fulivi/nanoprocessor_re/nanoprocessor.pdf

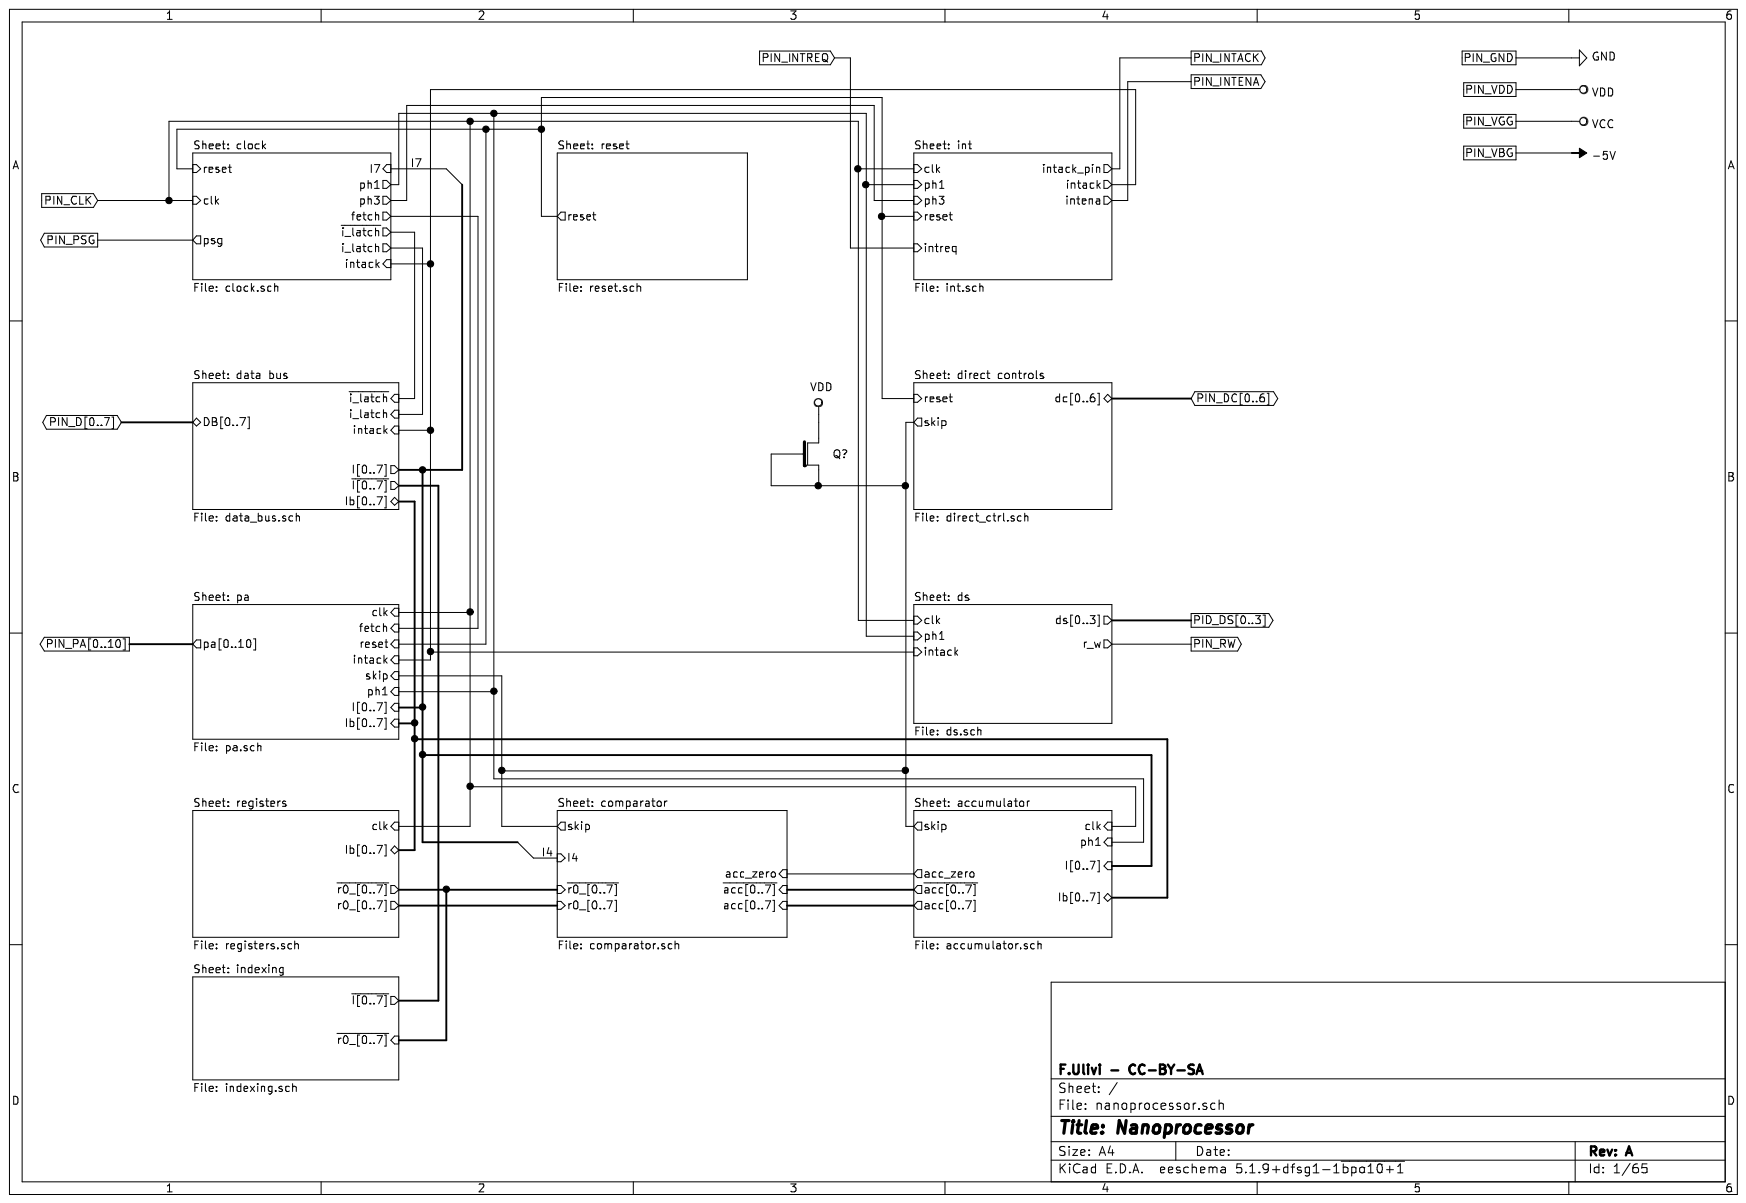
[picture p1: page 1]

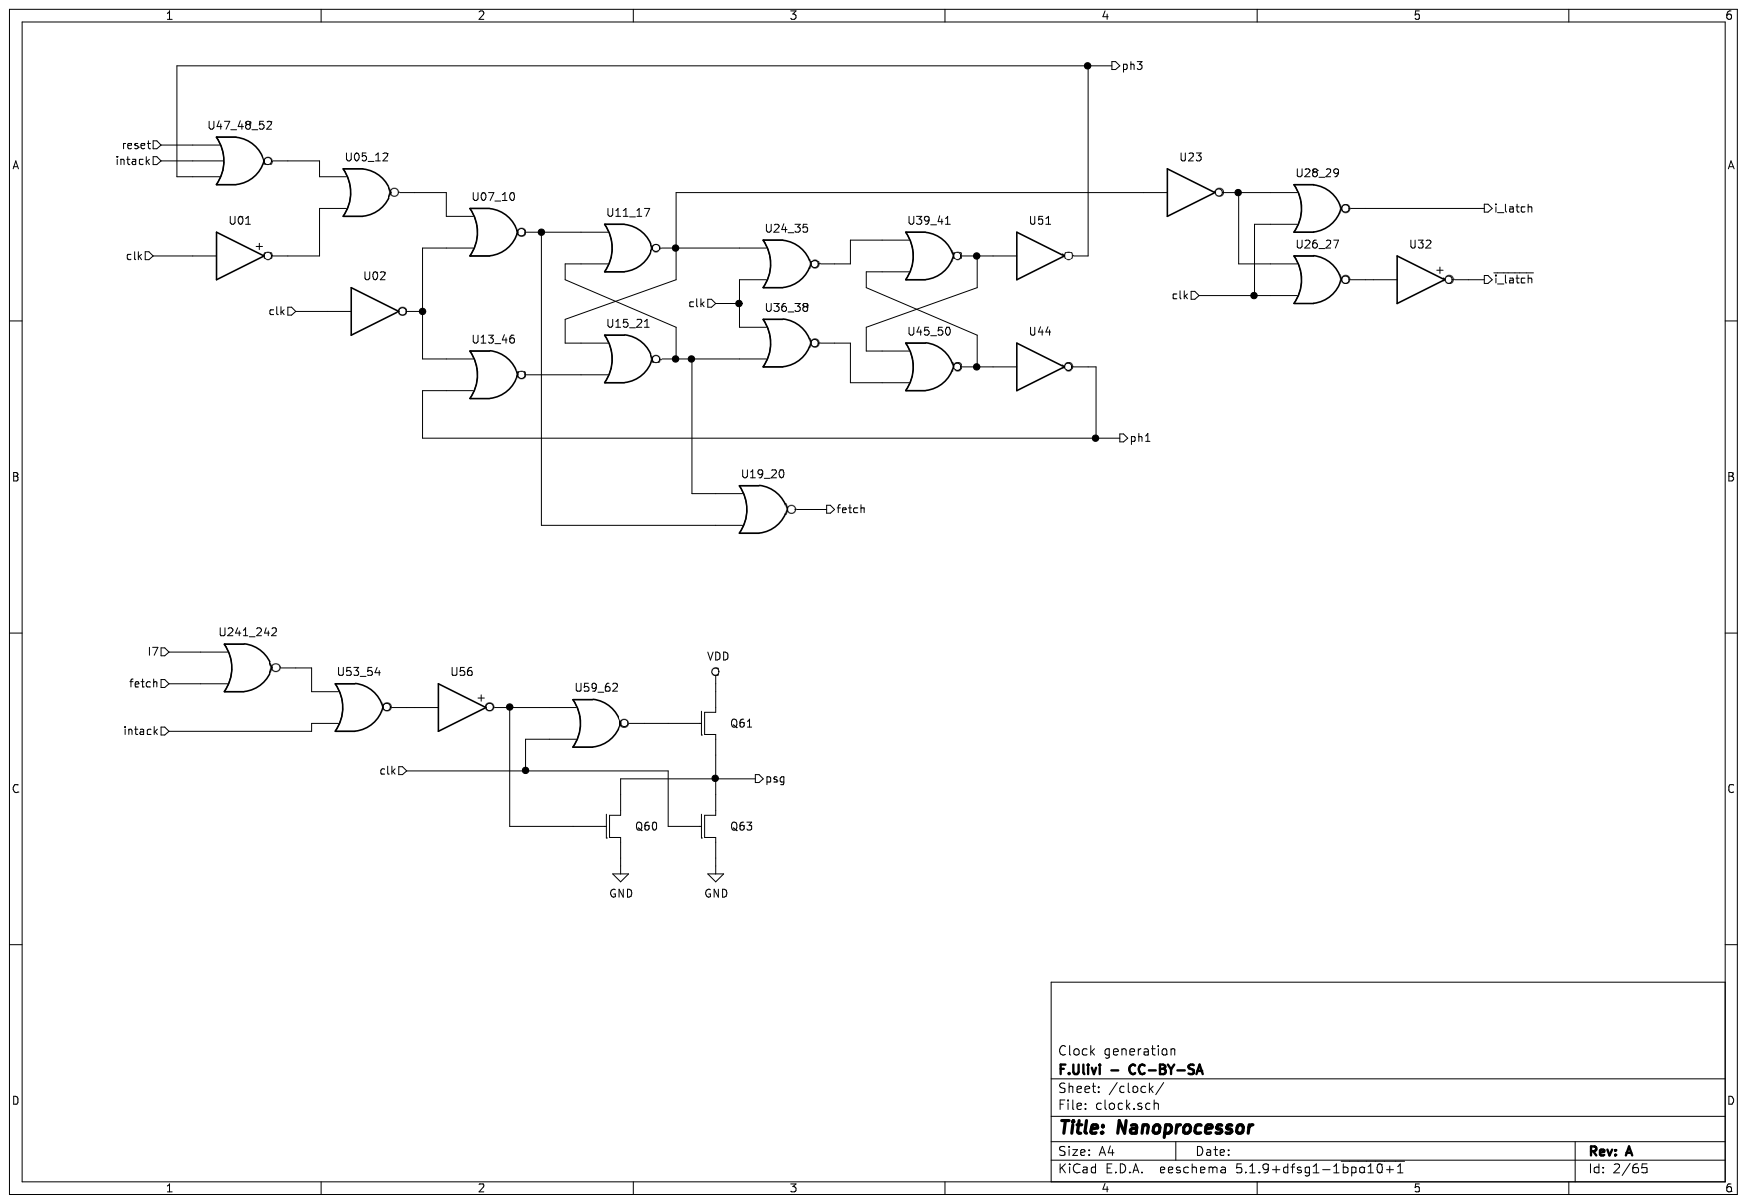
[picture p2: page 2]

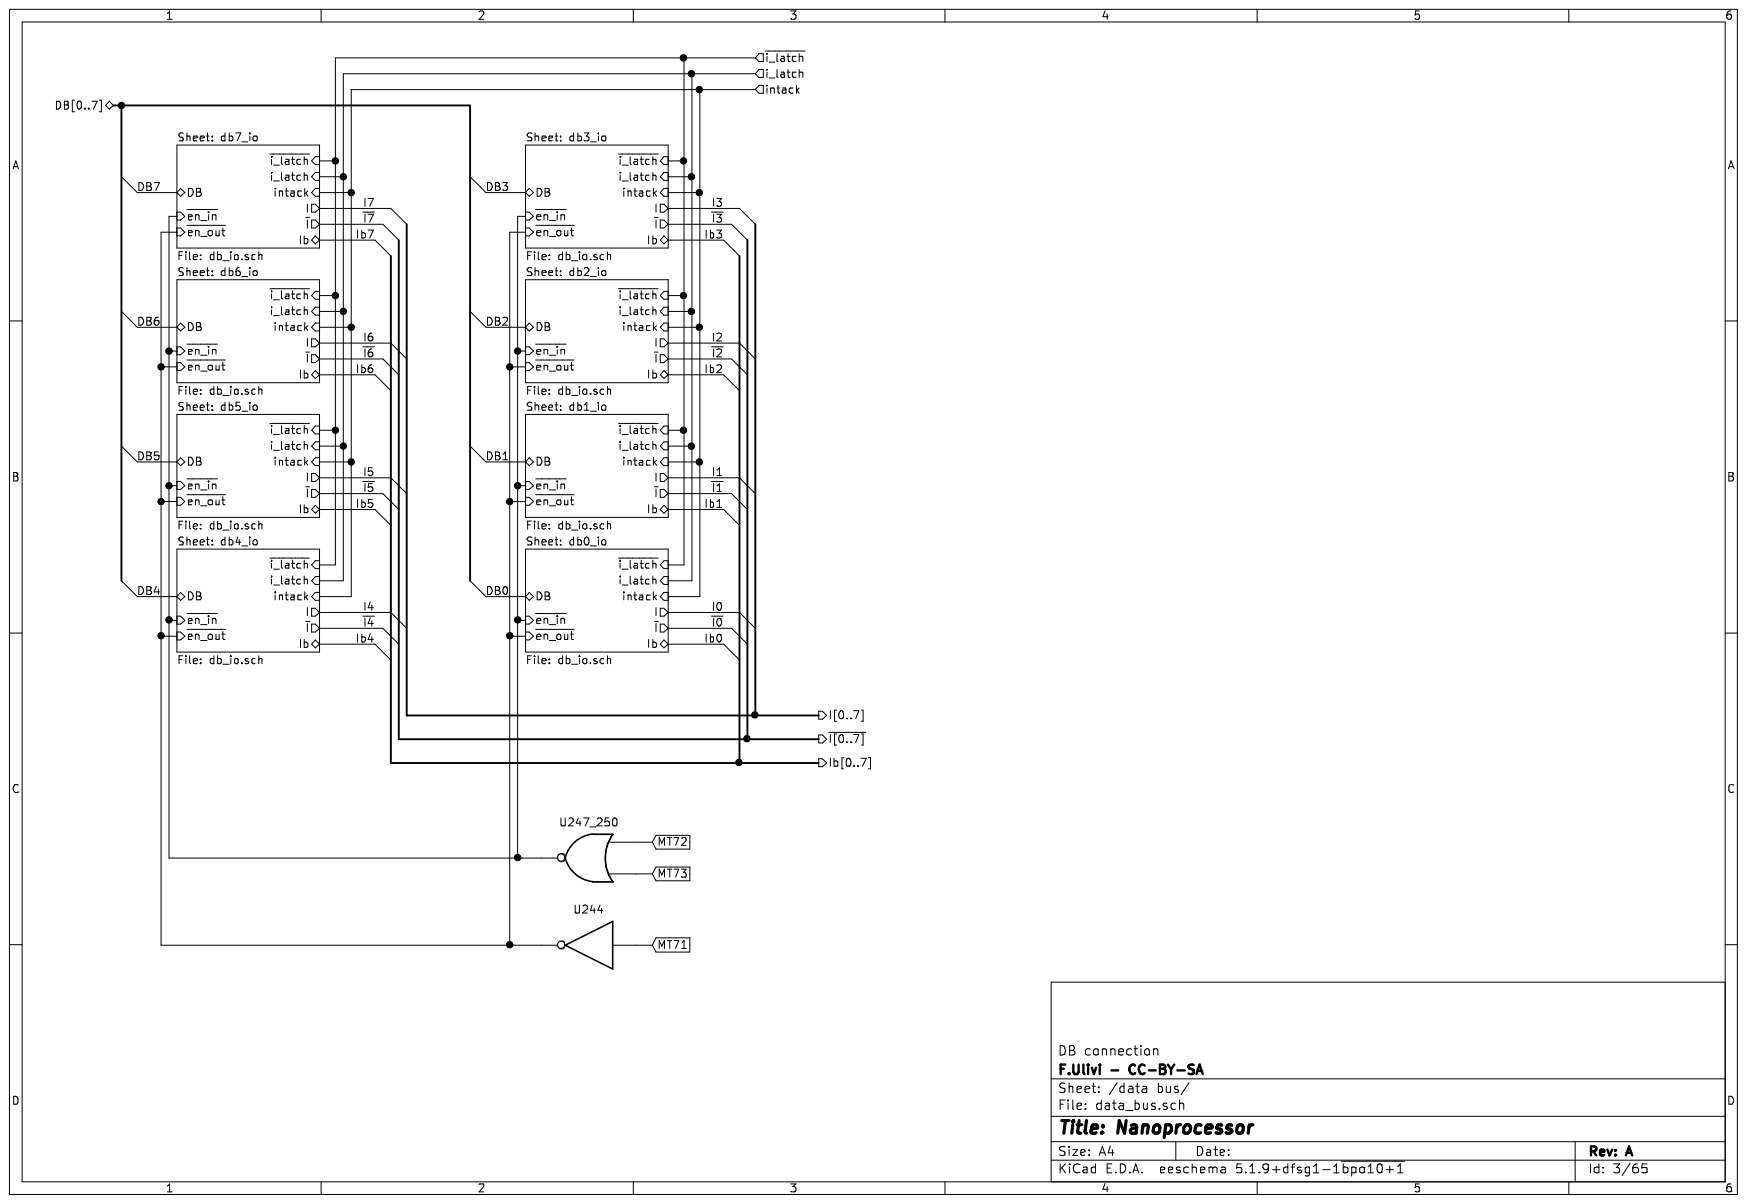
[picture p3: page 3]

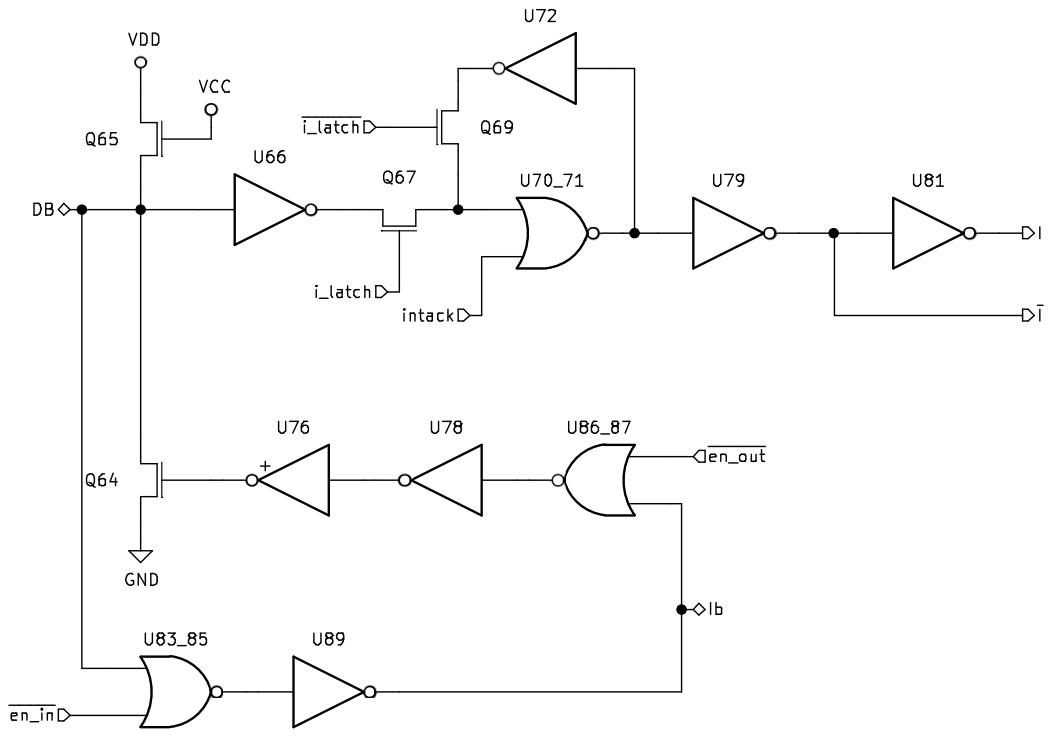
[picture p4: page 4]

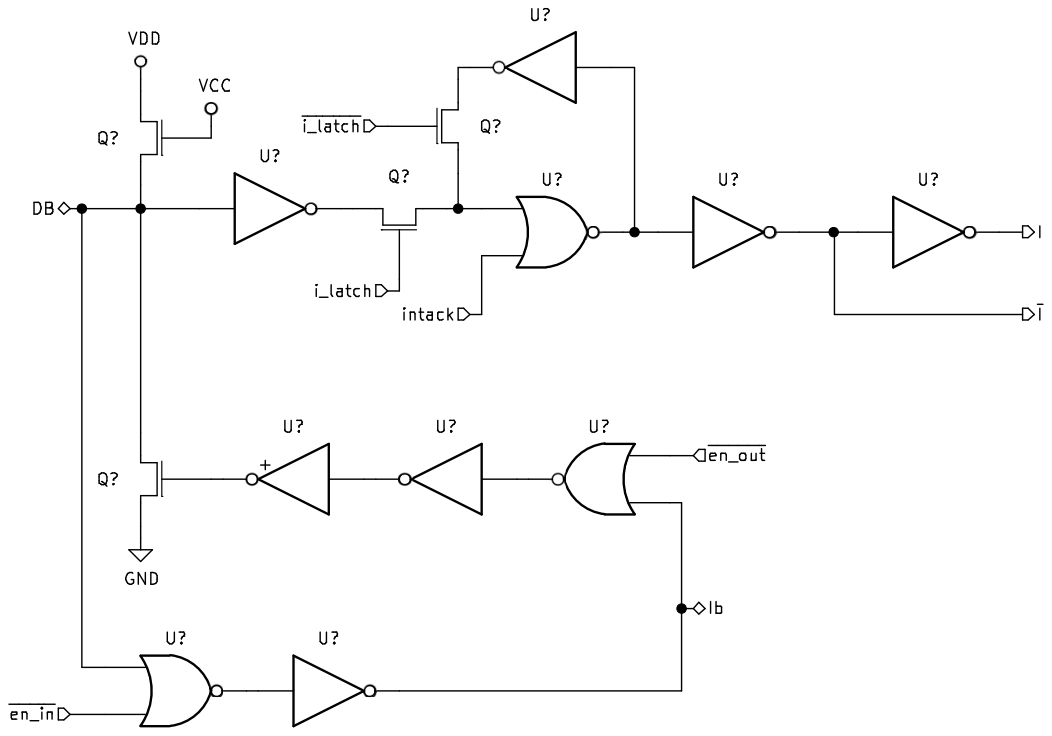
[picture p5: page 5]

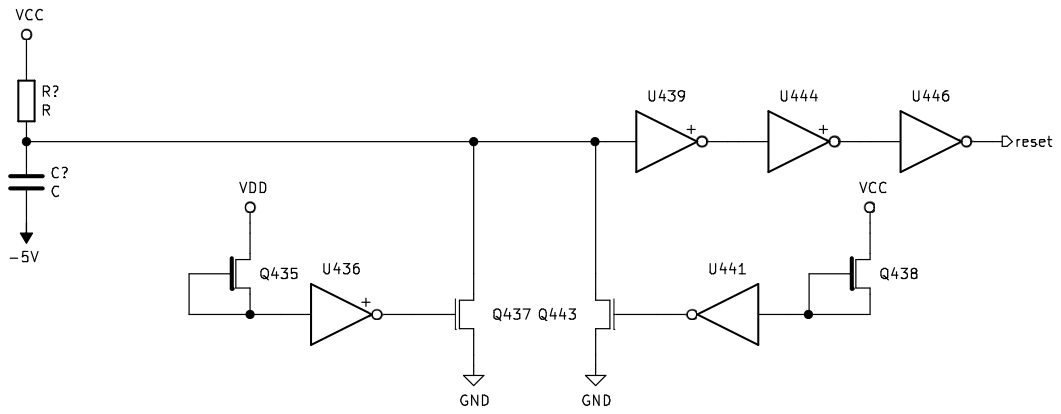
[picture p6: page 12]

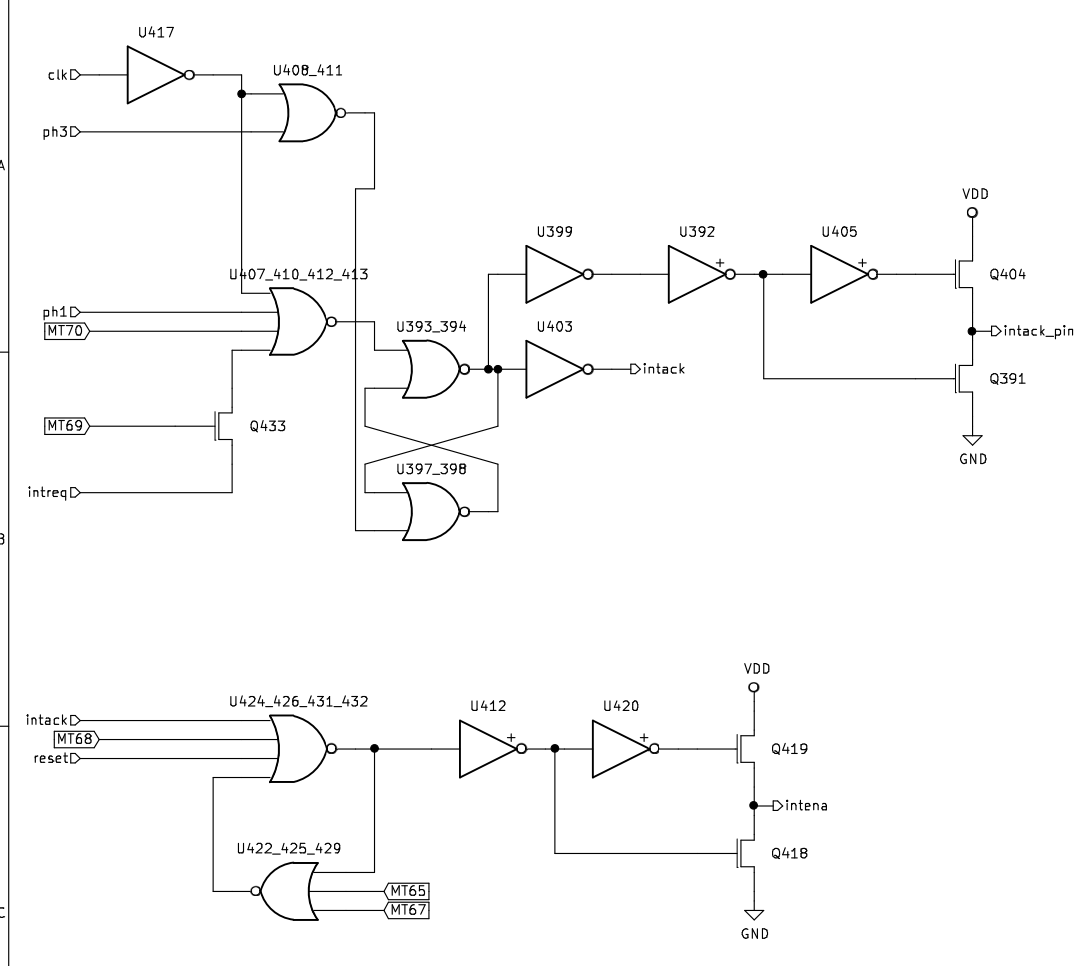
[picture p7: page 13]

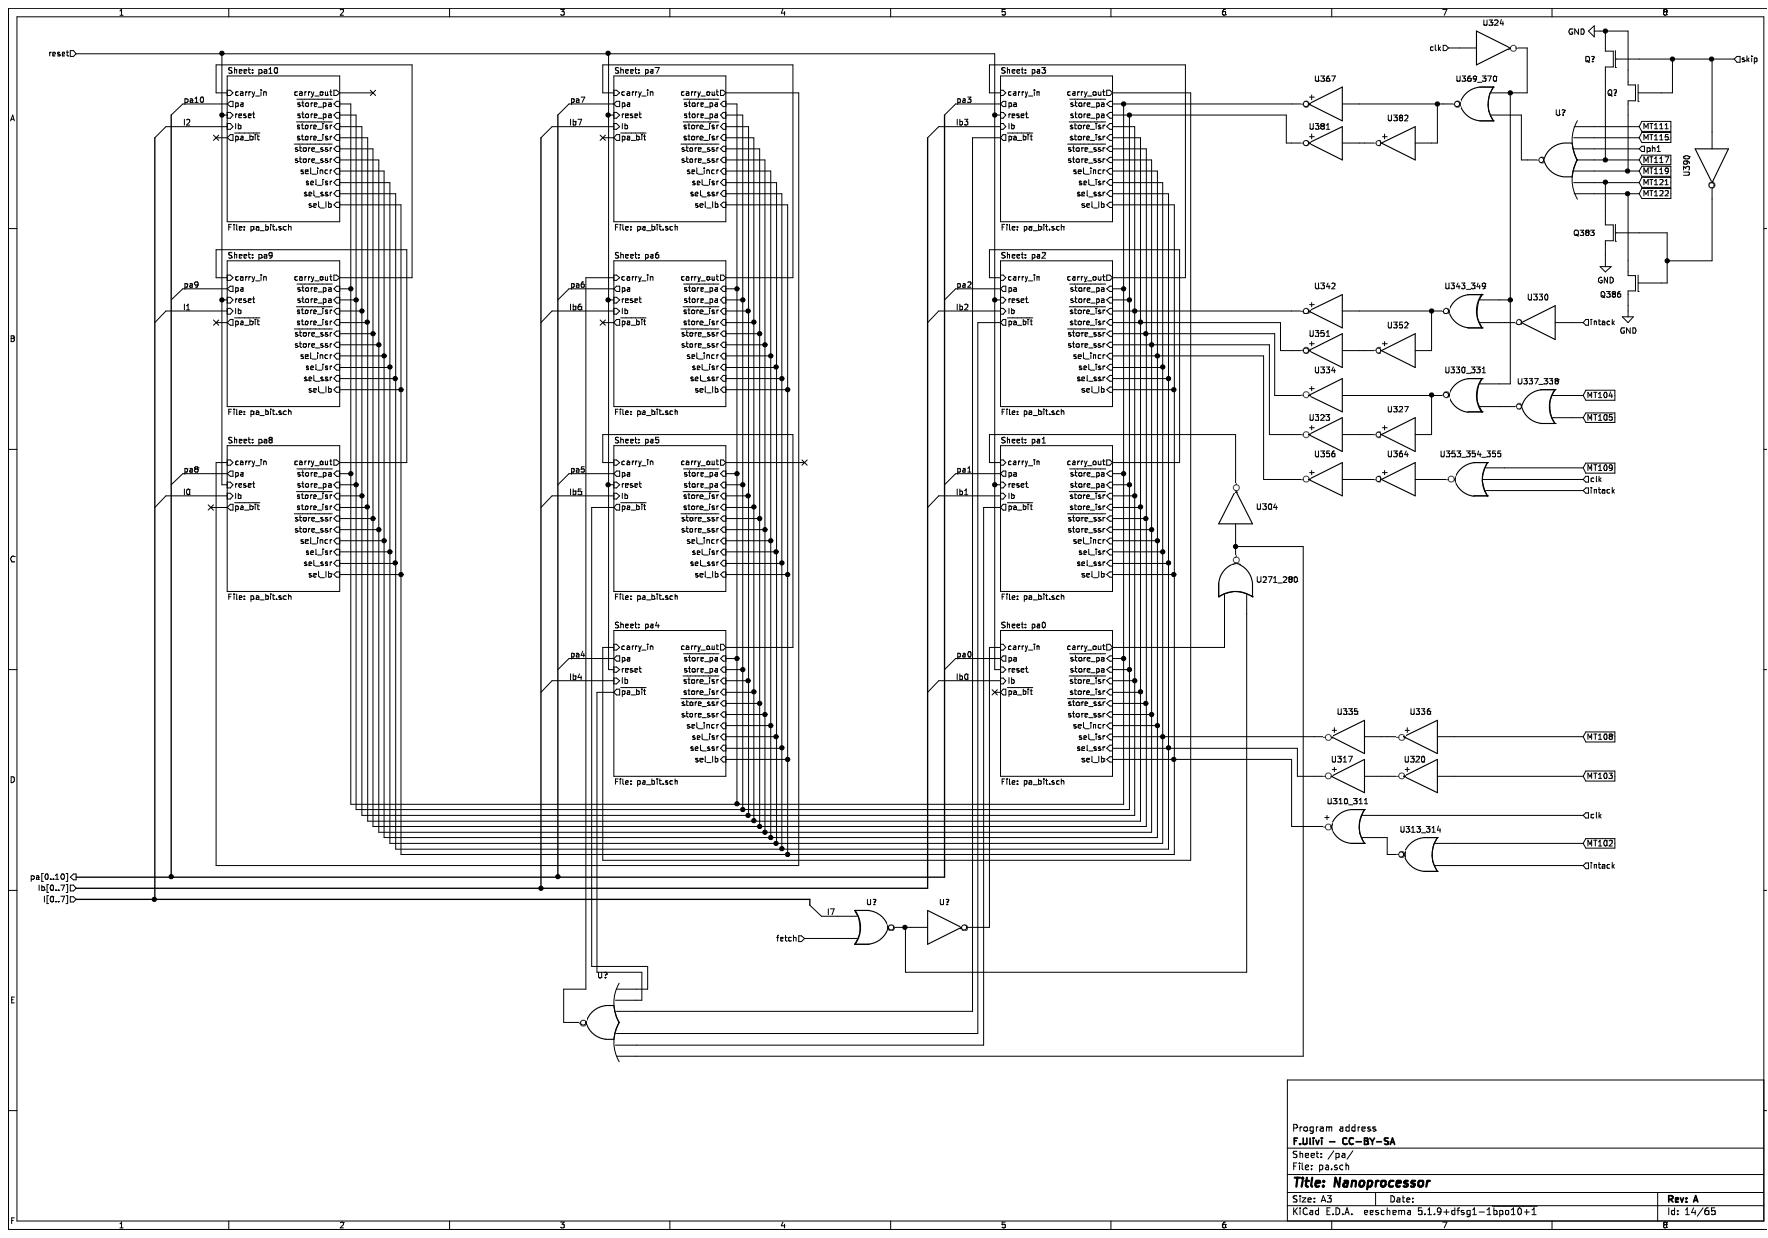
[picture p8: page 14]

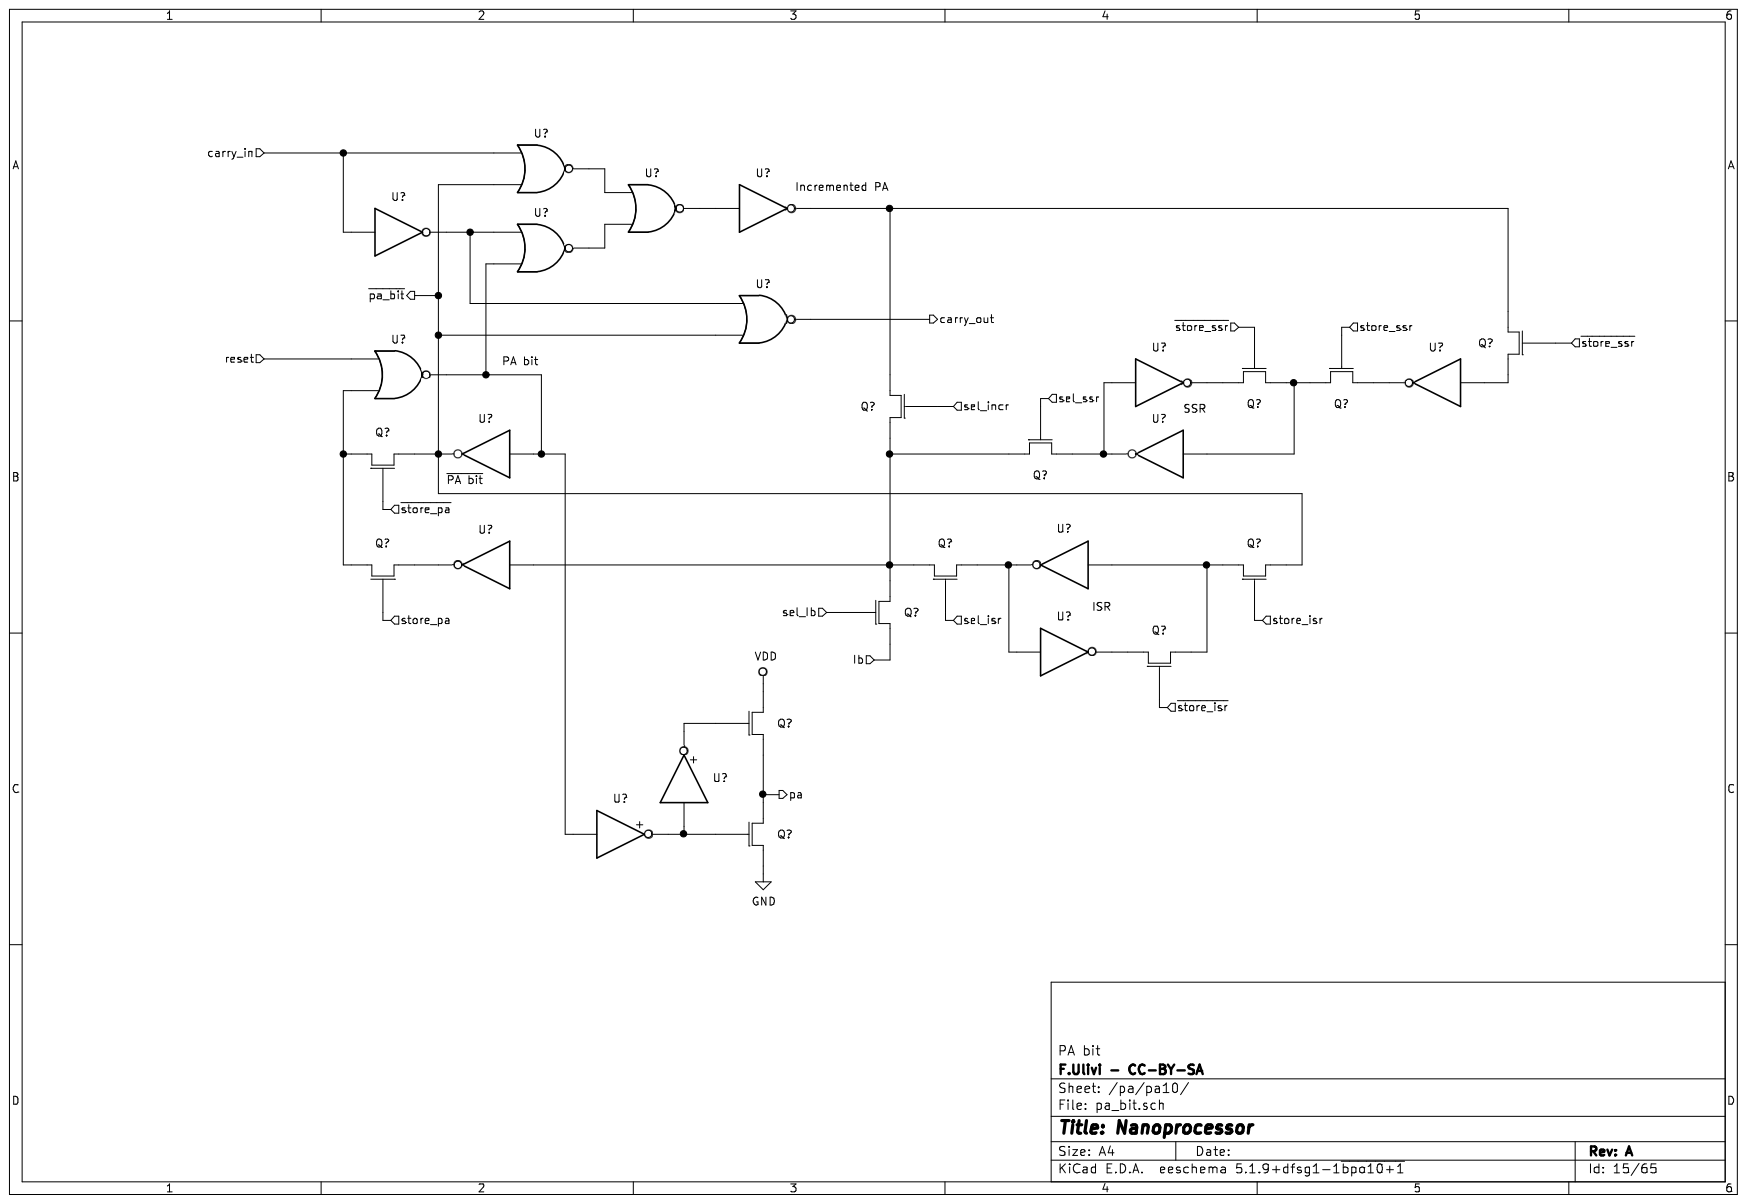
[picture p9: page 15]

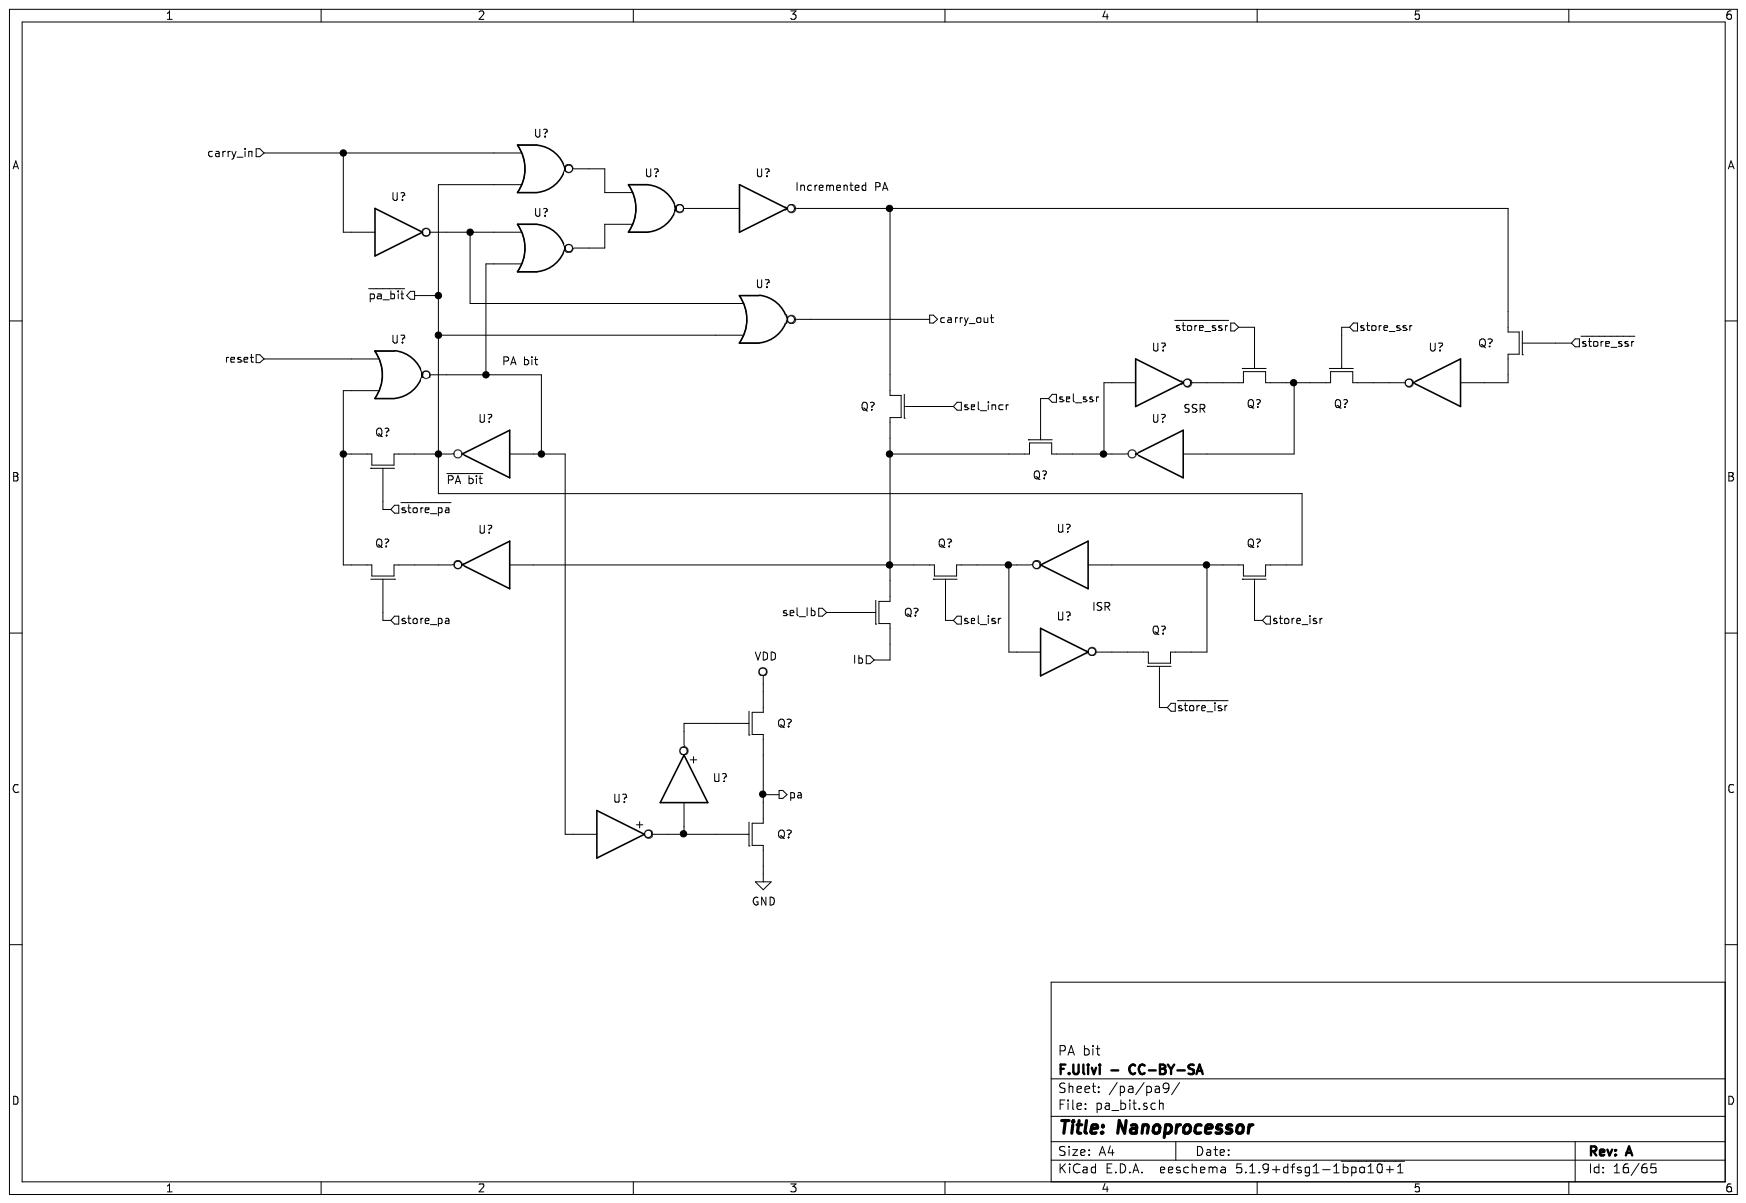
[picture p10: page 16]

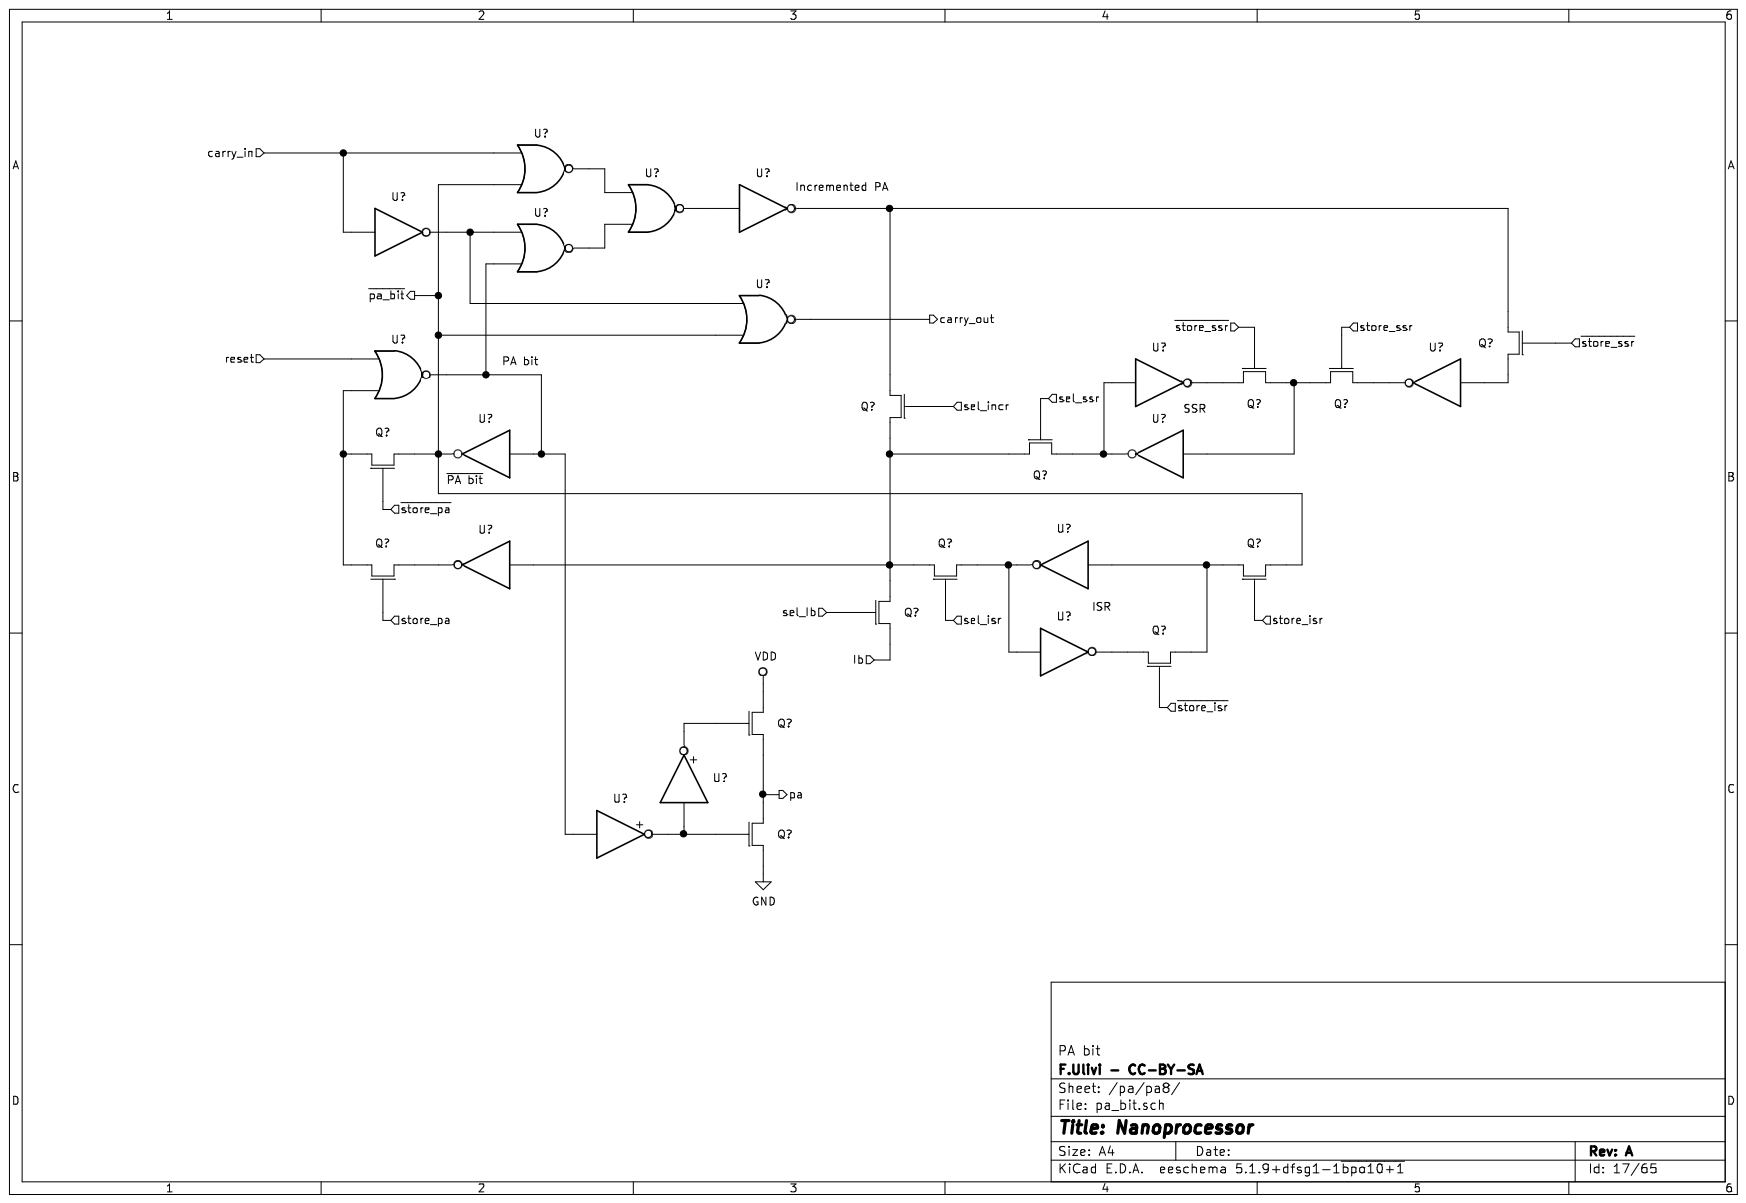
[picture p11: page 17]

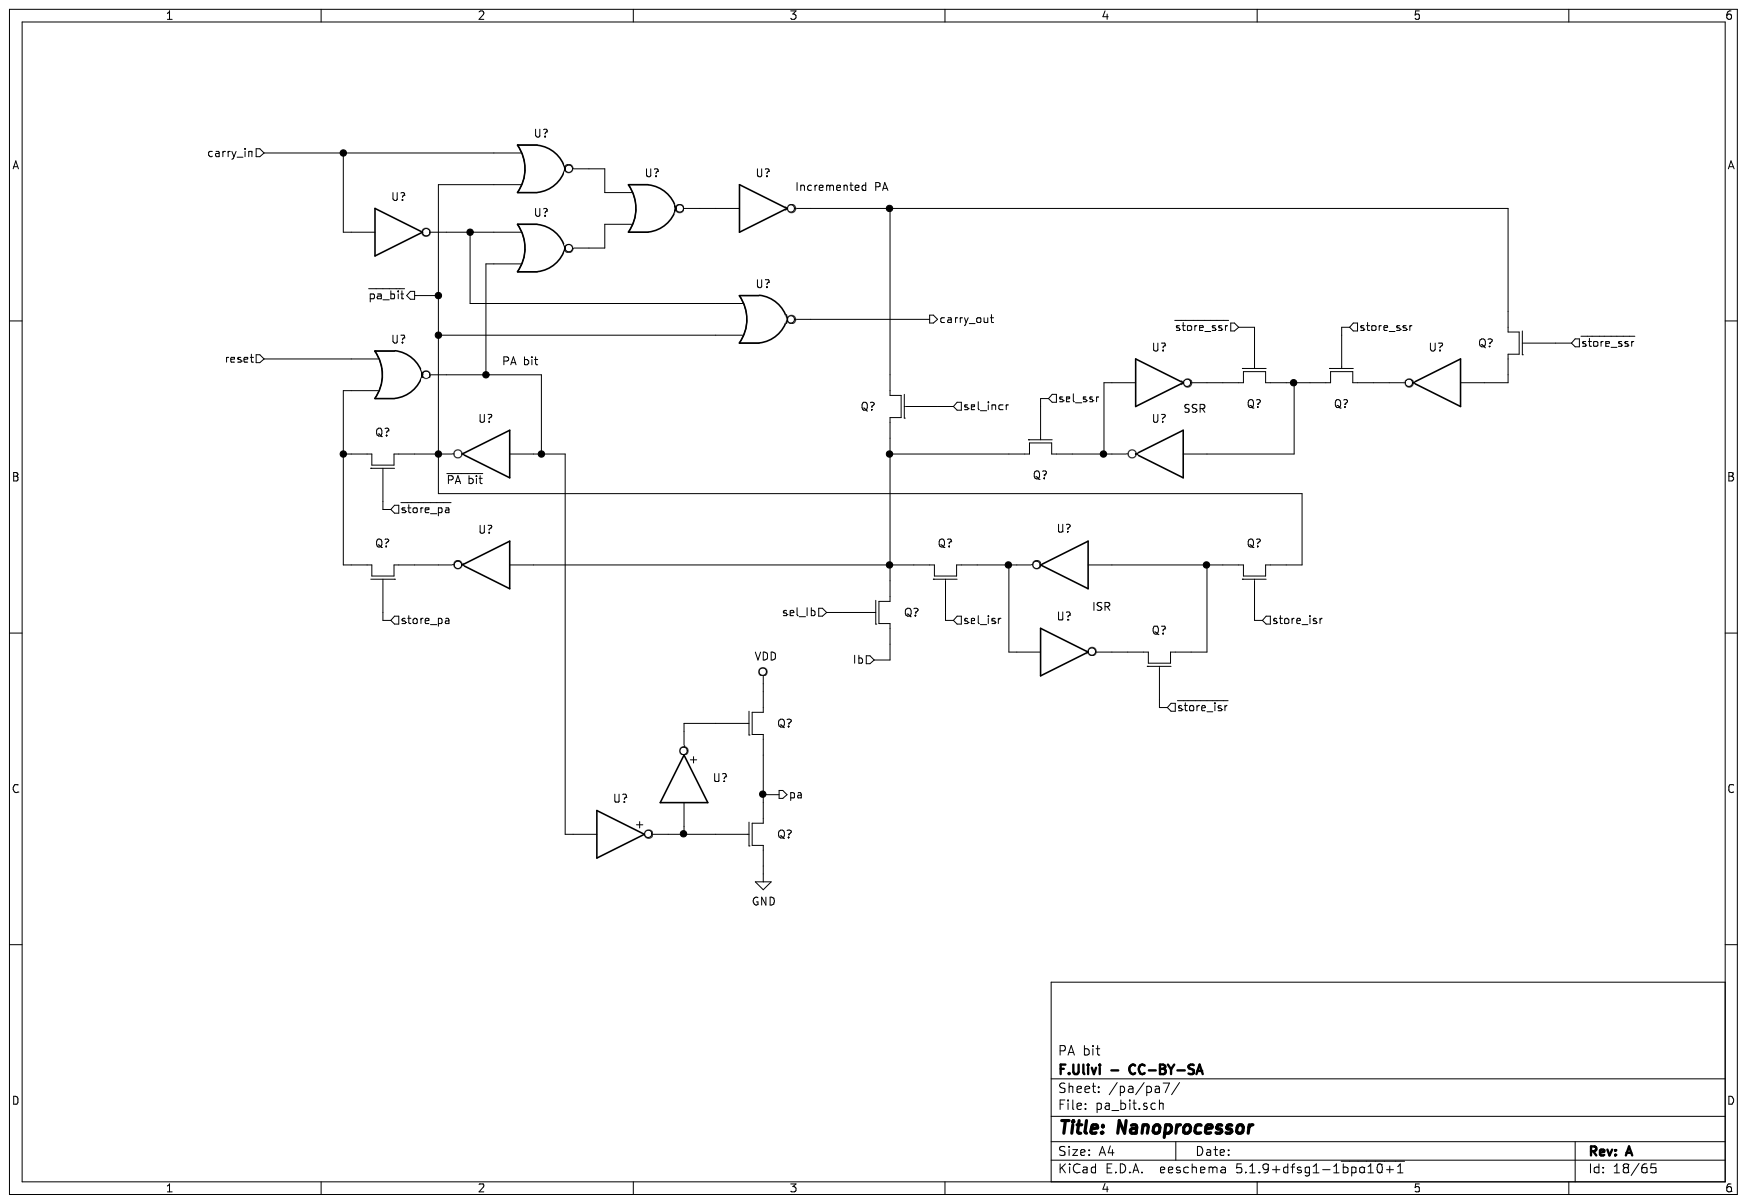
[picture p12: page 18]

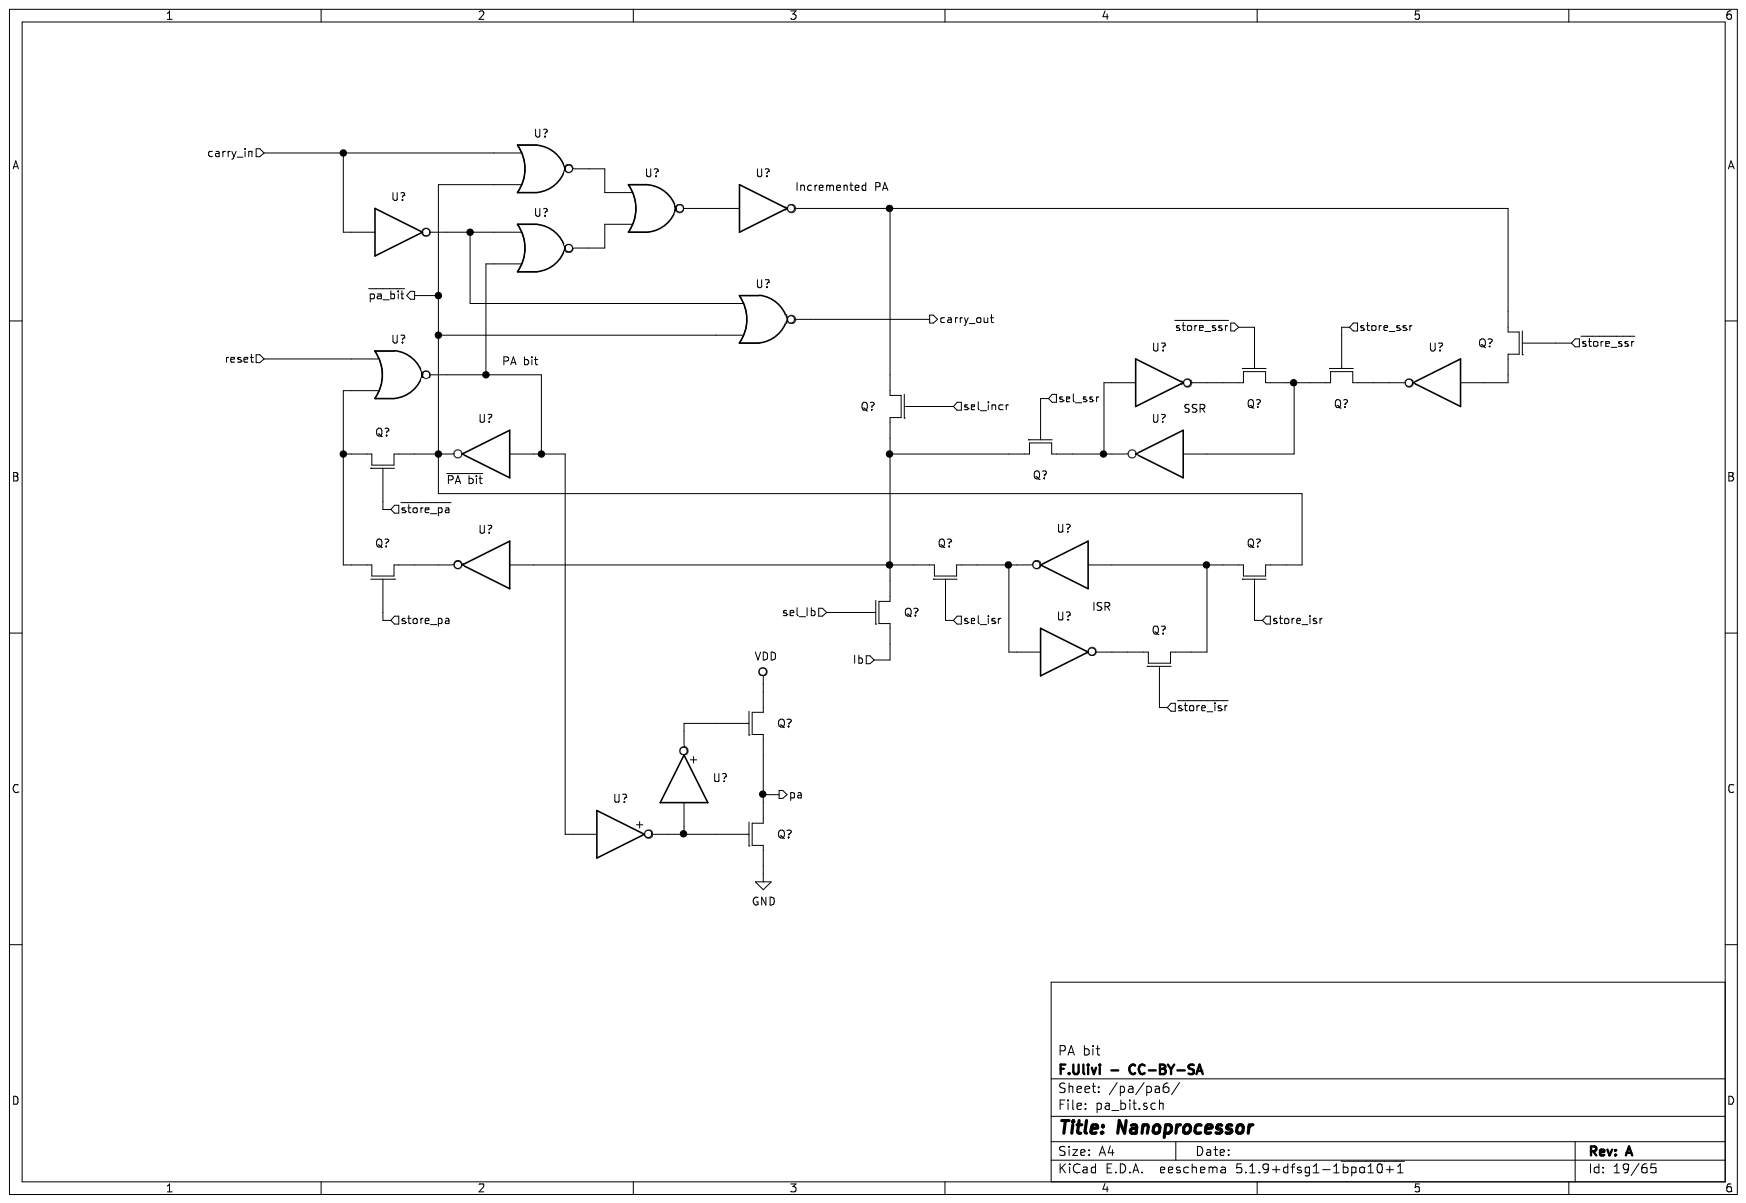
[picture p13: page 19]

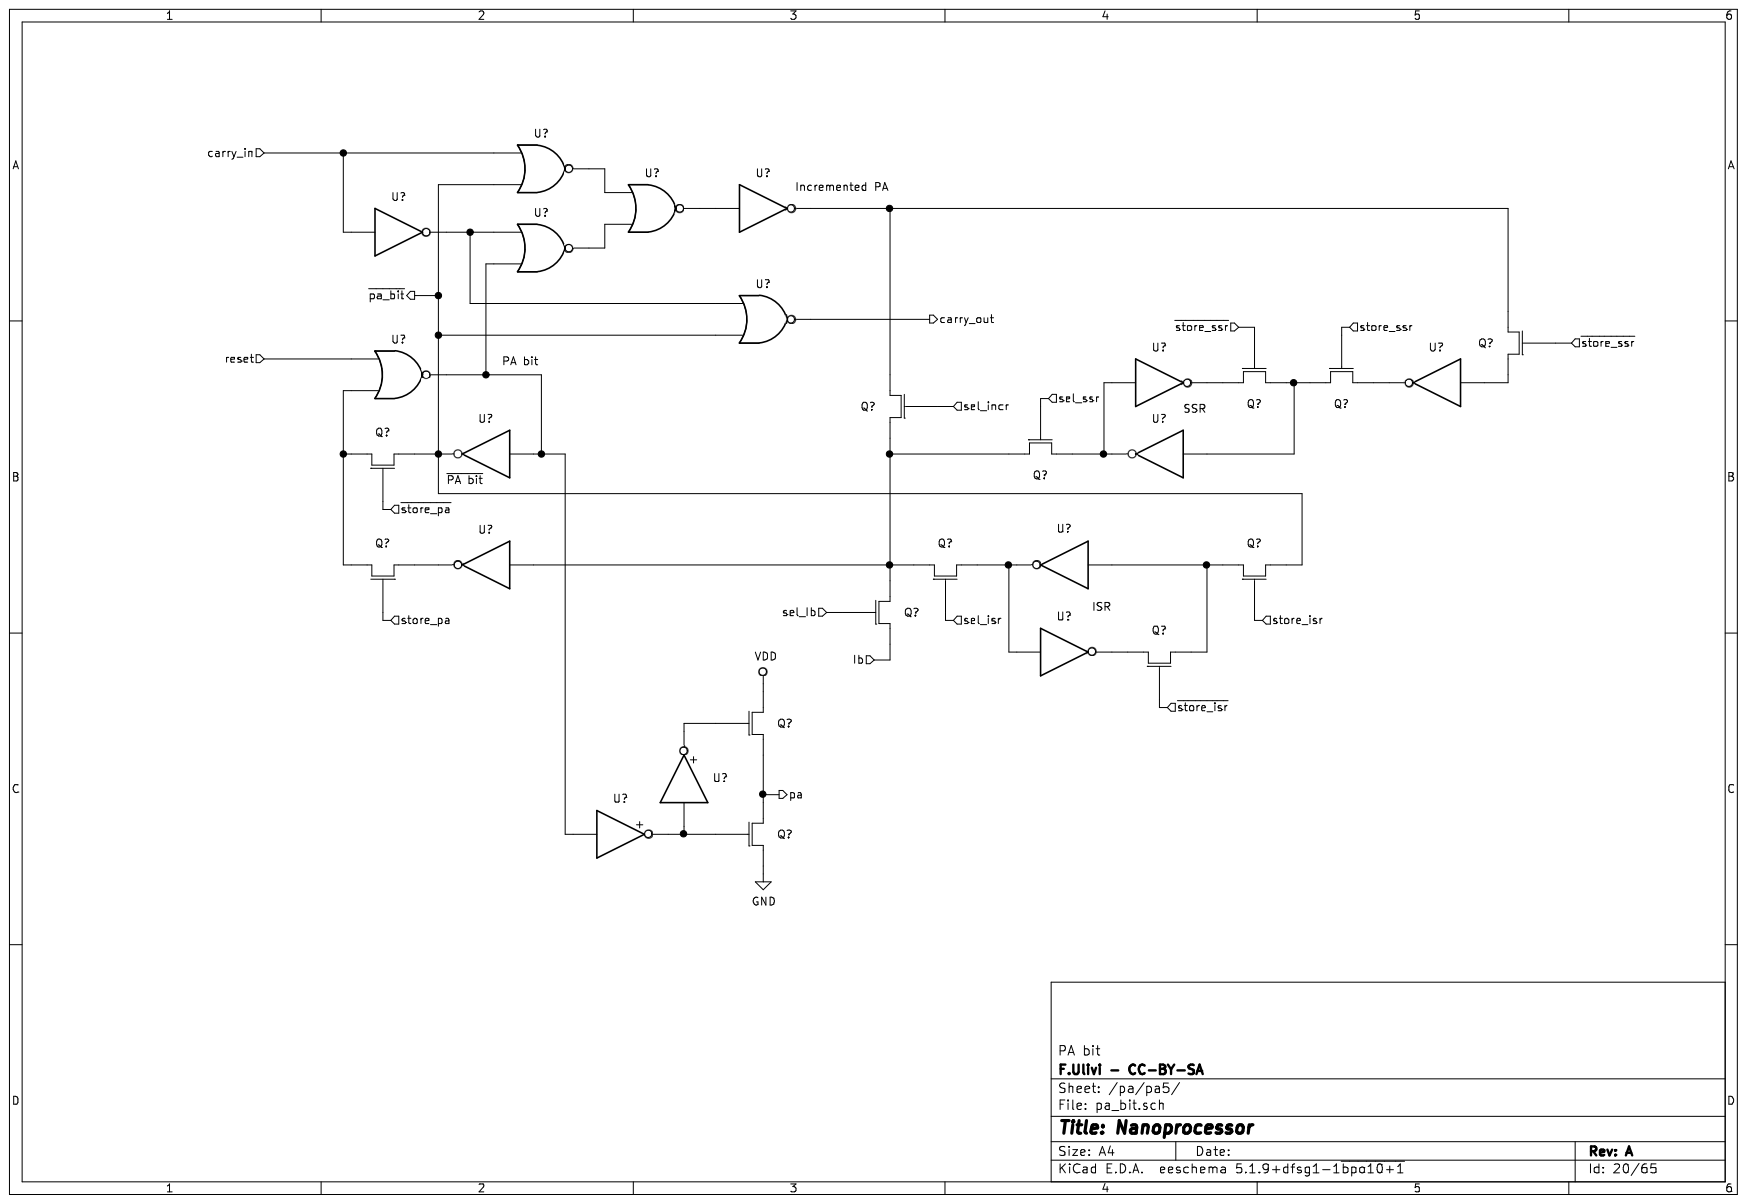
[picture p14: page 20]

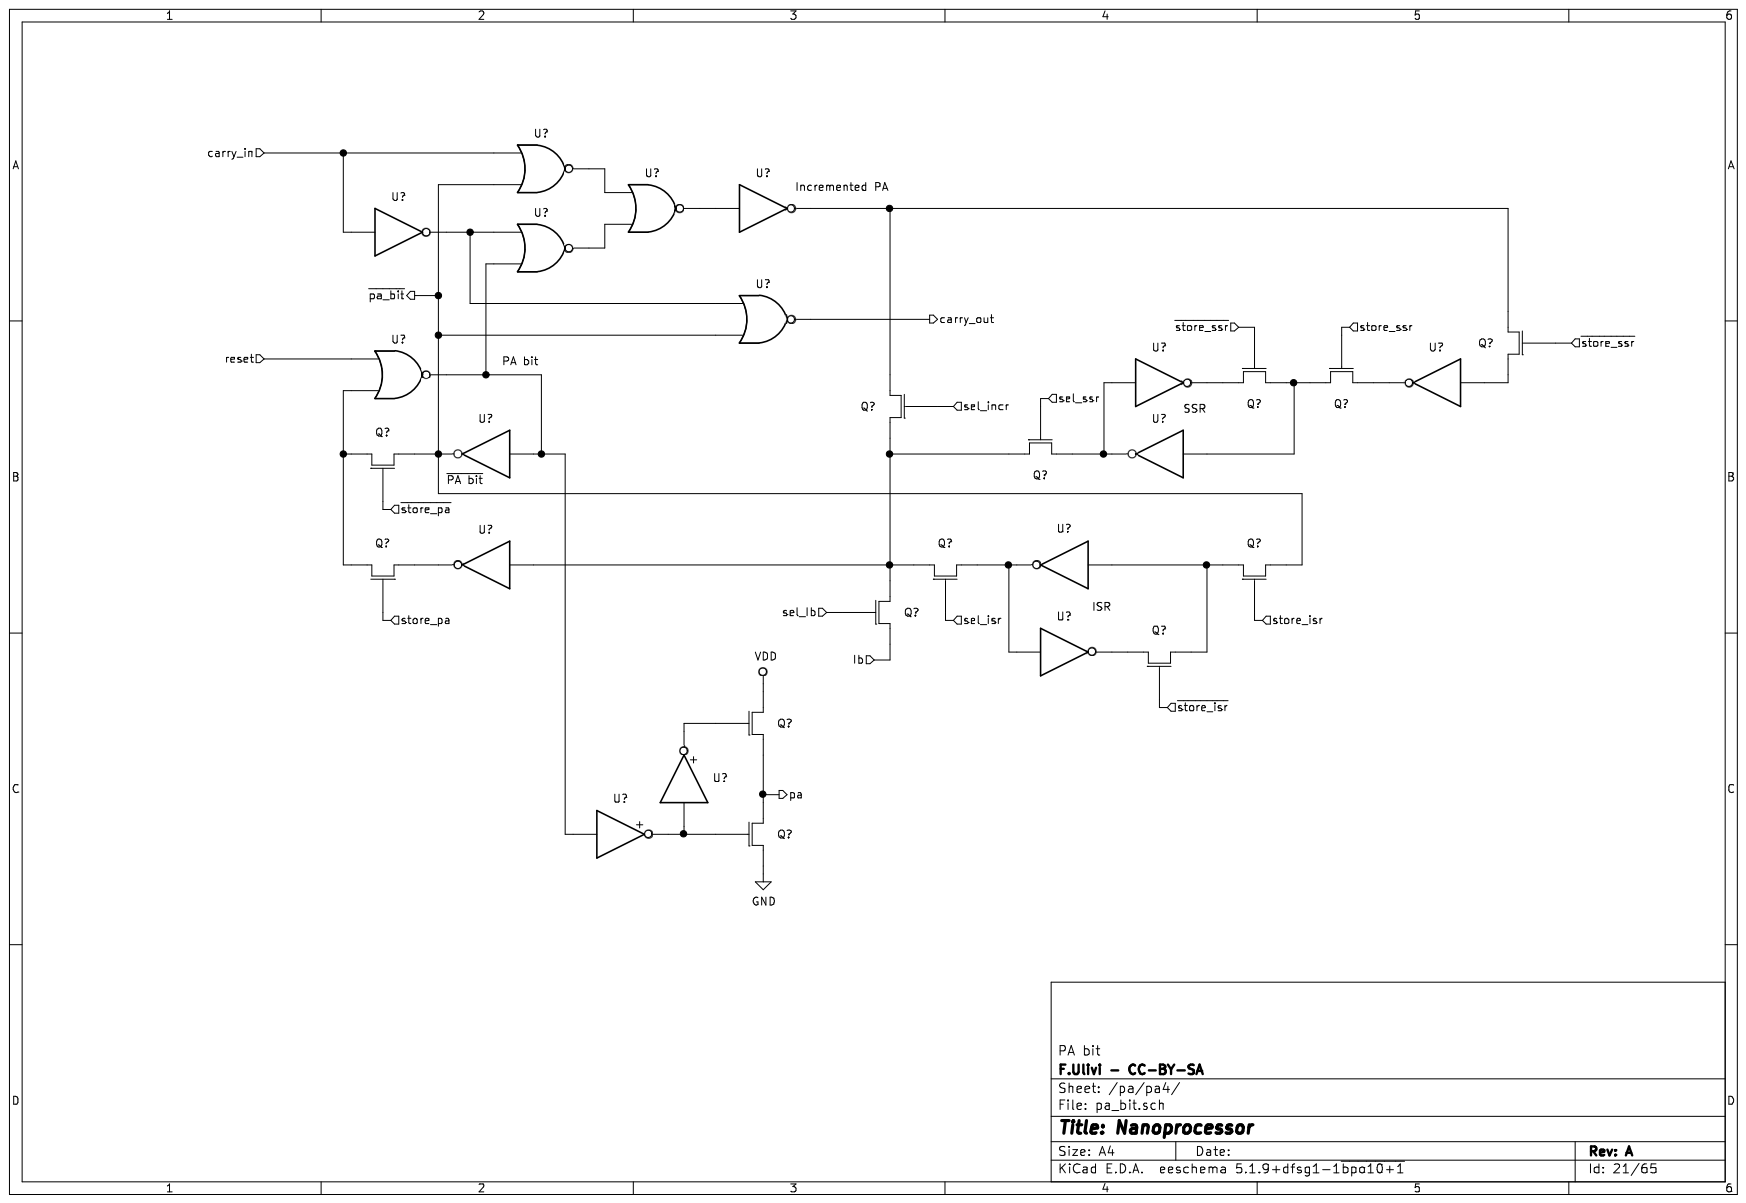
[picture p15: page 21]

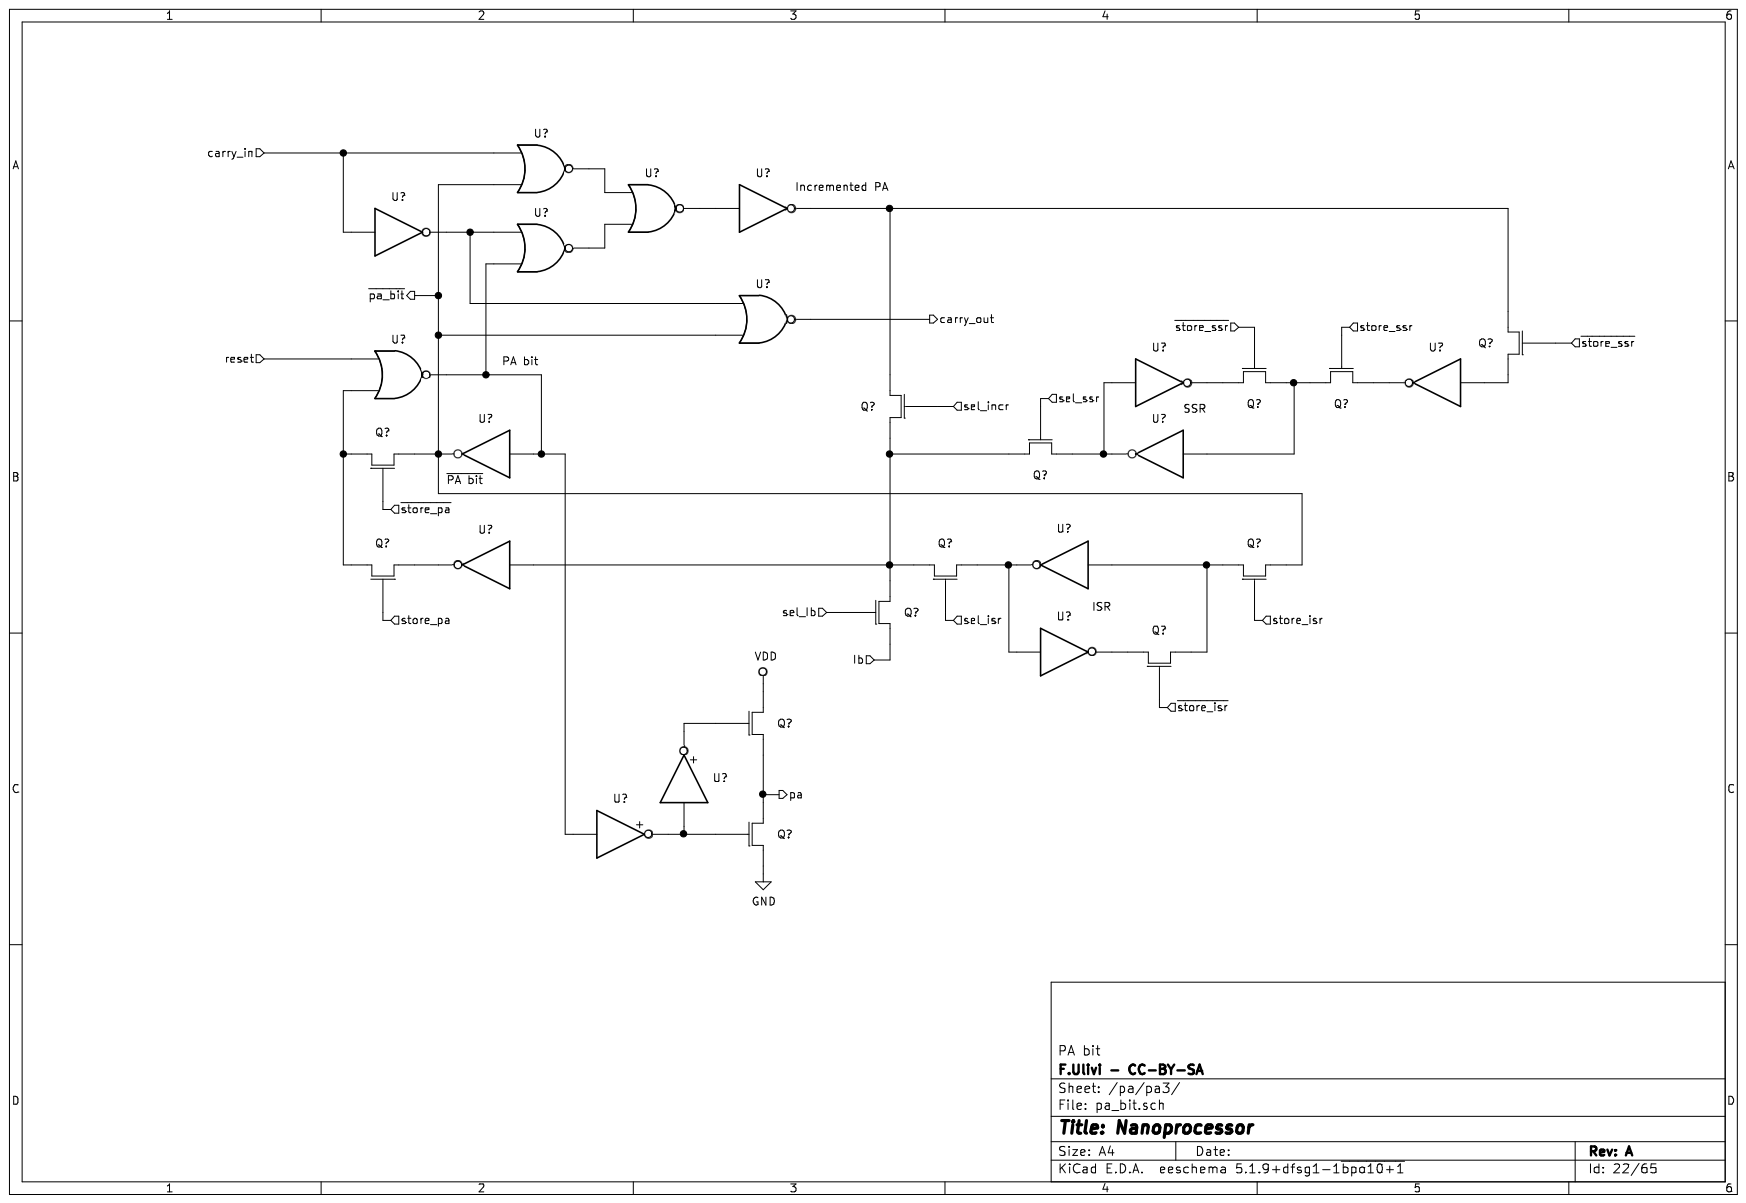
[picture p16: page 22]

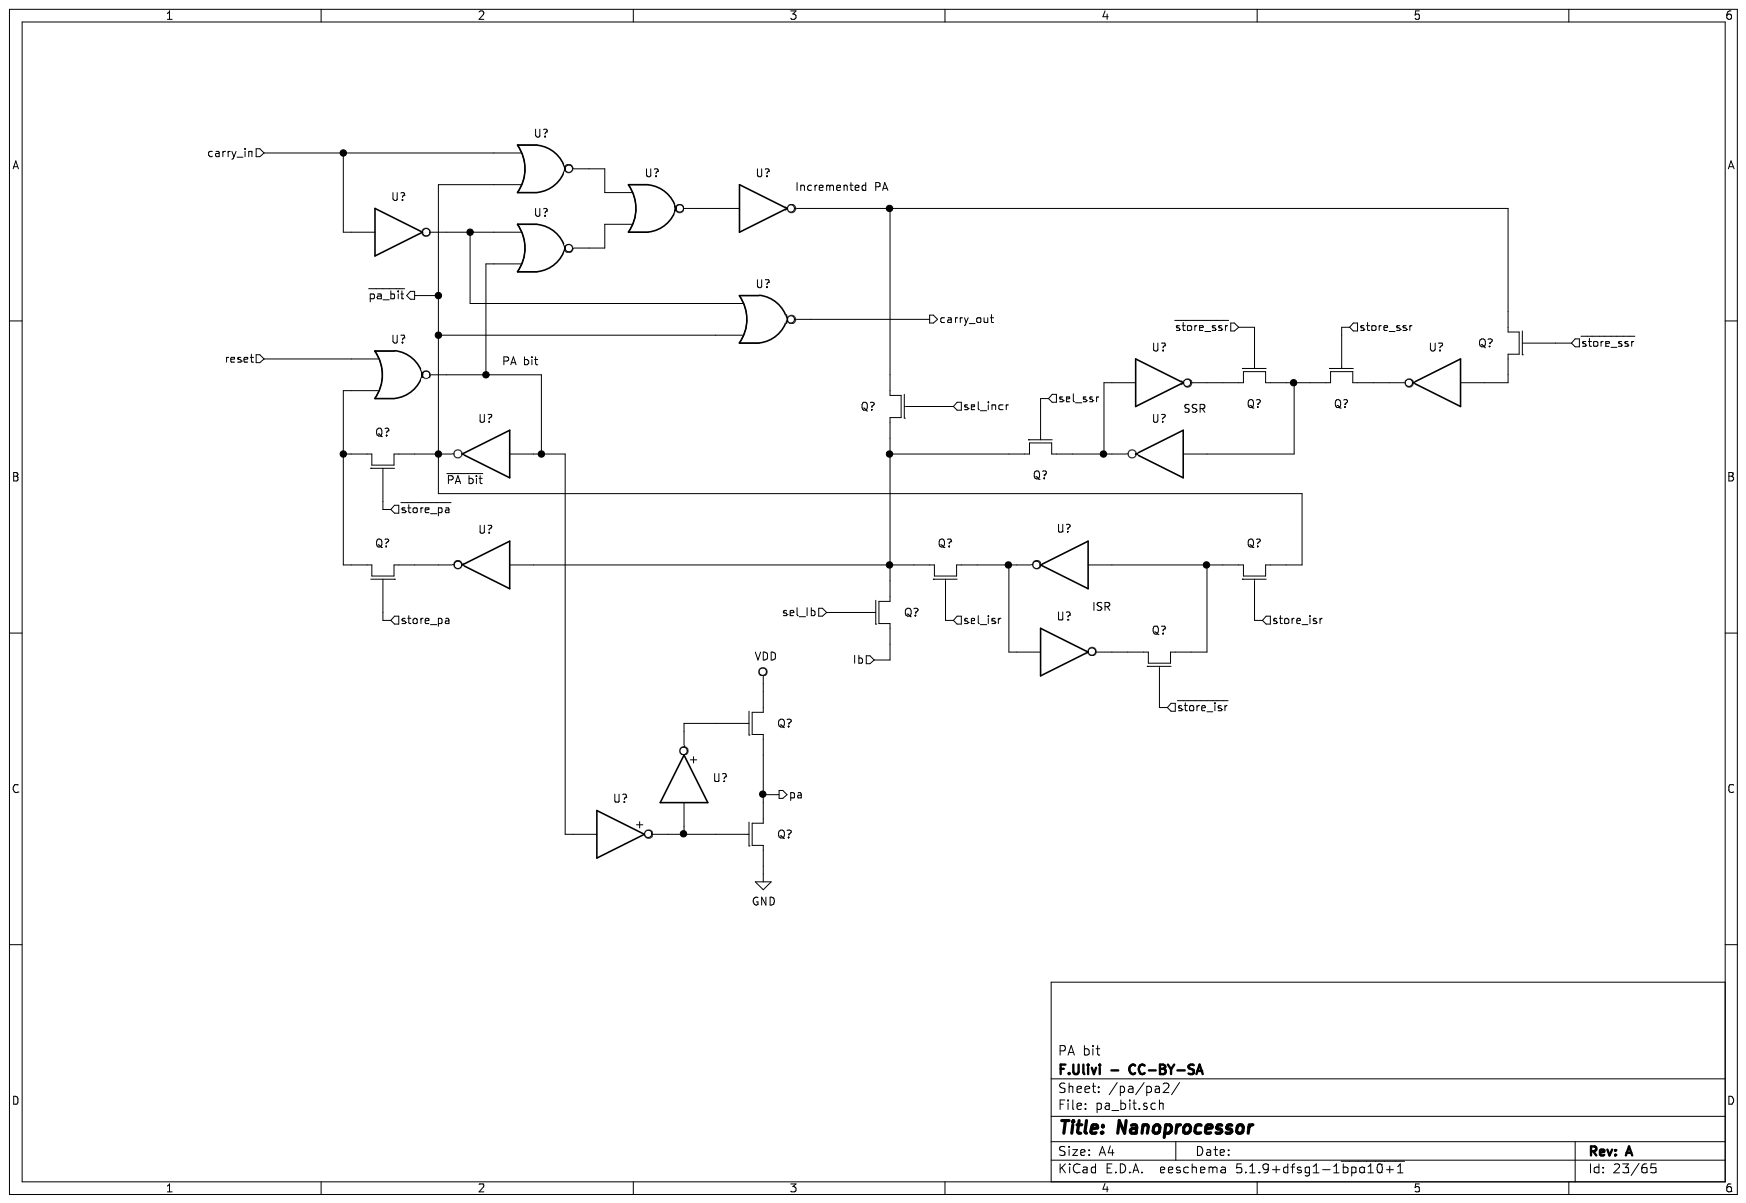
[picture p17: page 23]

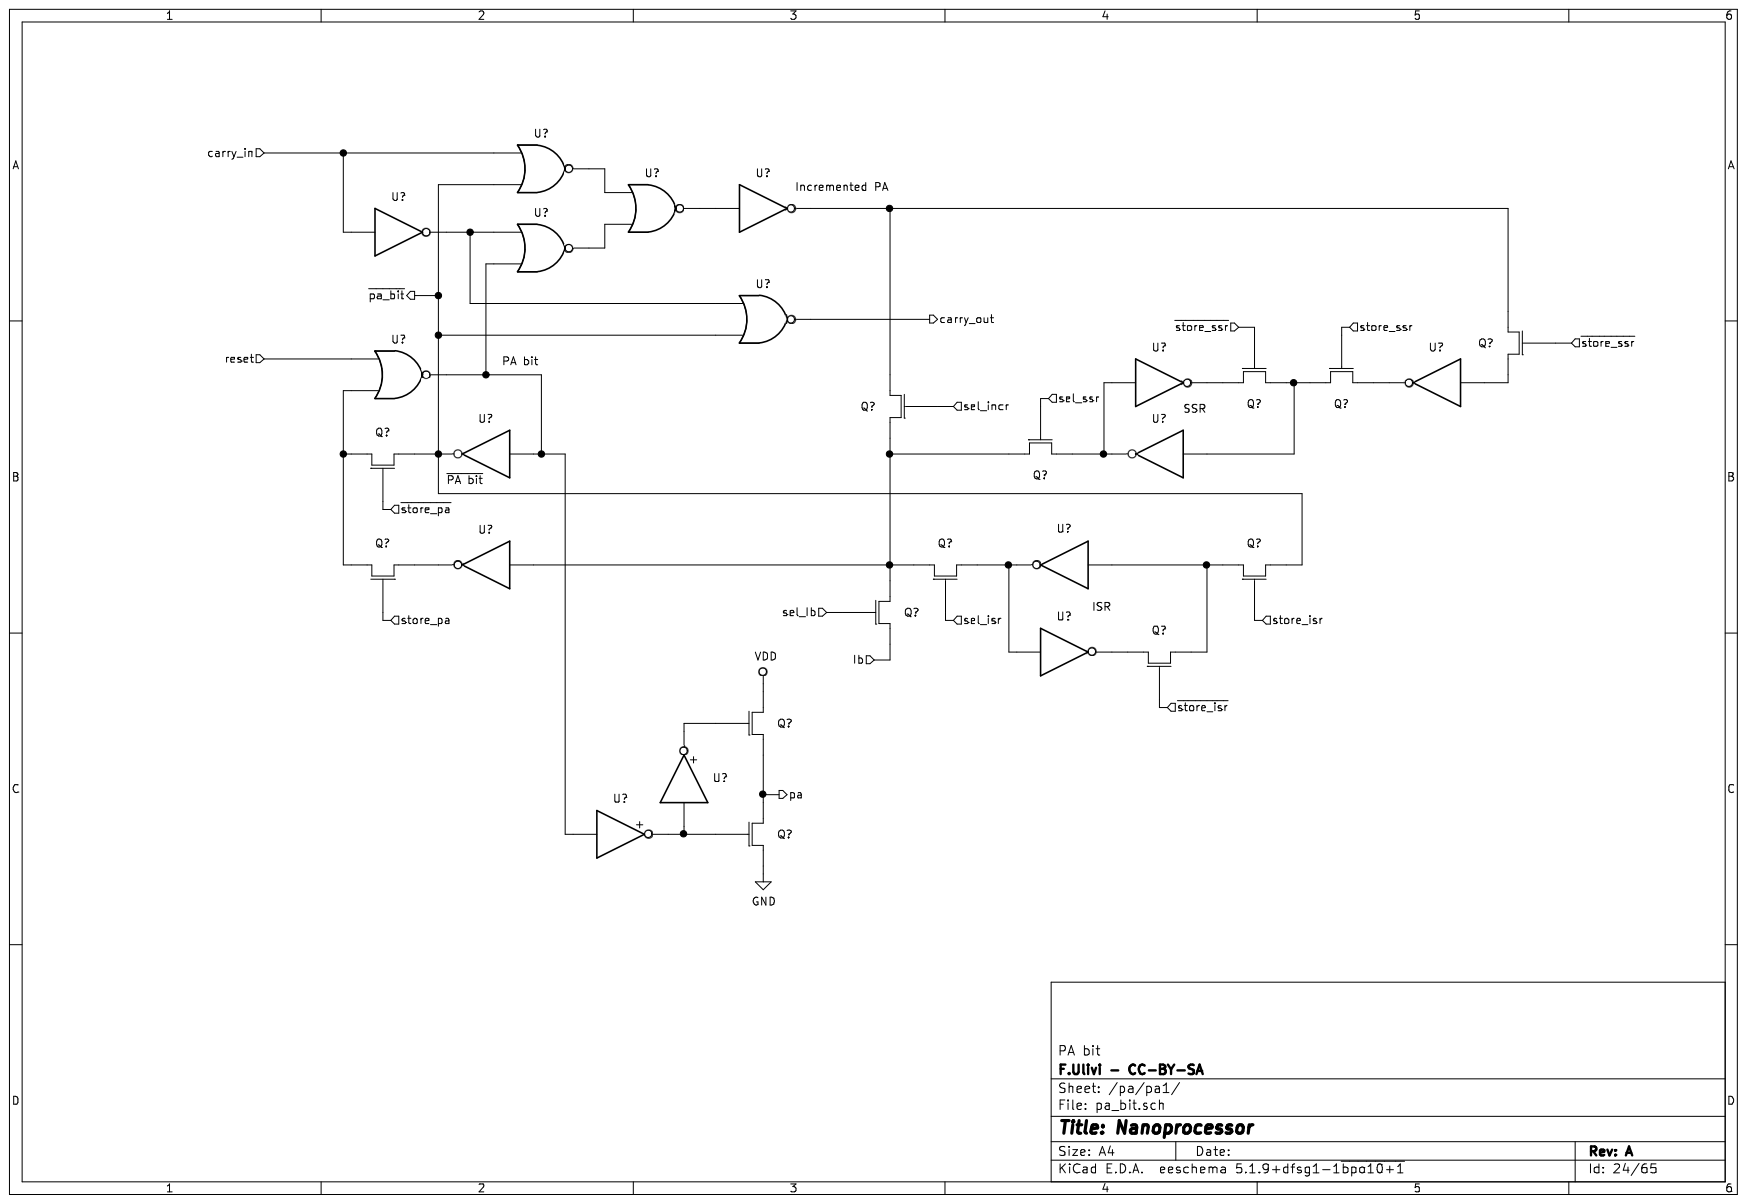
[picture p18: page 24]

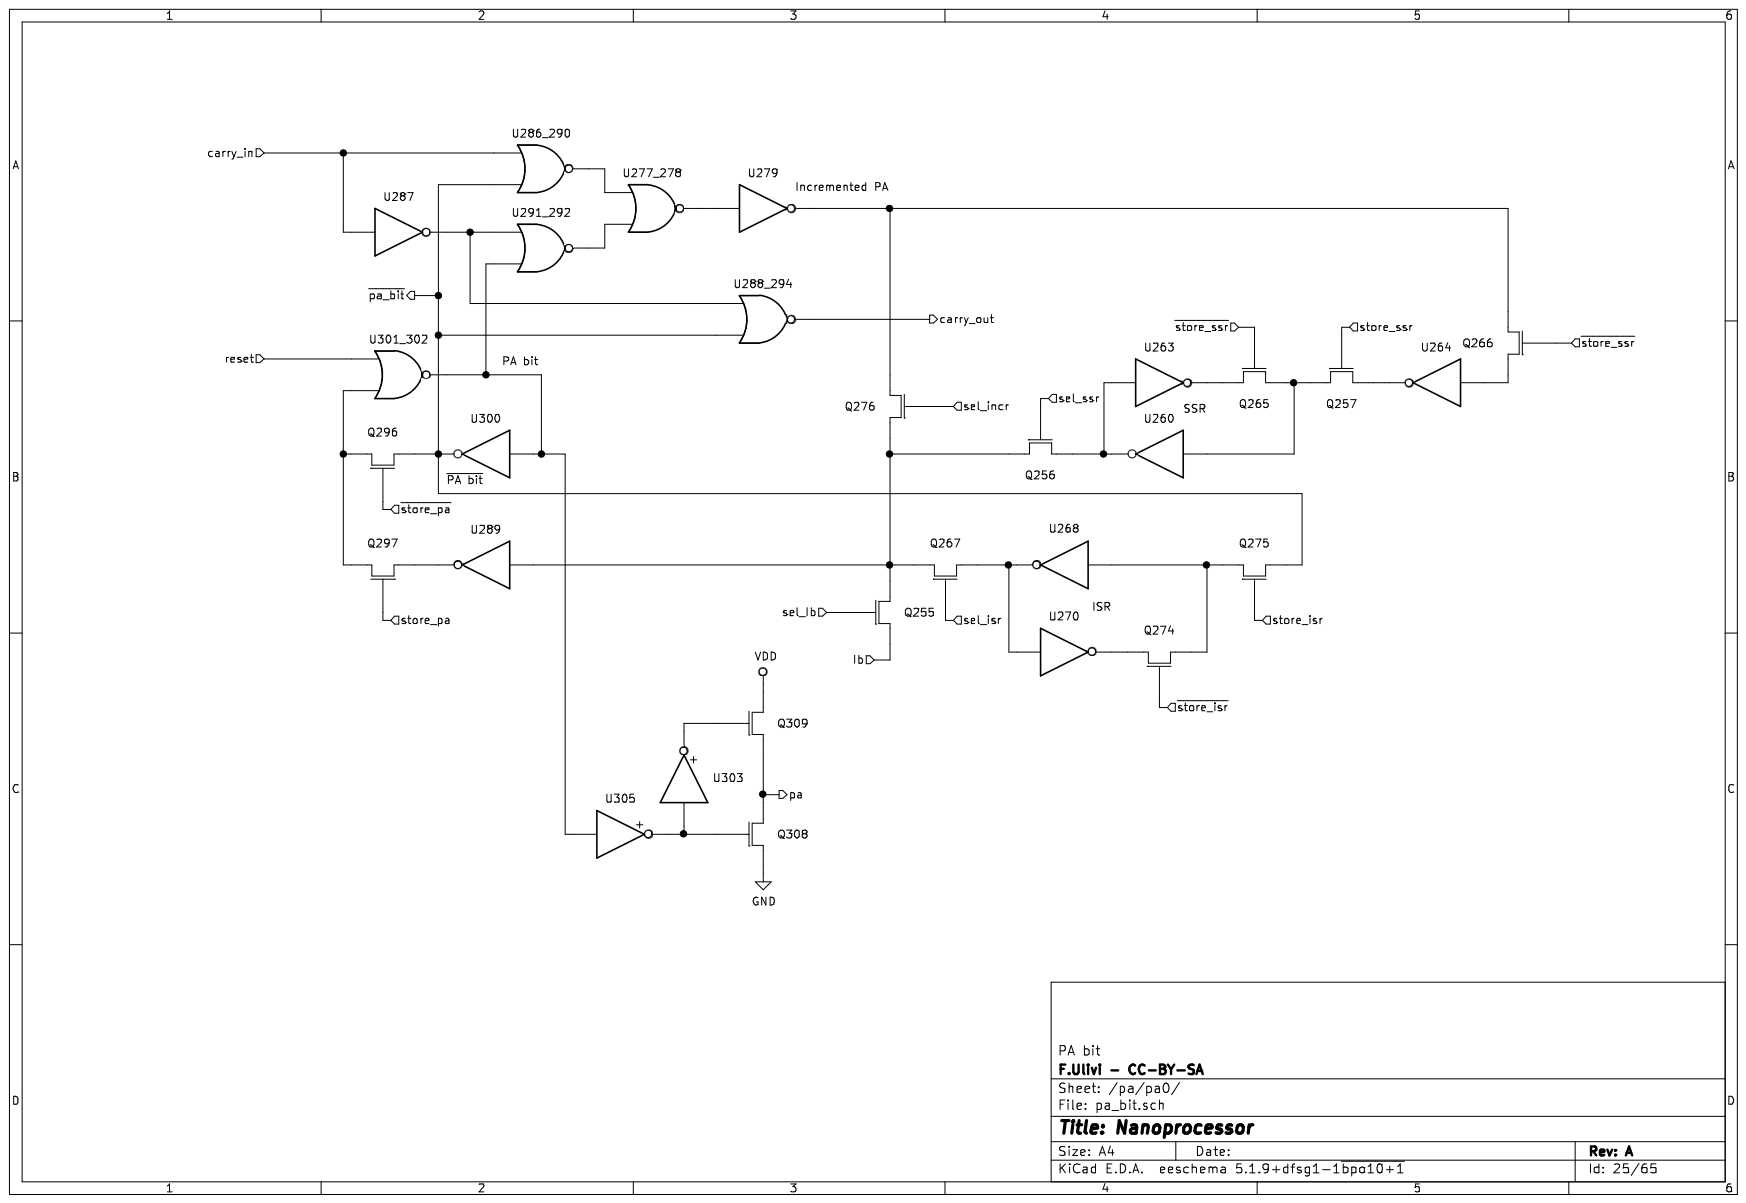
[picture p19: page 25]

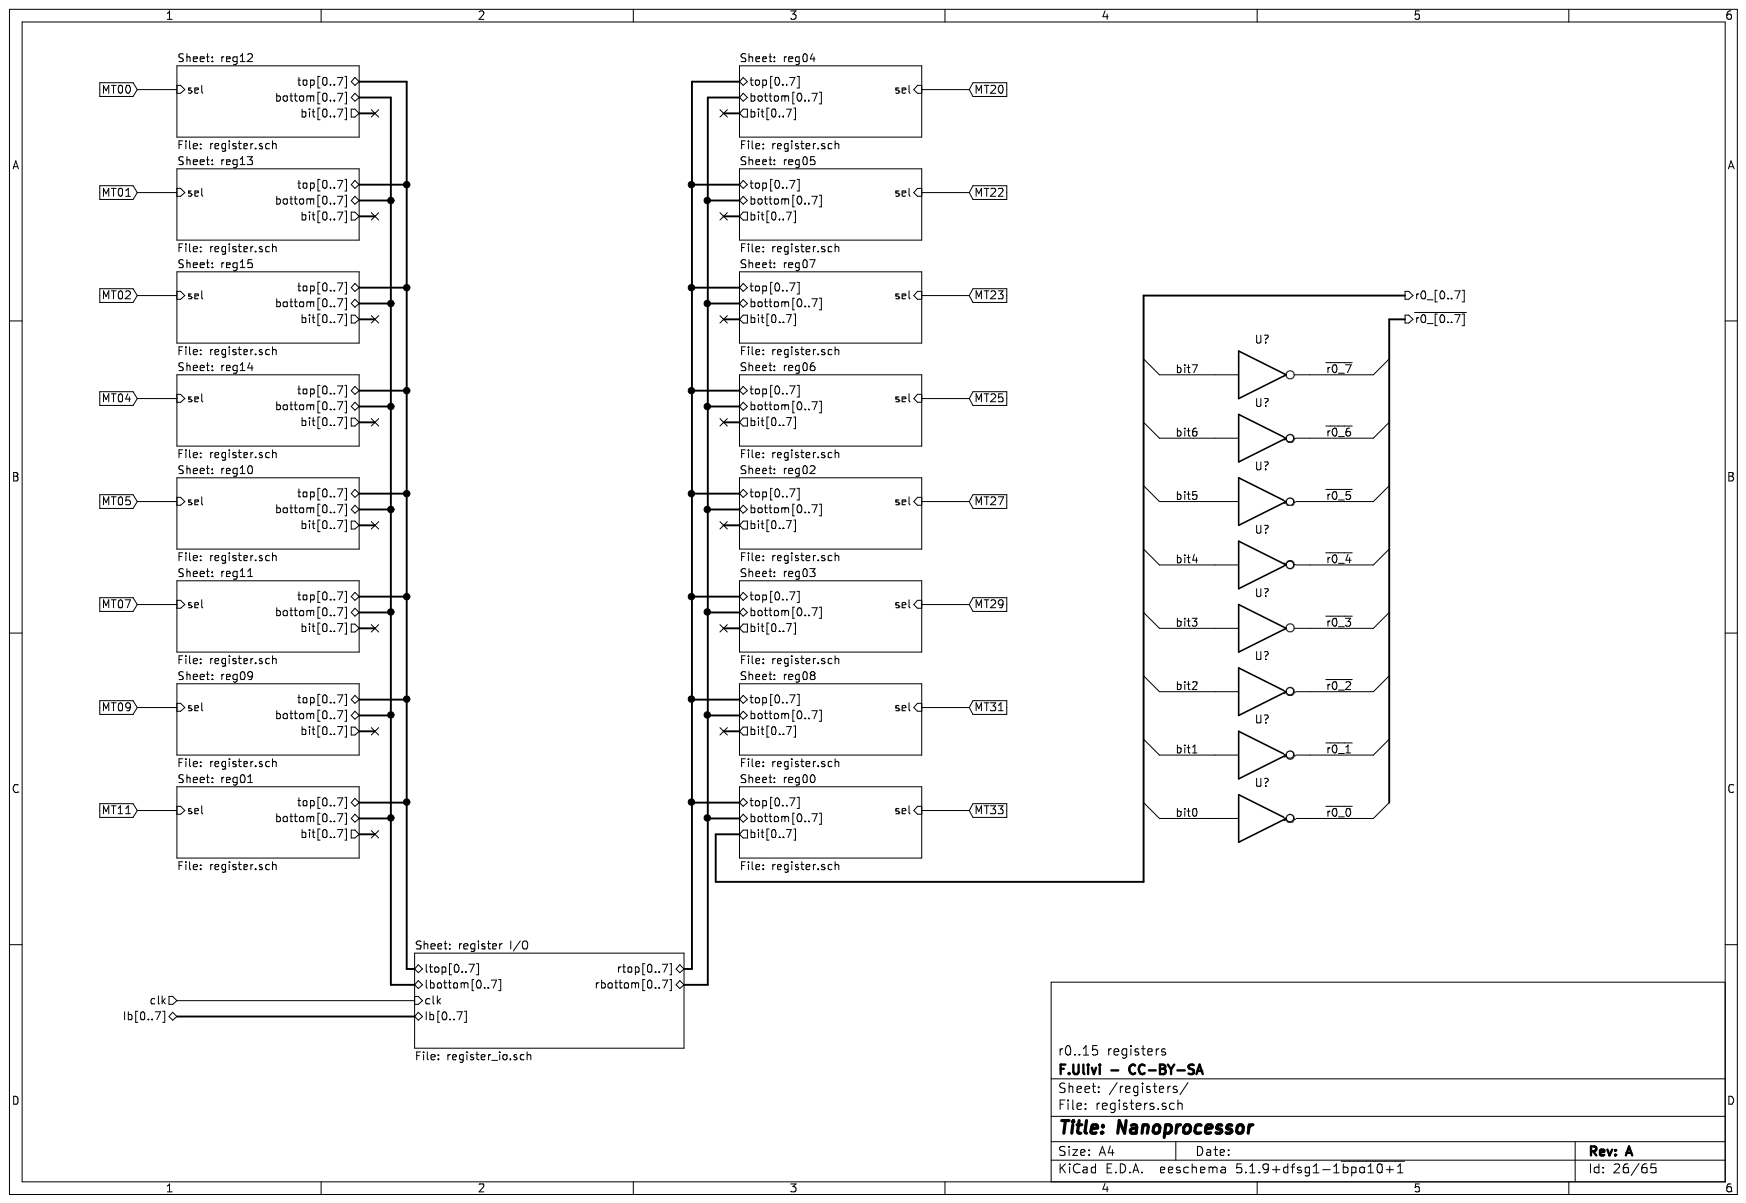
[picture p20: page 26]

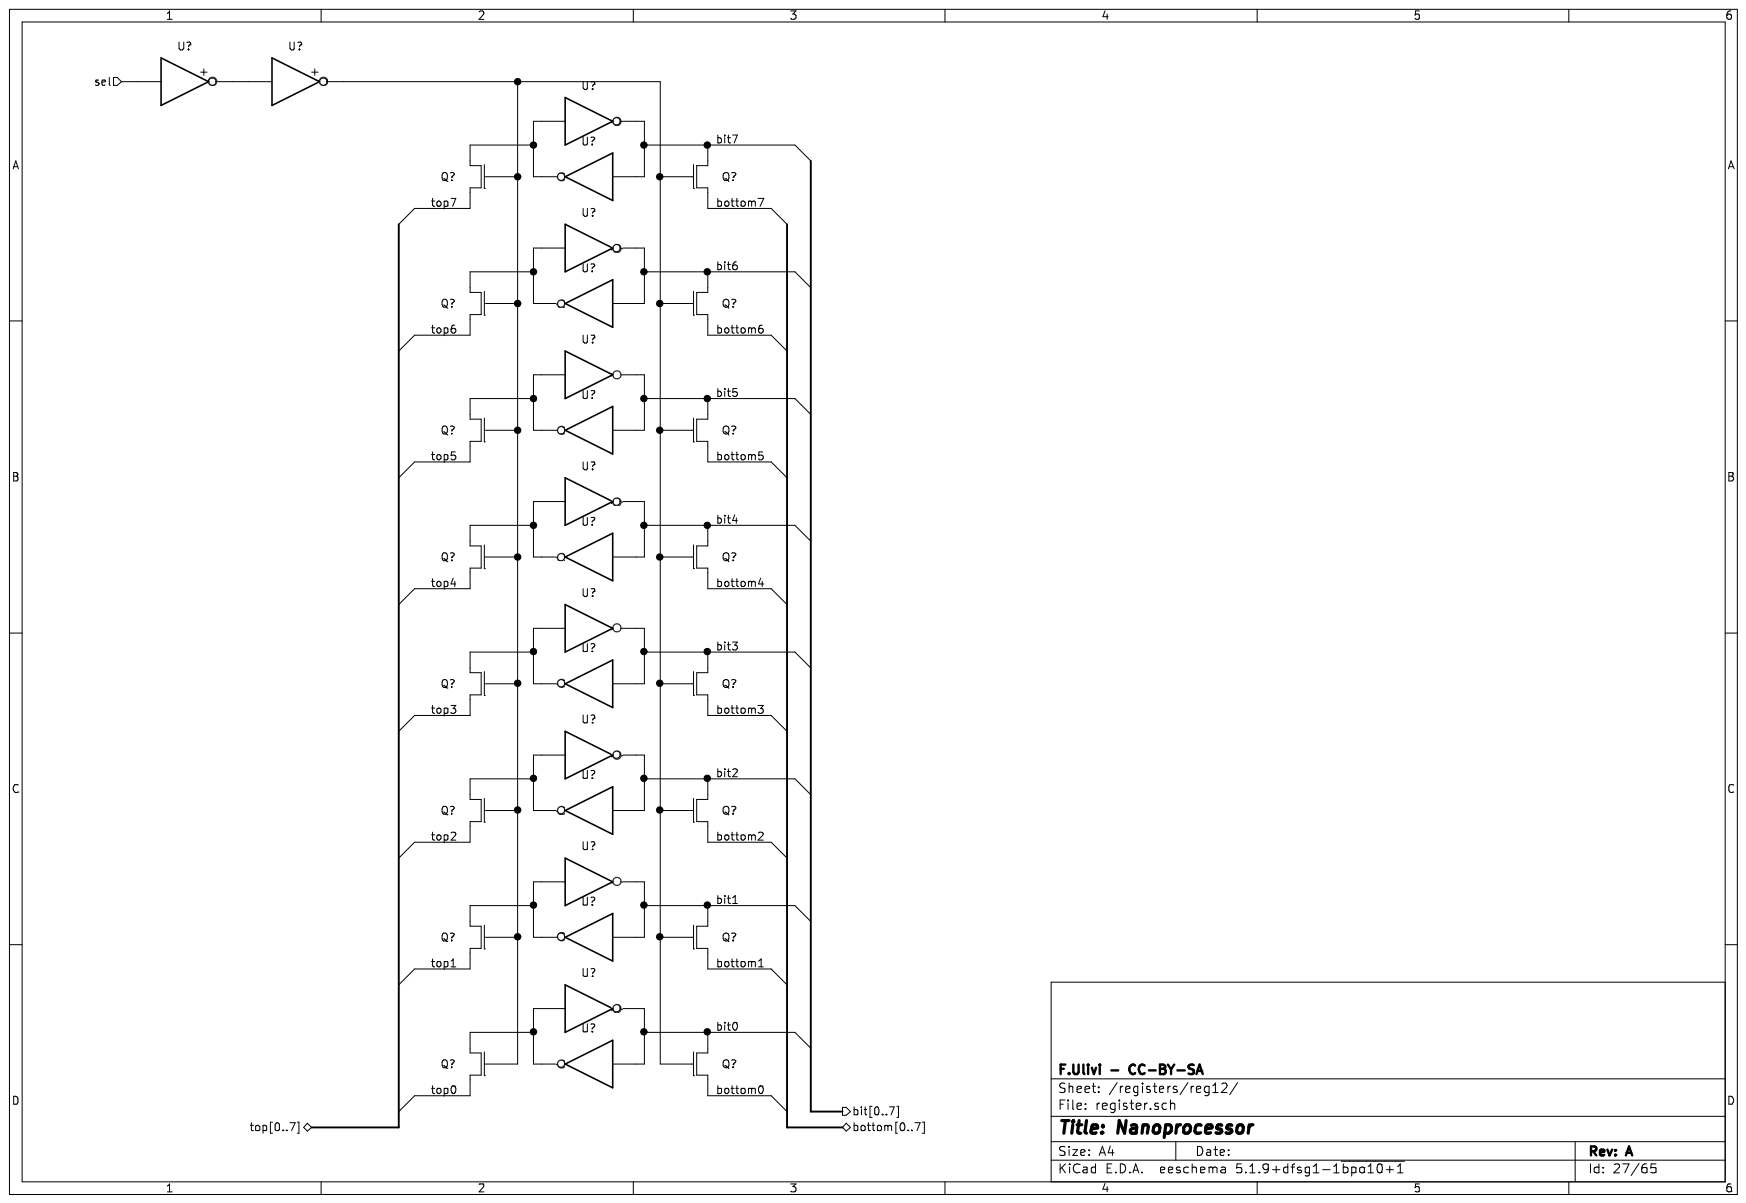
[picture p21: page 27]

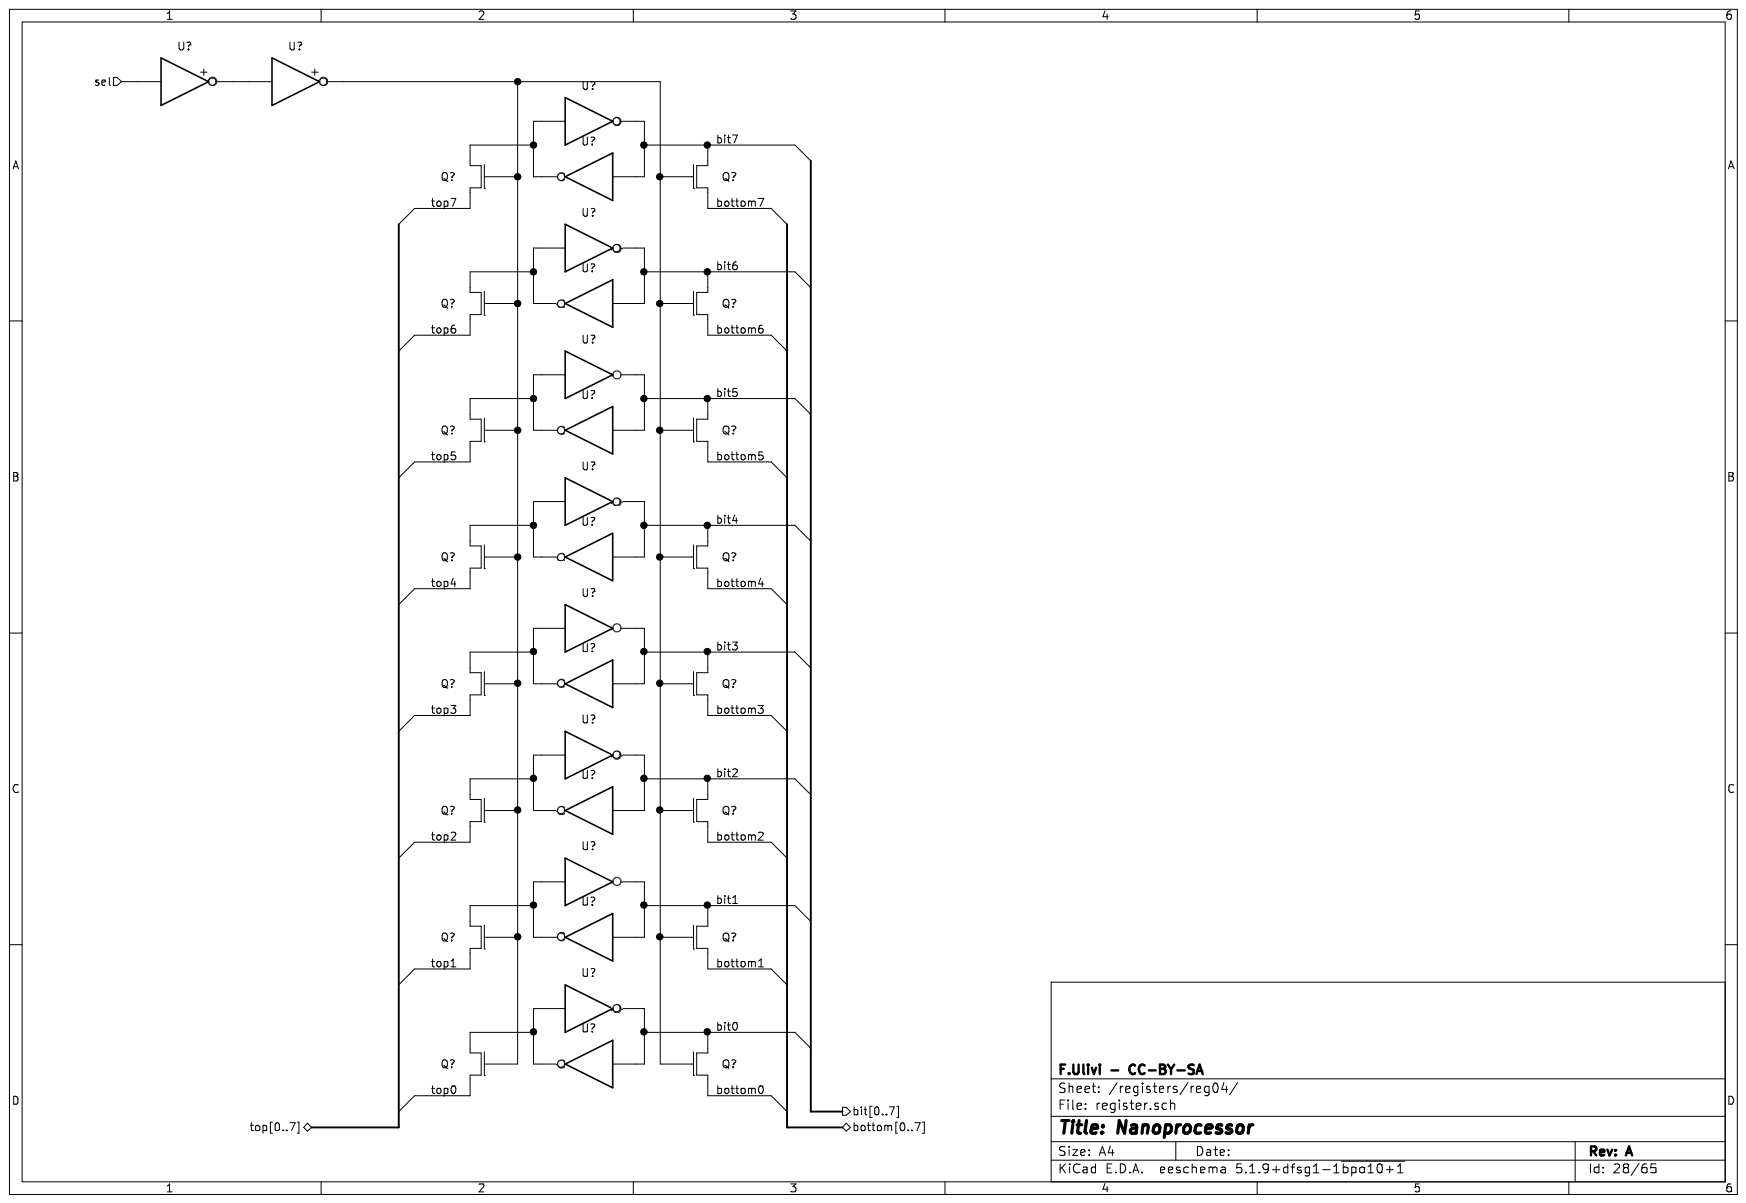
[picture p22: page 28]

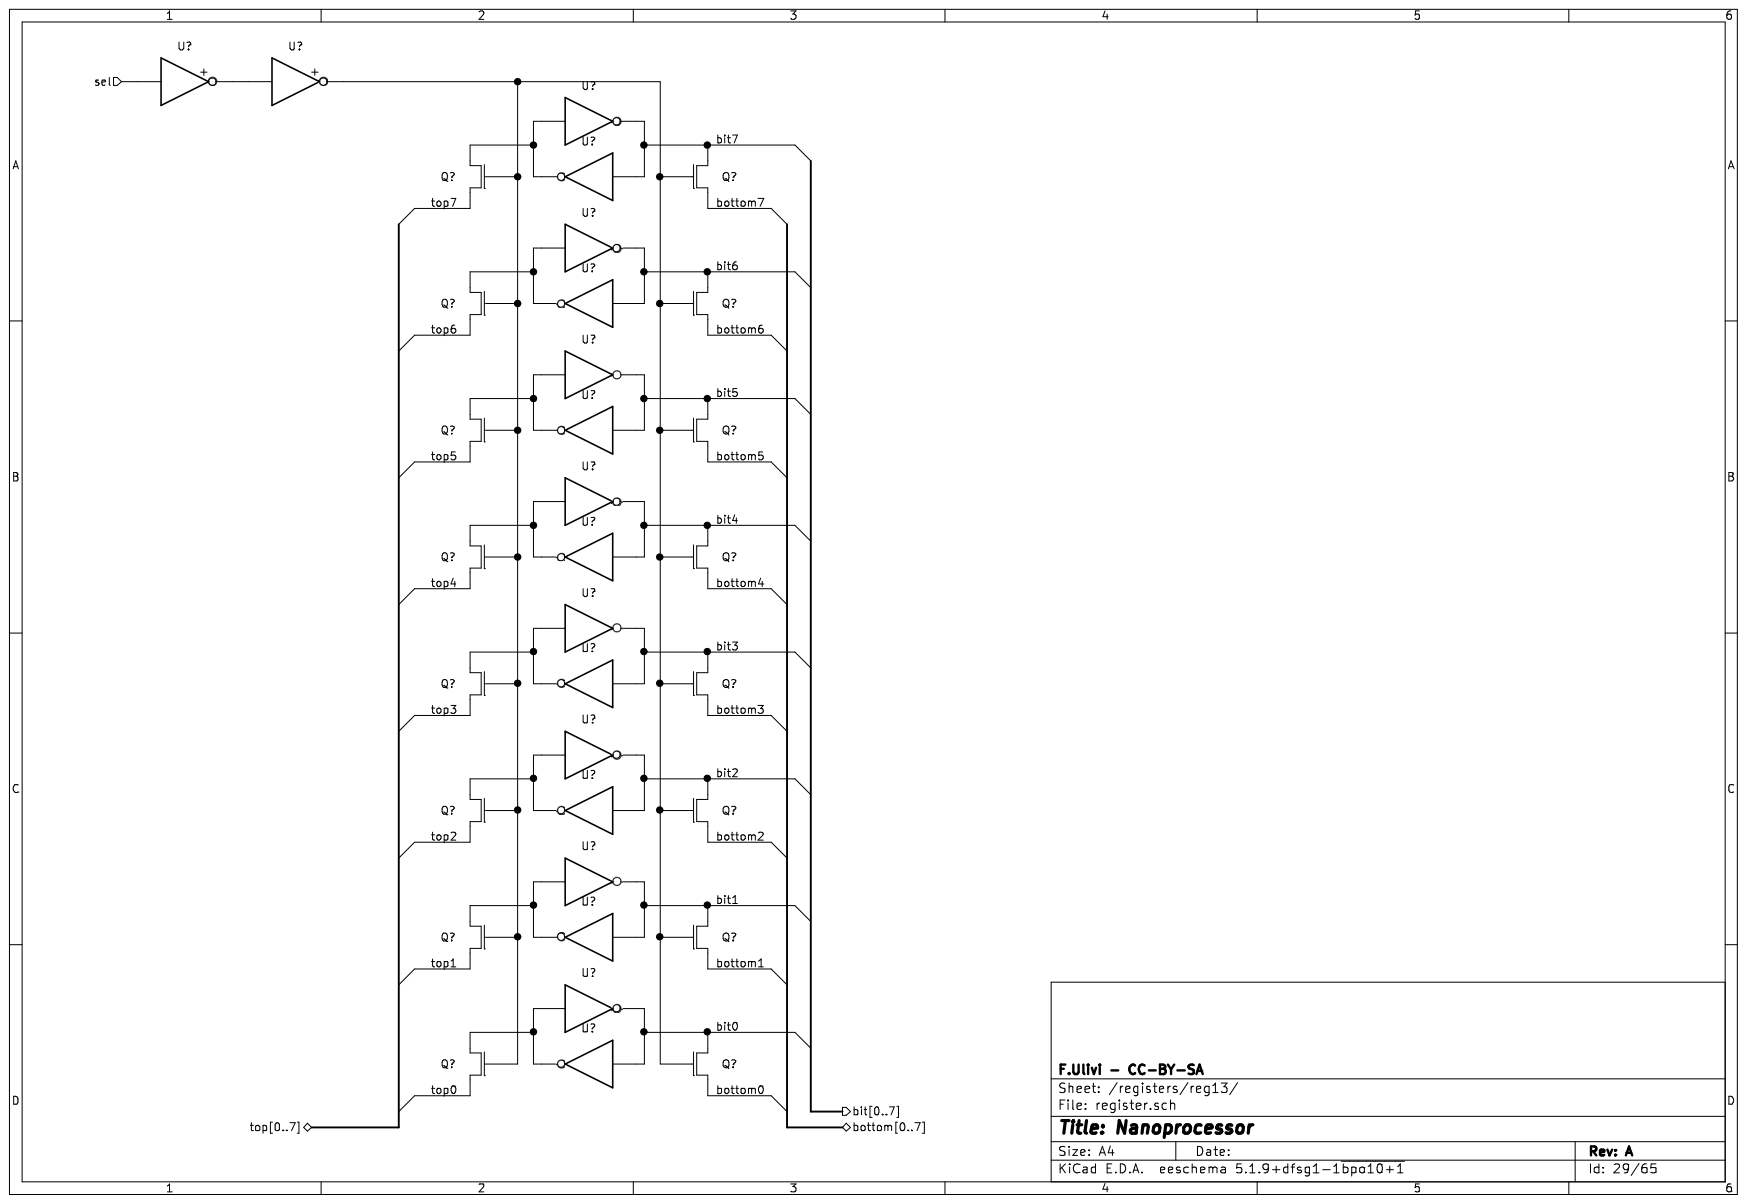
[picture p23: page 29]

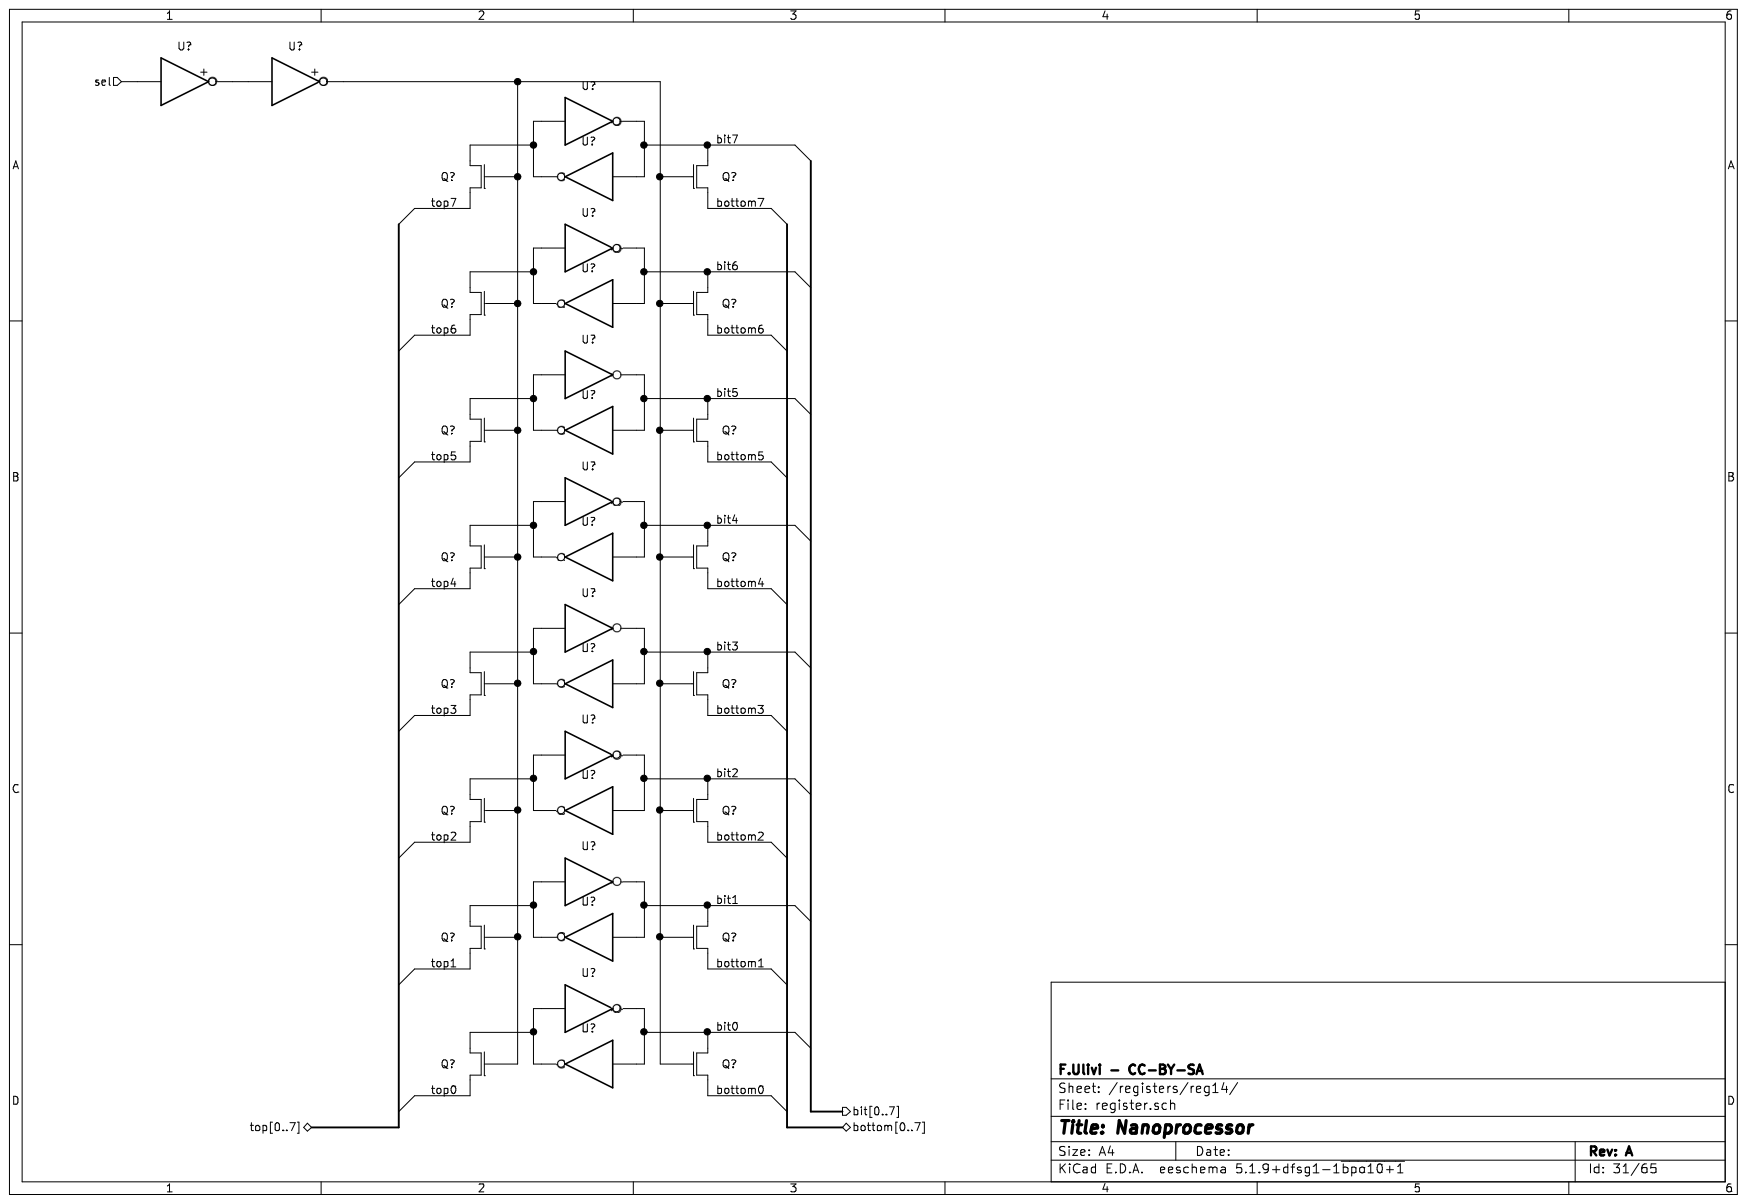
[picture p24: page 31]

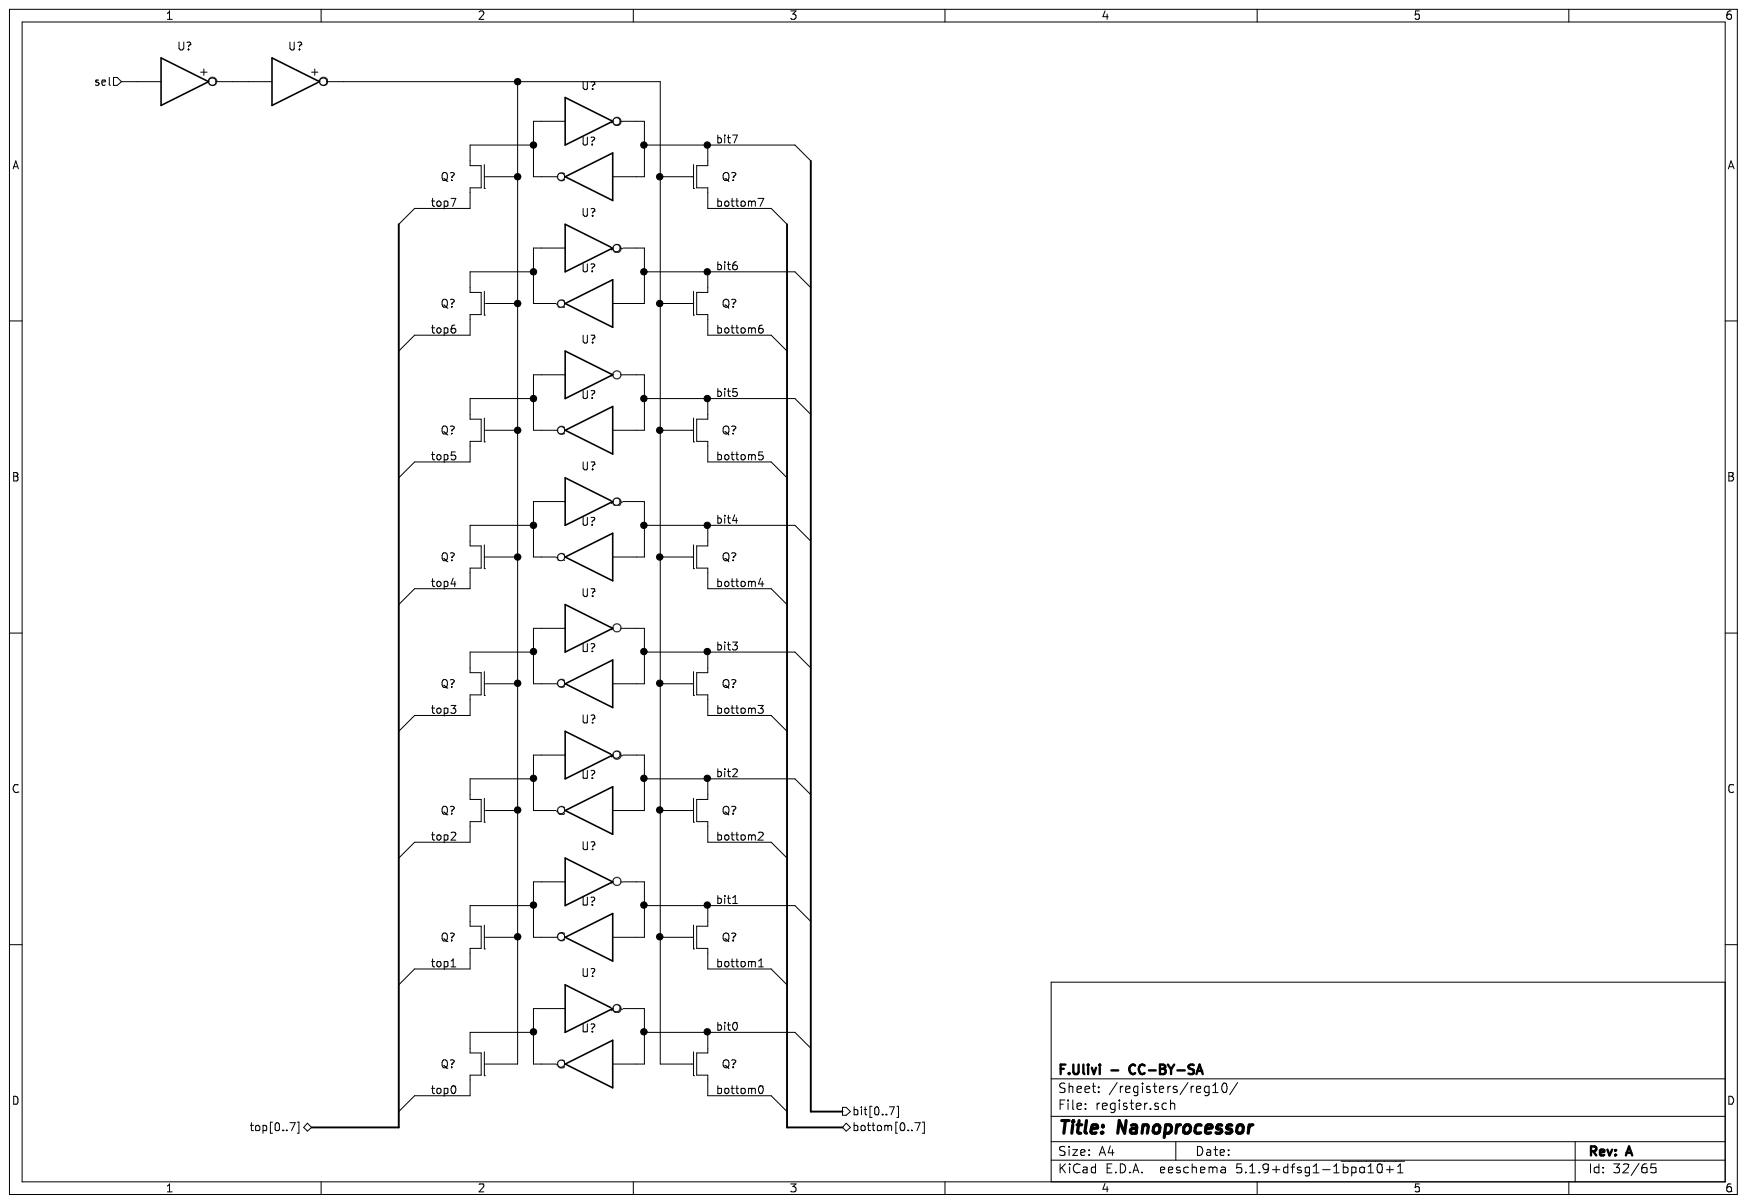
[picture p25: page 32]

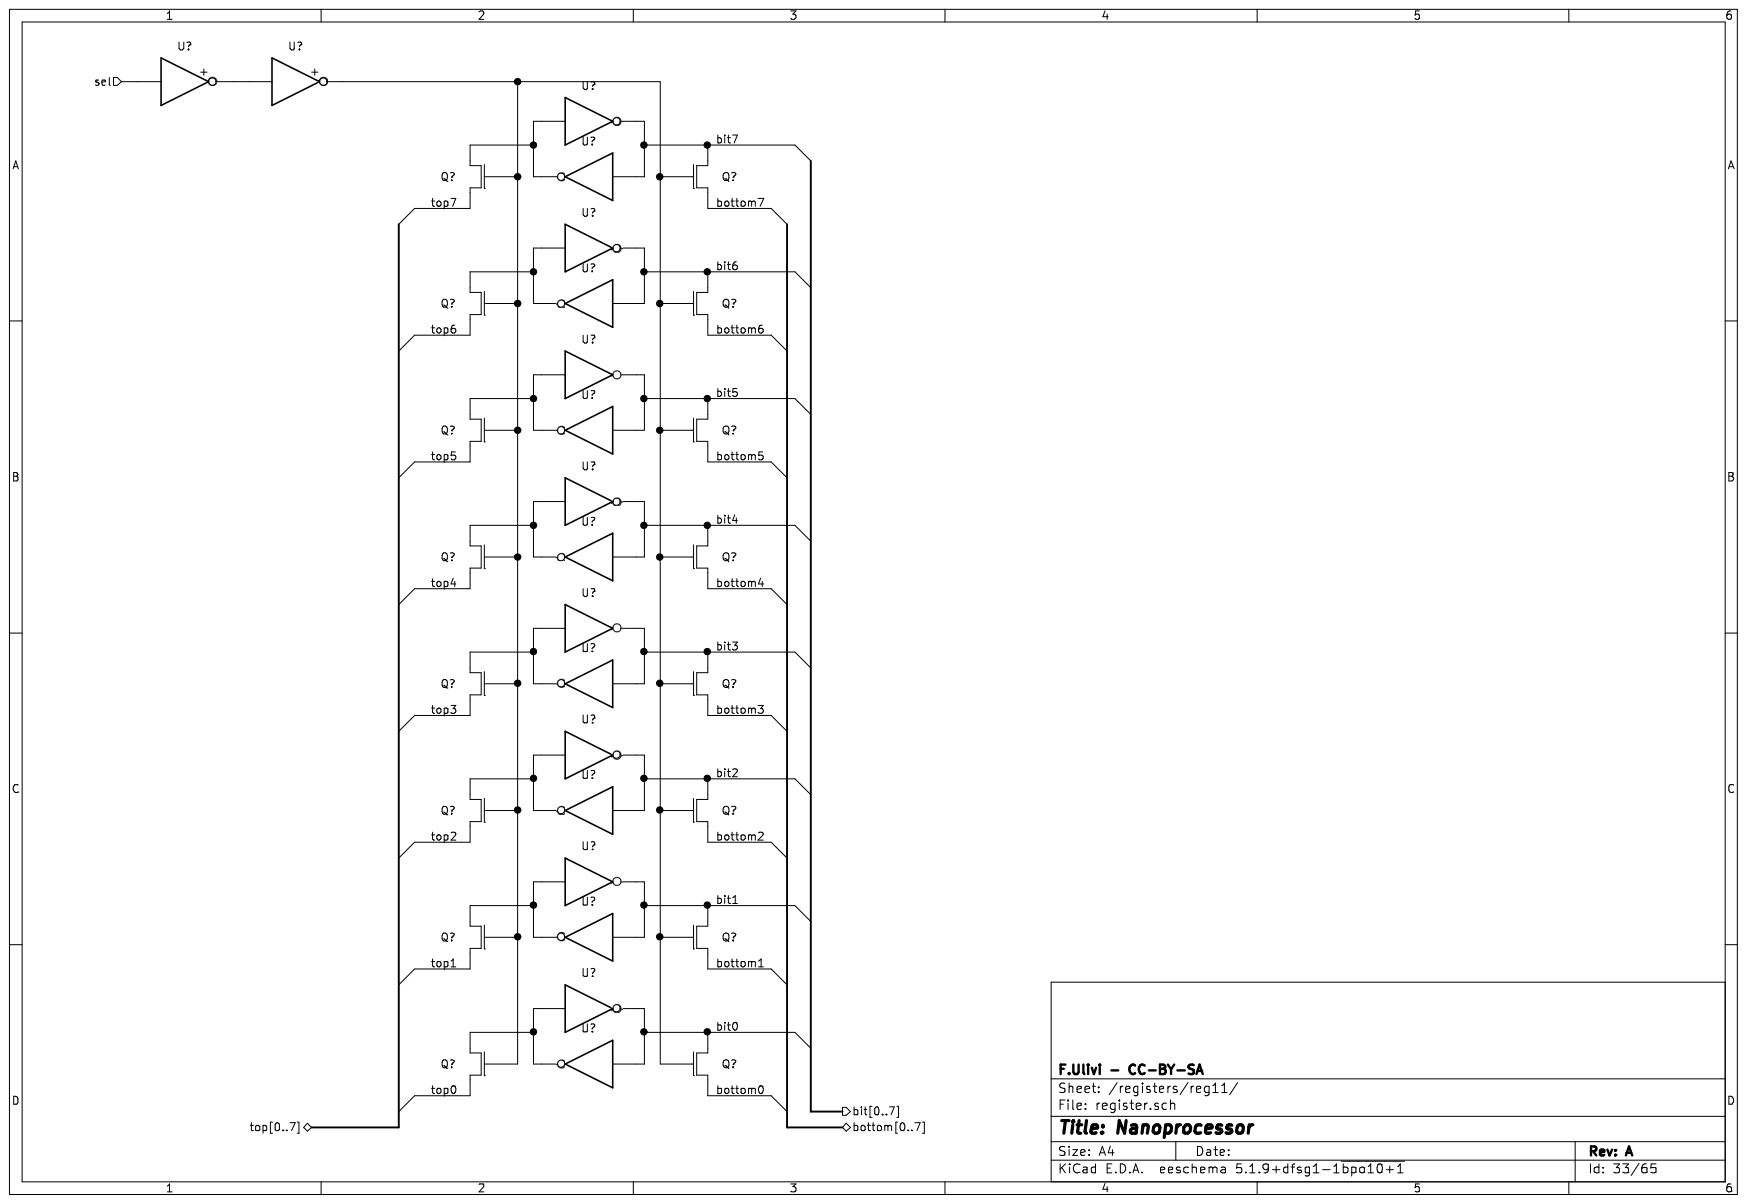
[picture p26: page 33]

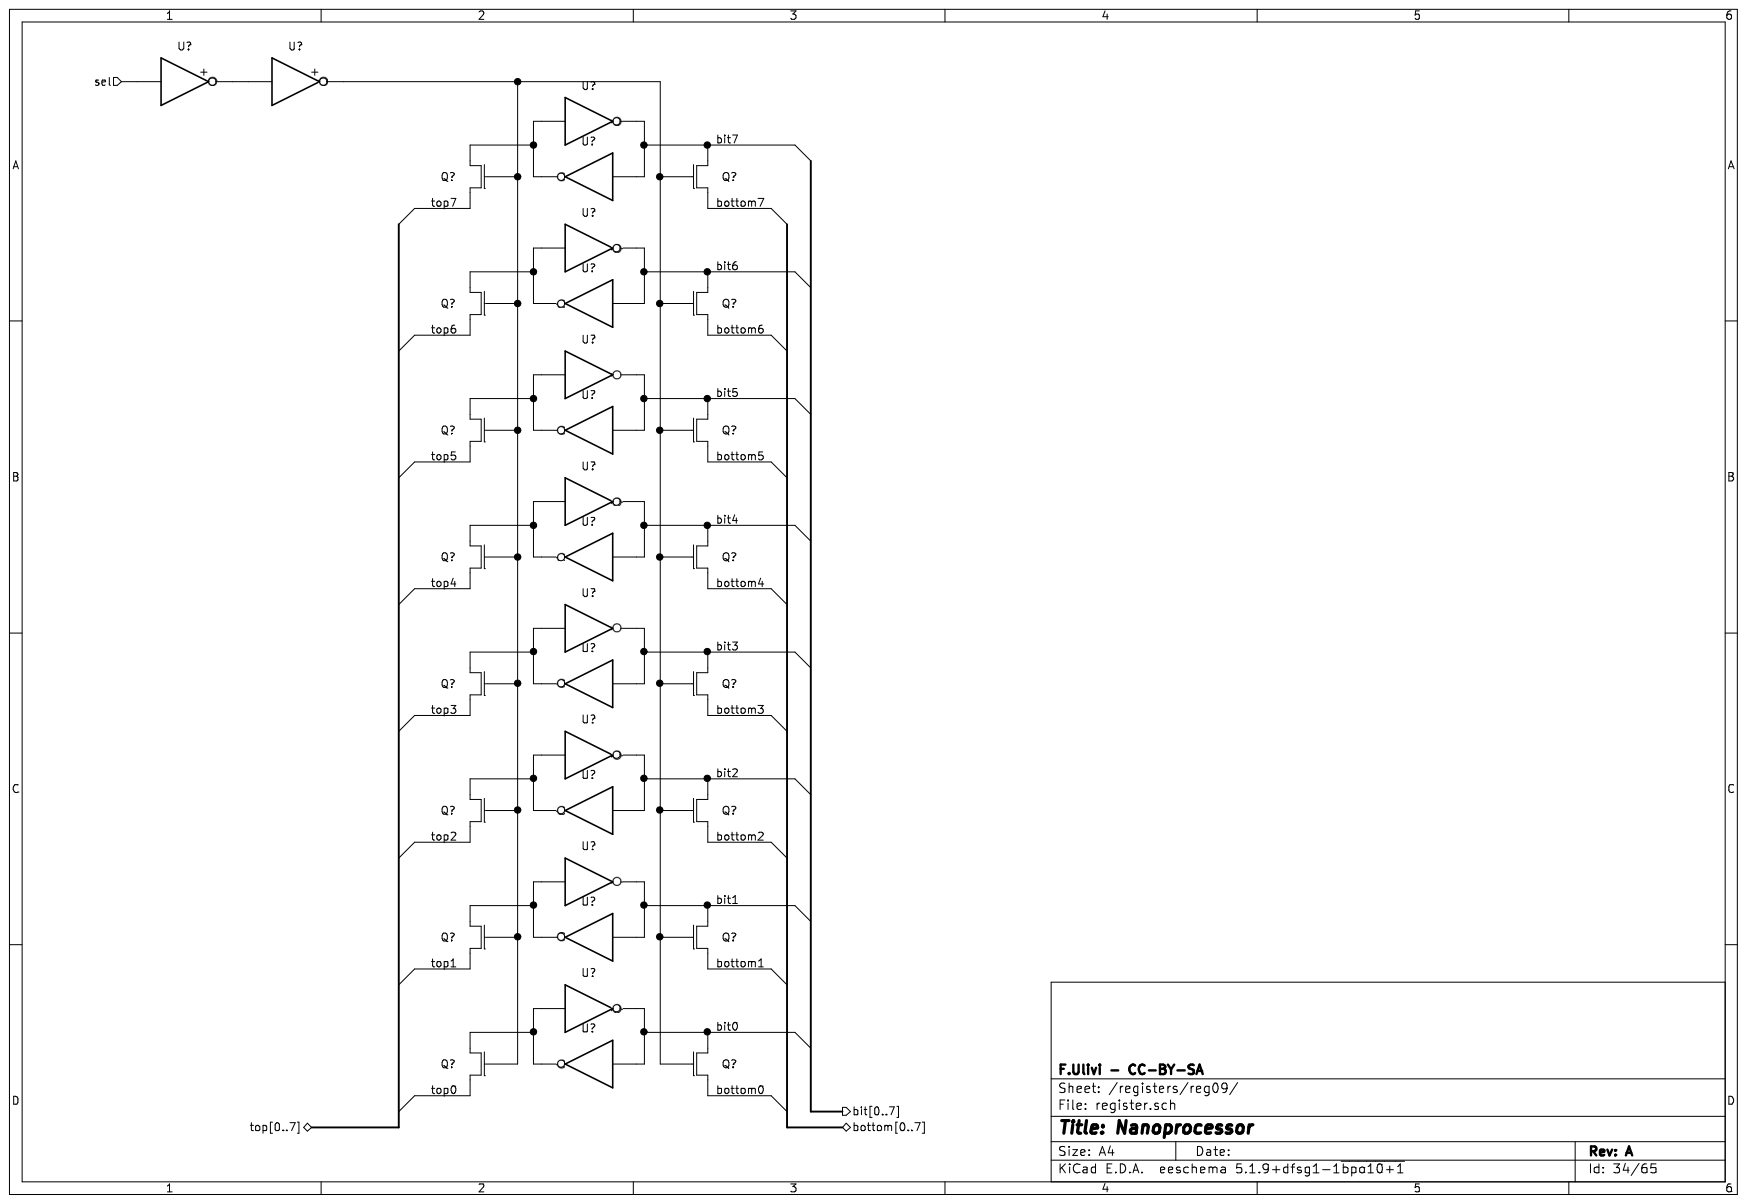
[picture p27: page 34]

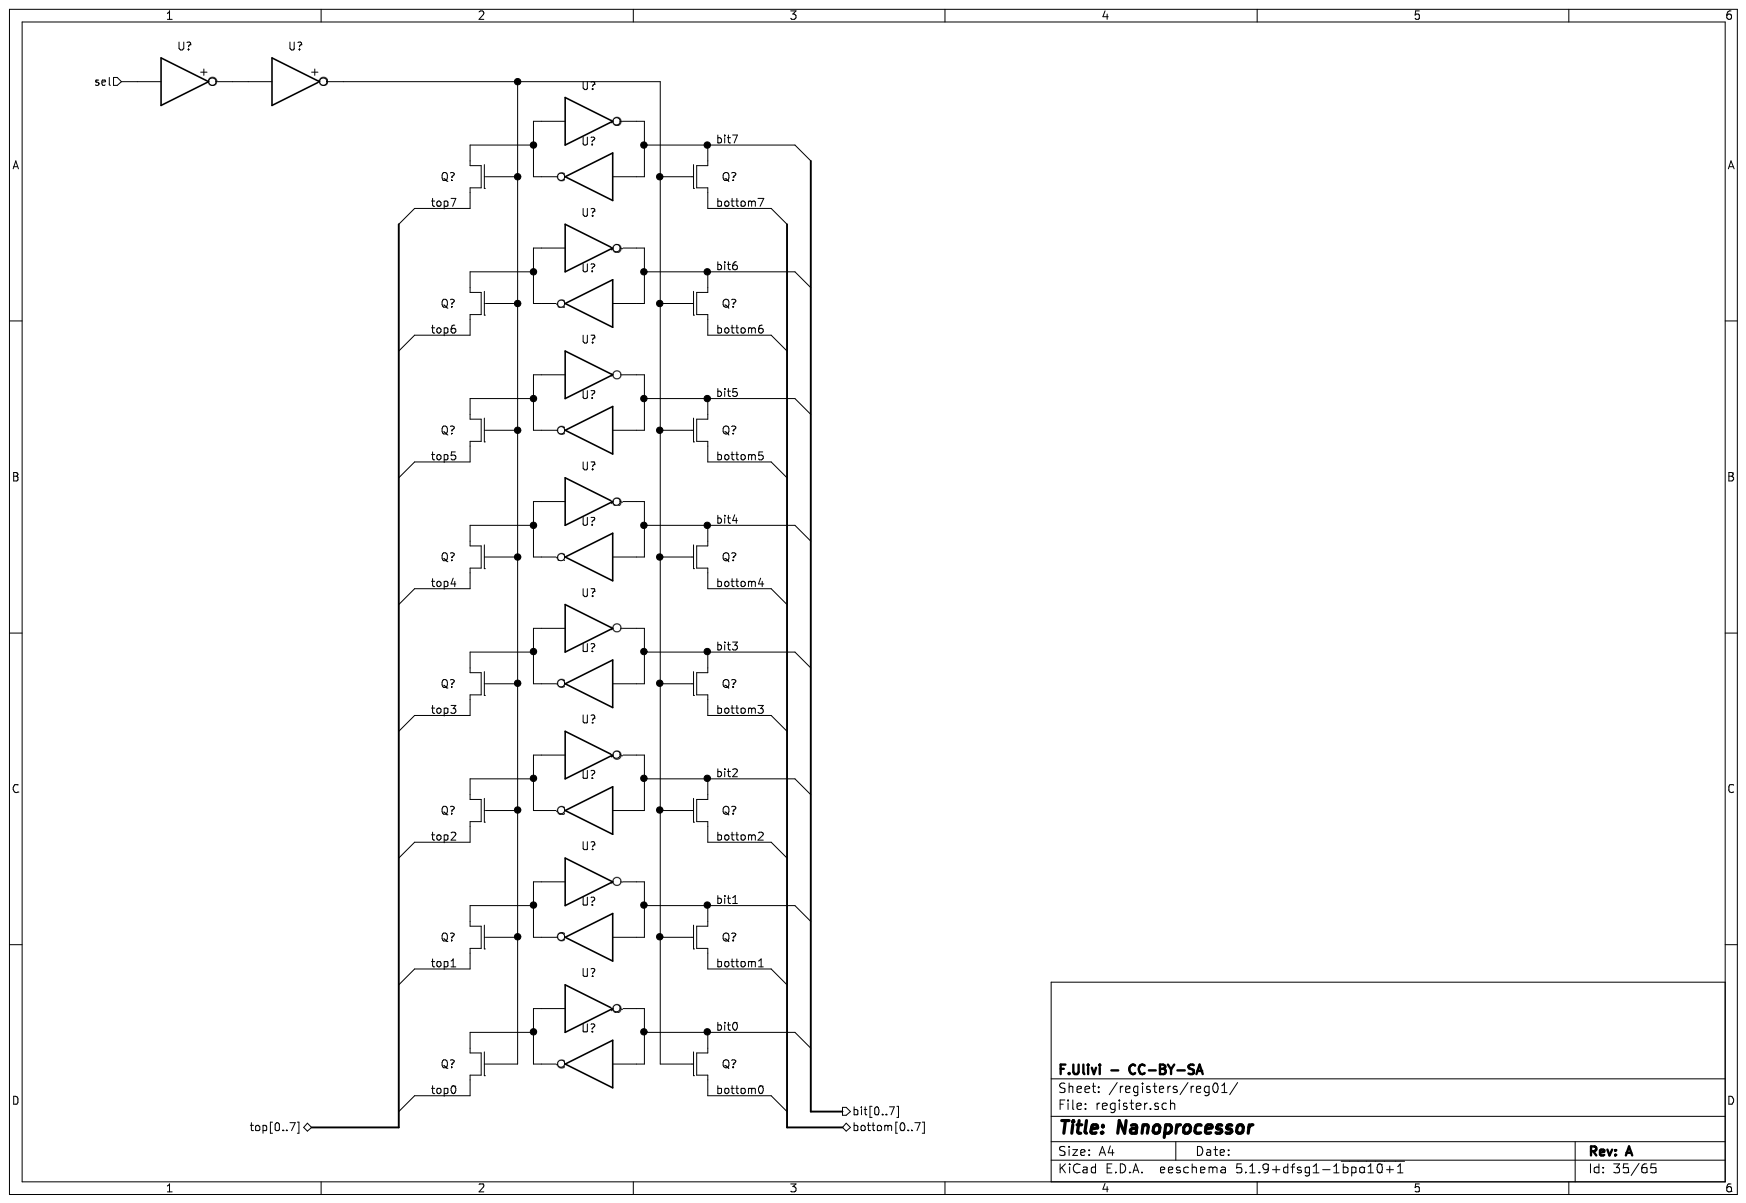
[picture p28: page 35]

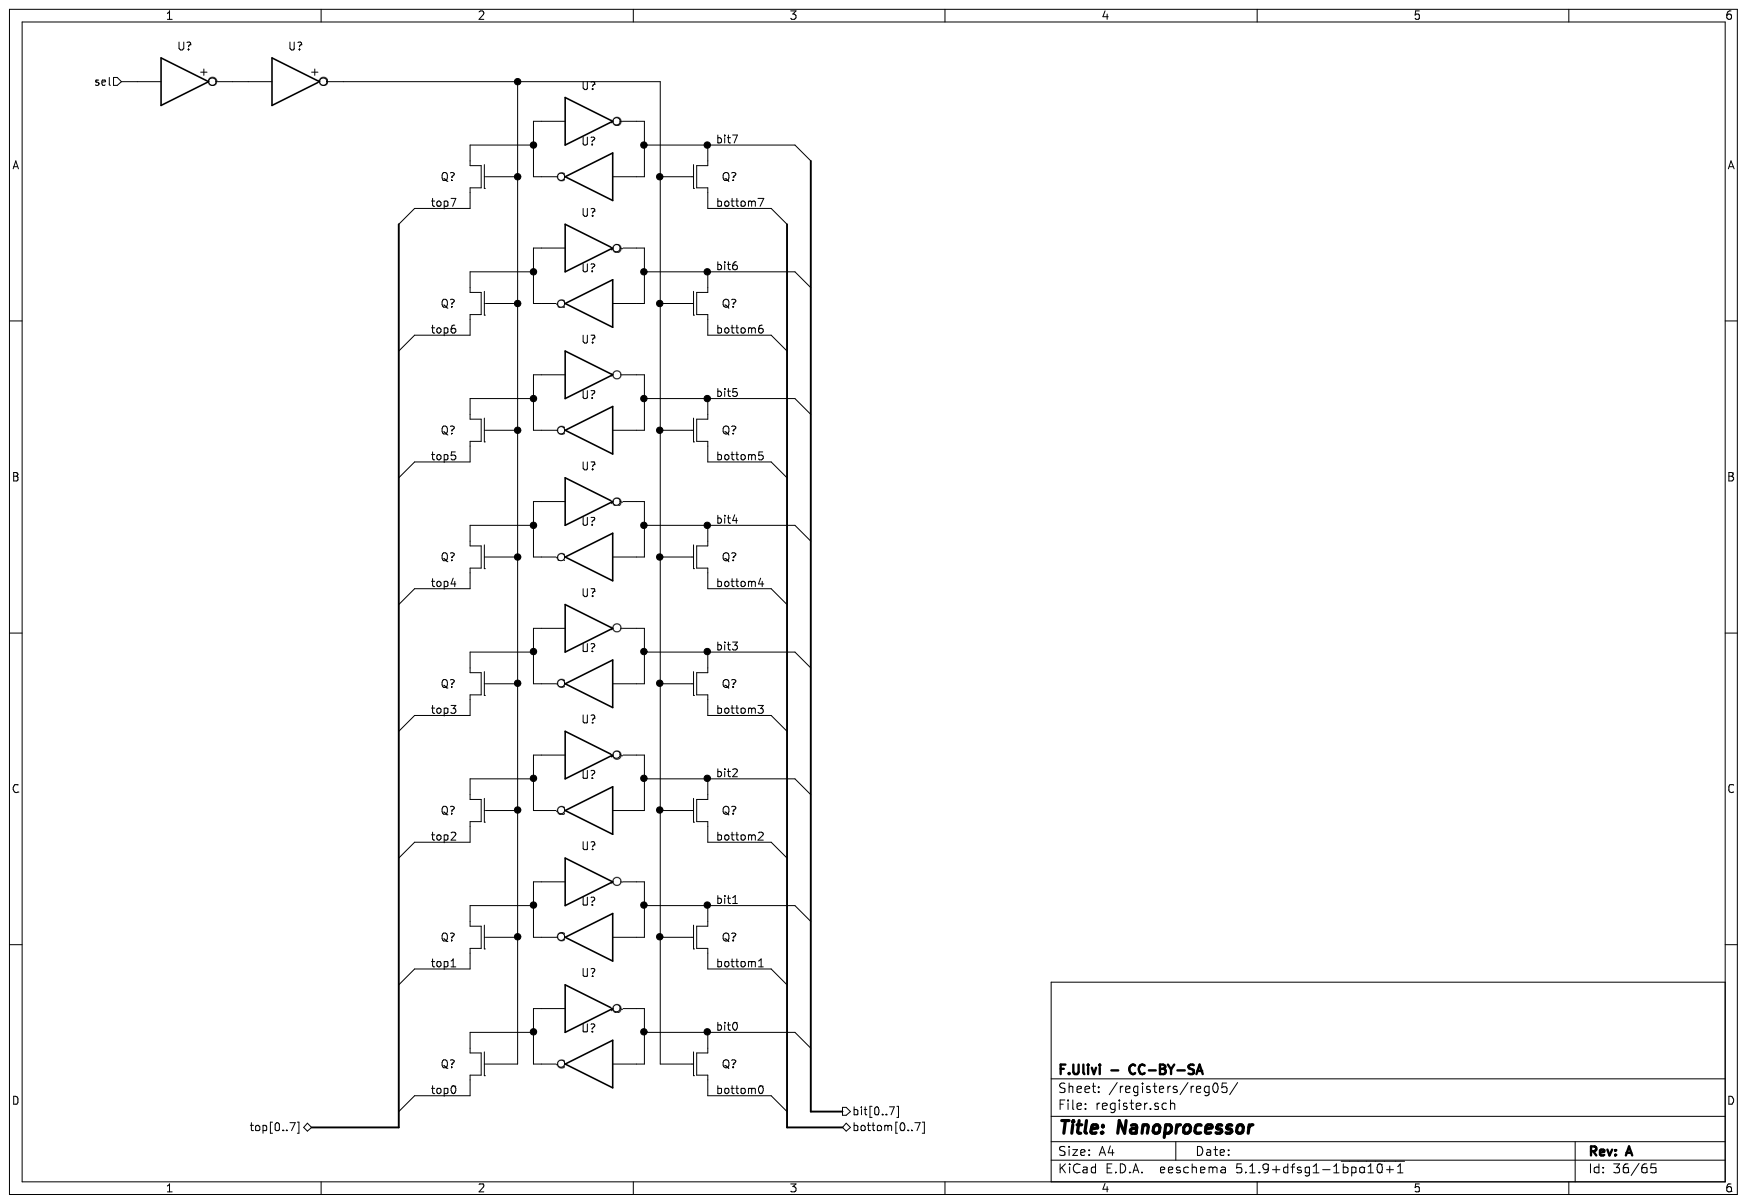
[picture p29: page 36]

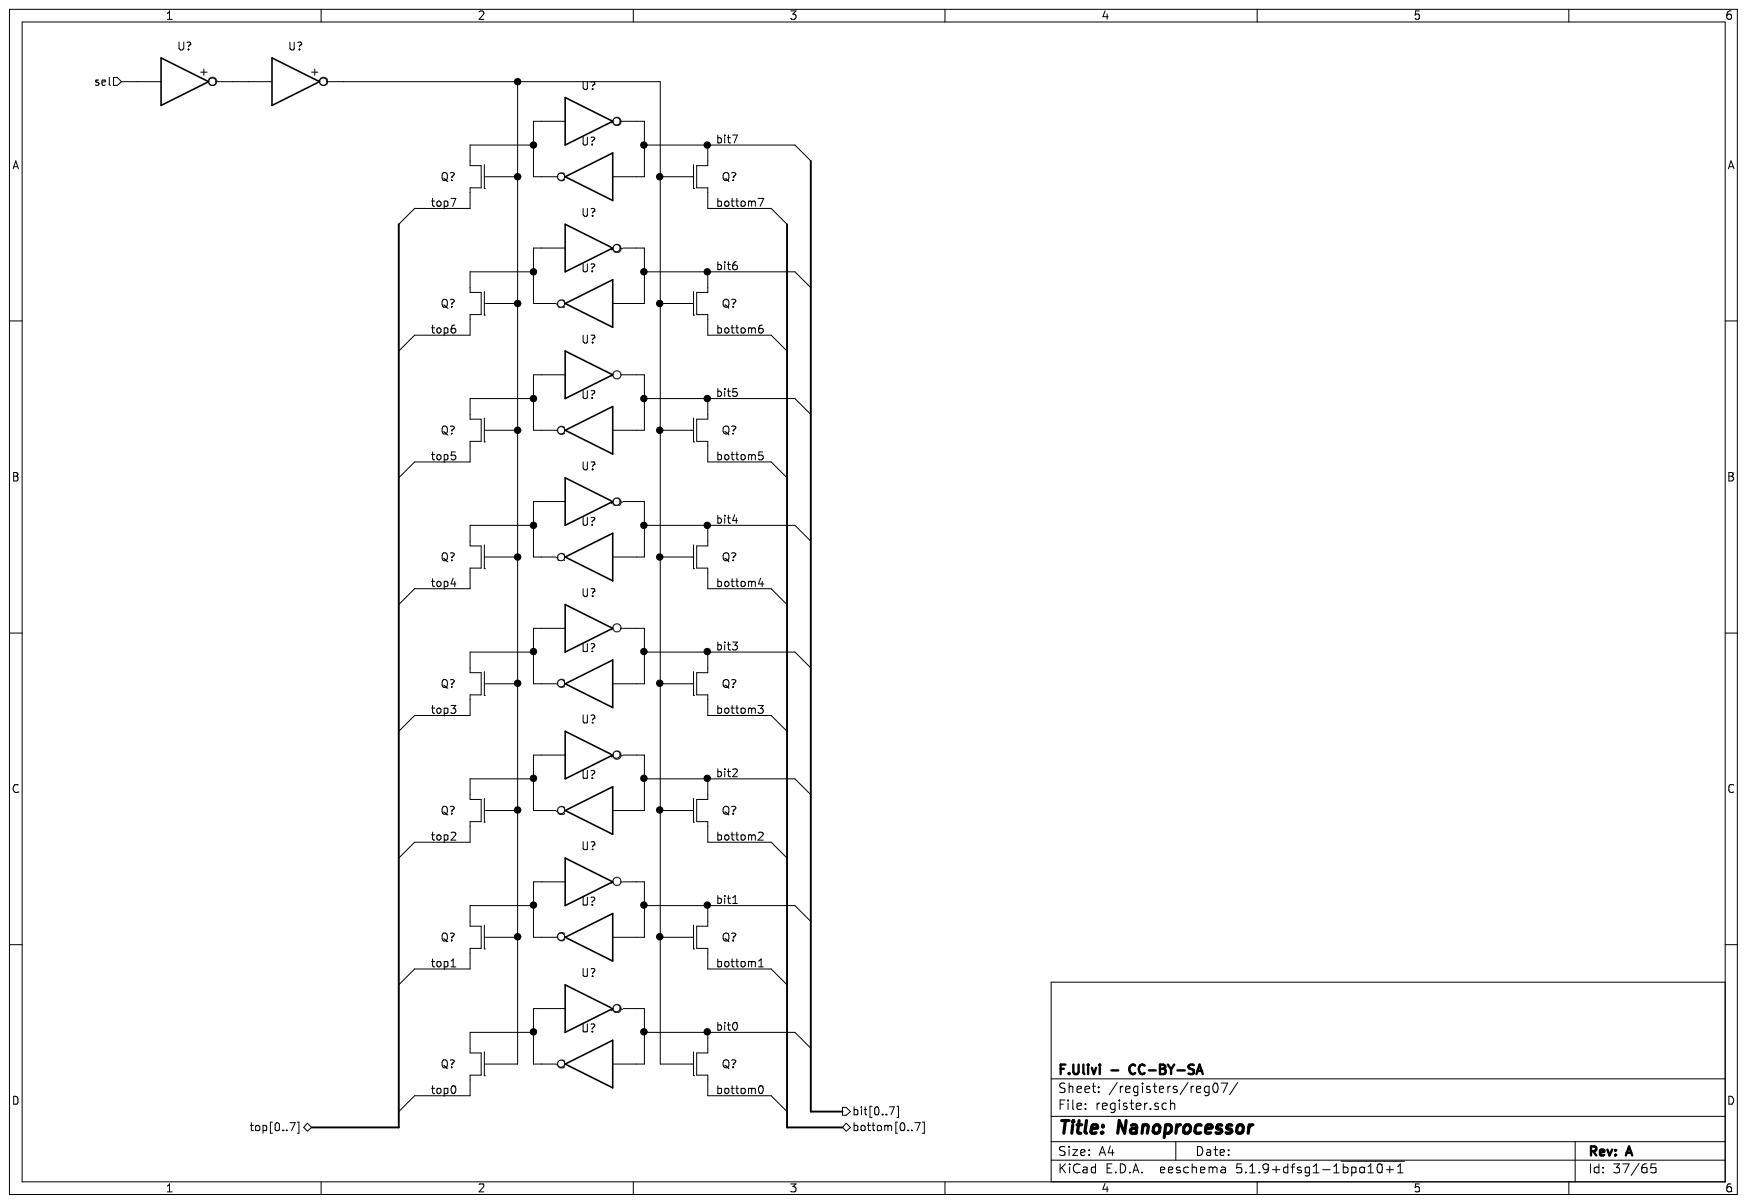
[picture p30: page 37]

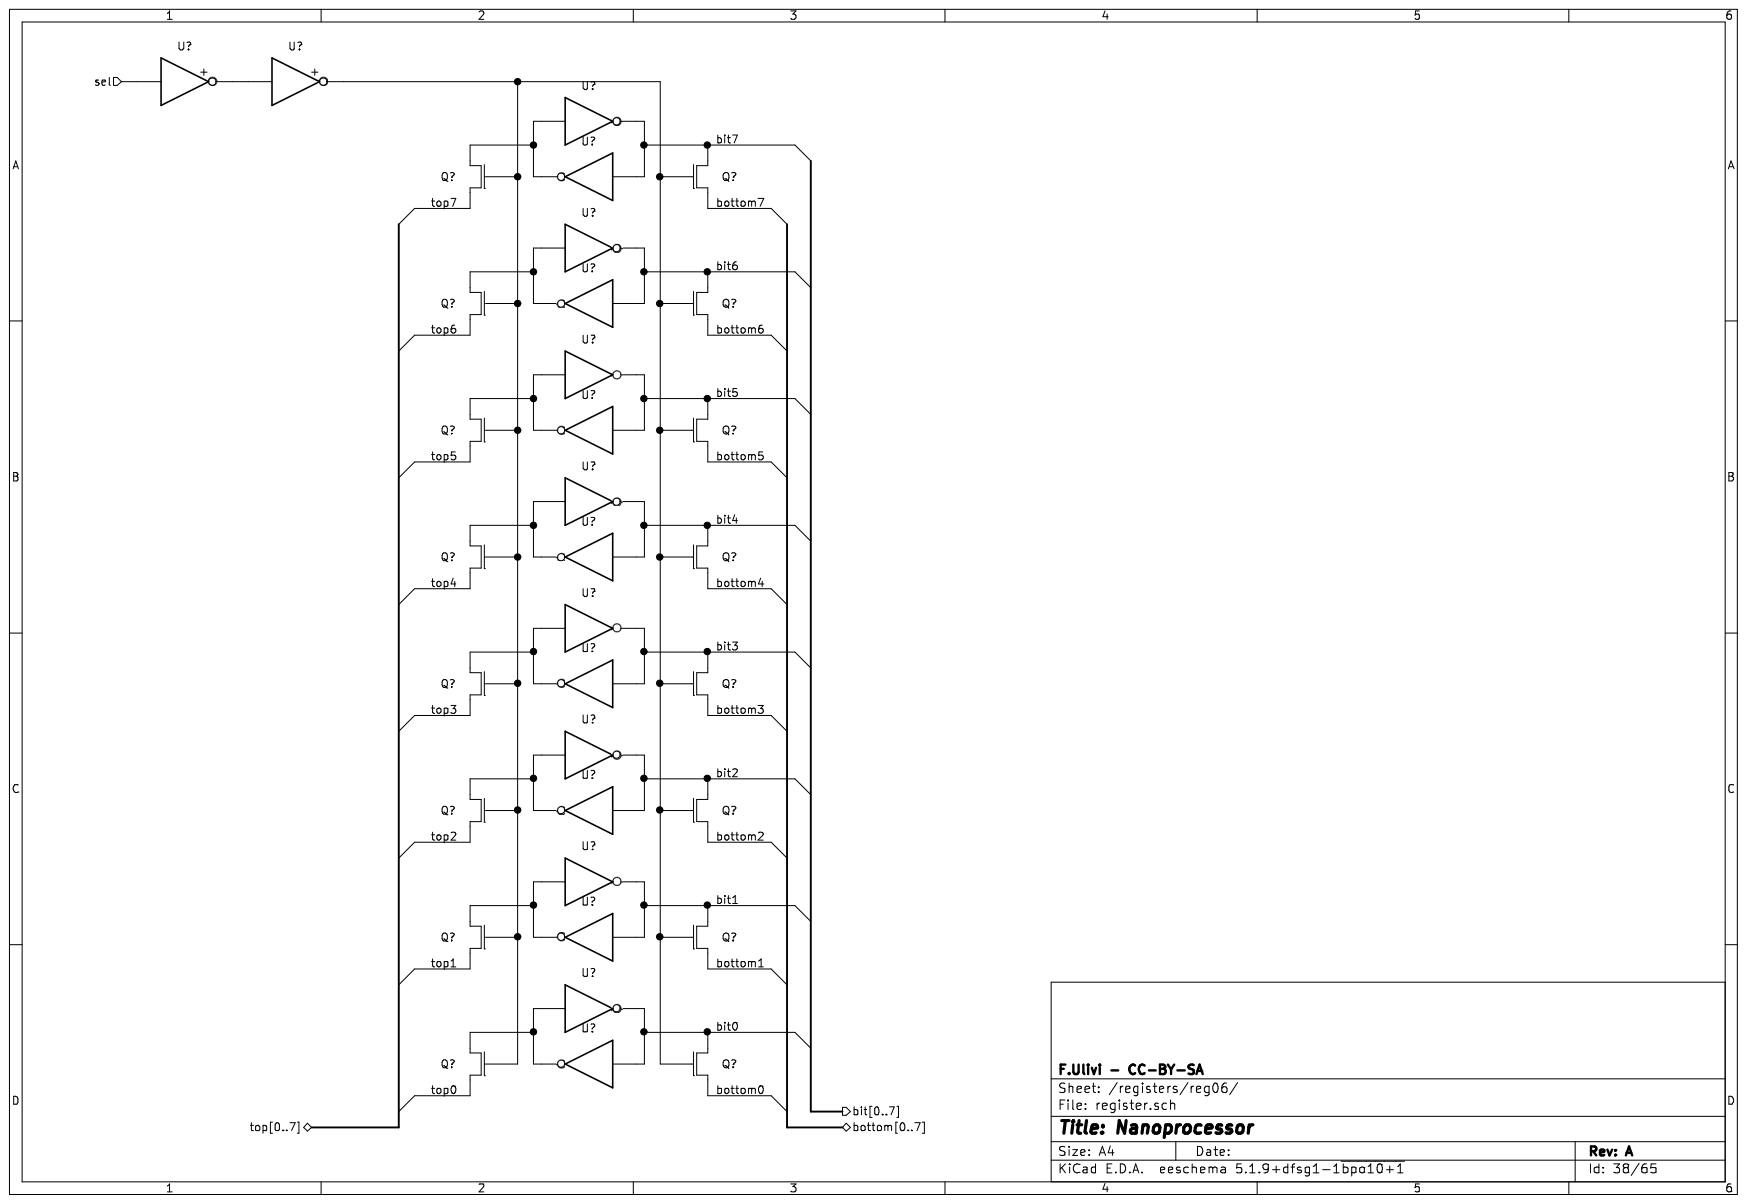
[picture p31: page 38]

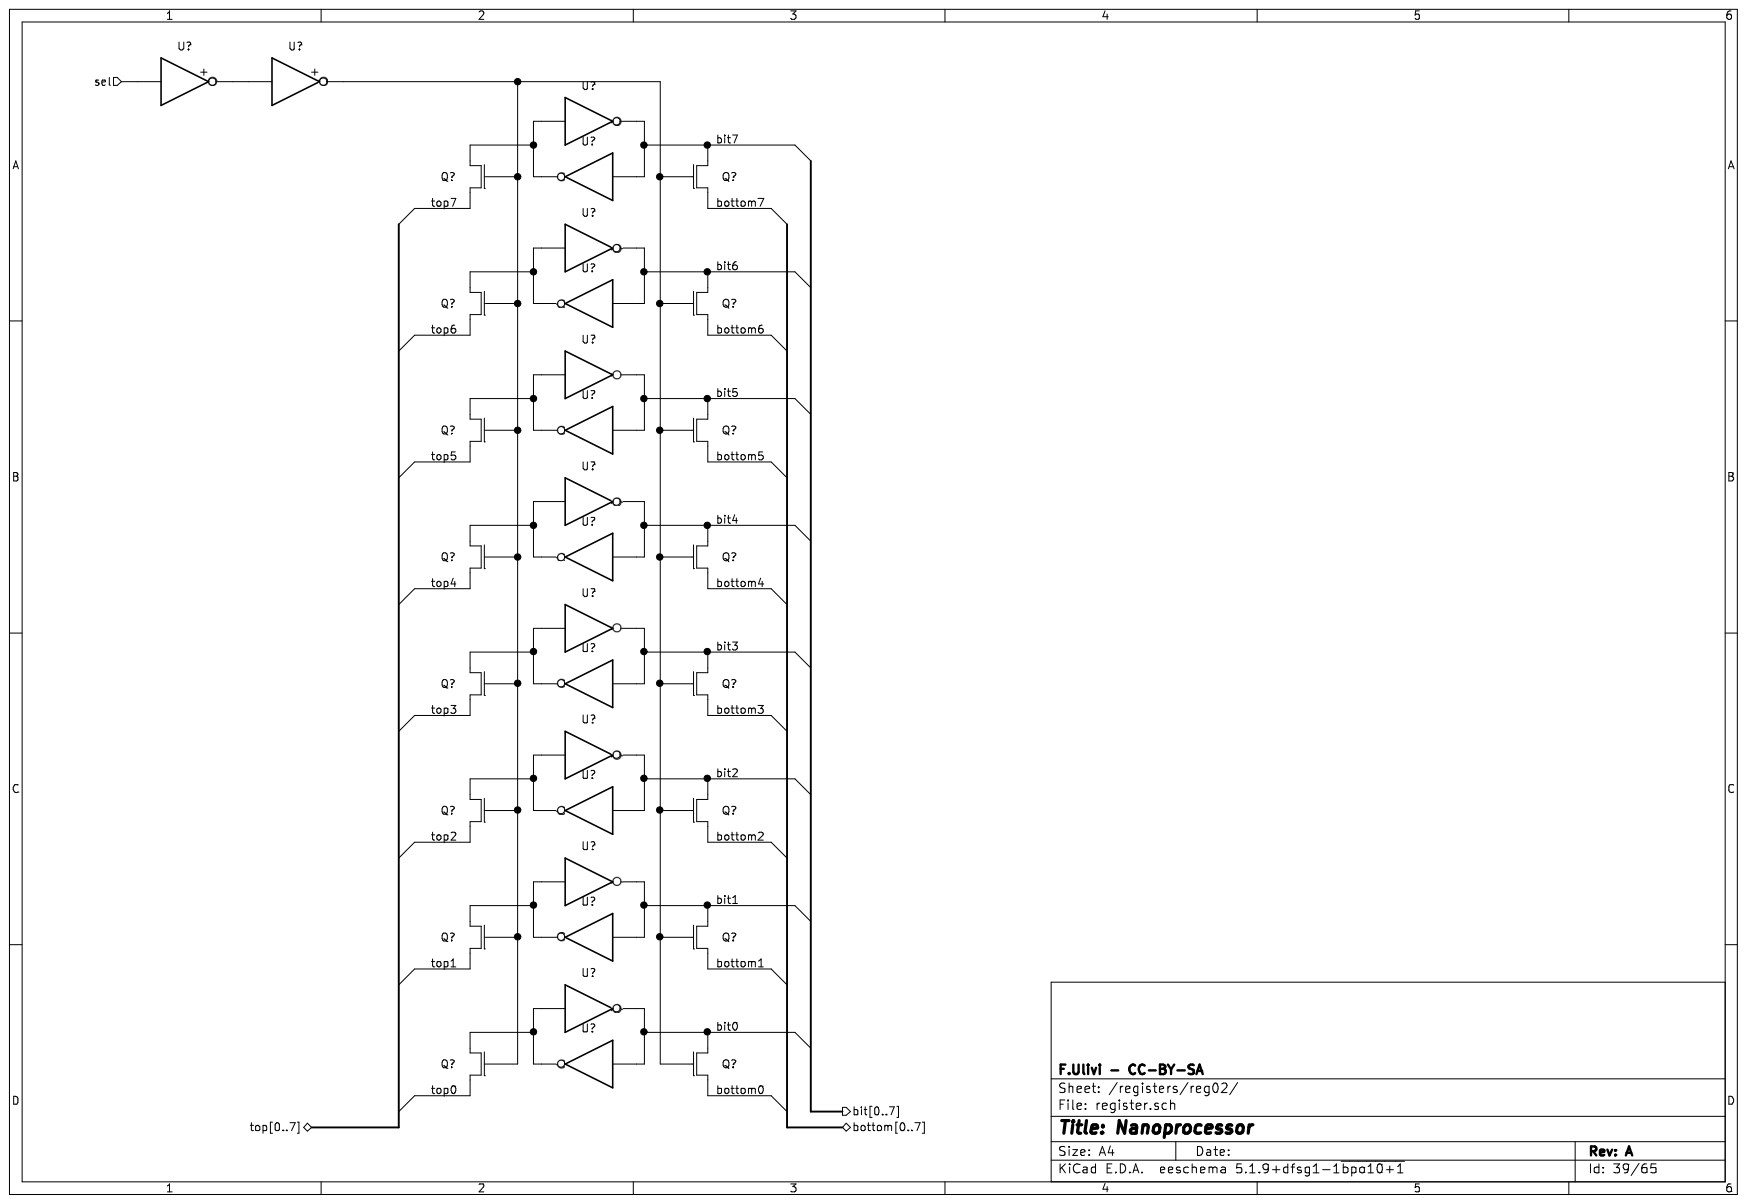
[picture p32: page 39]

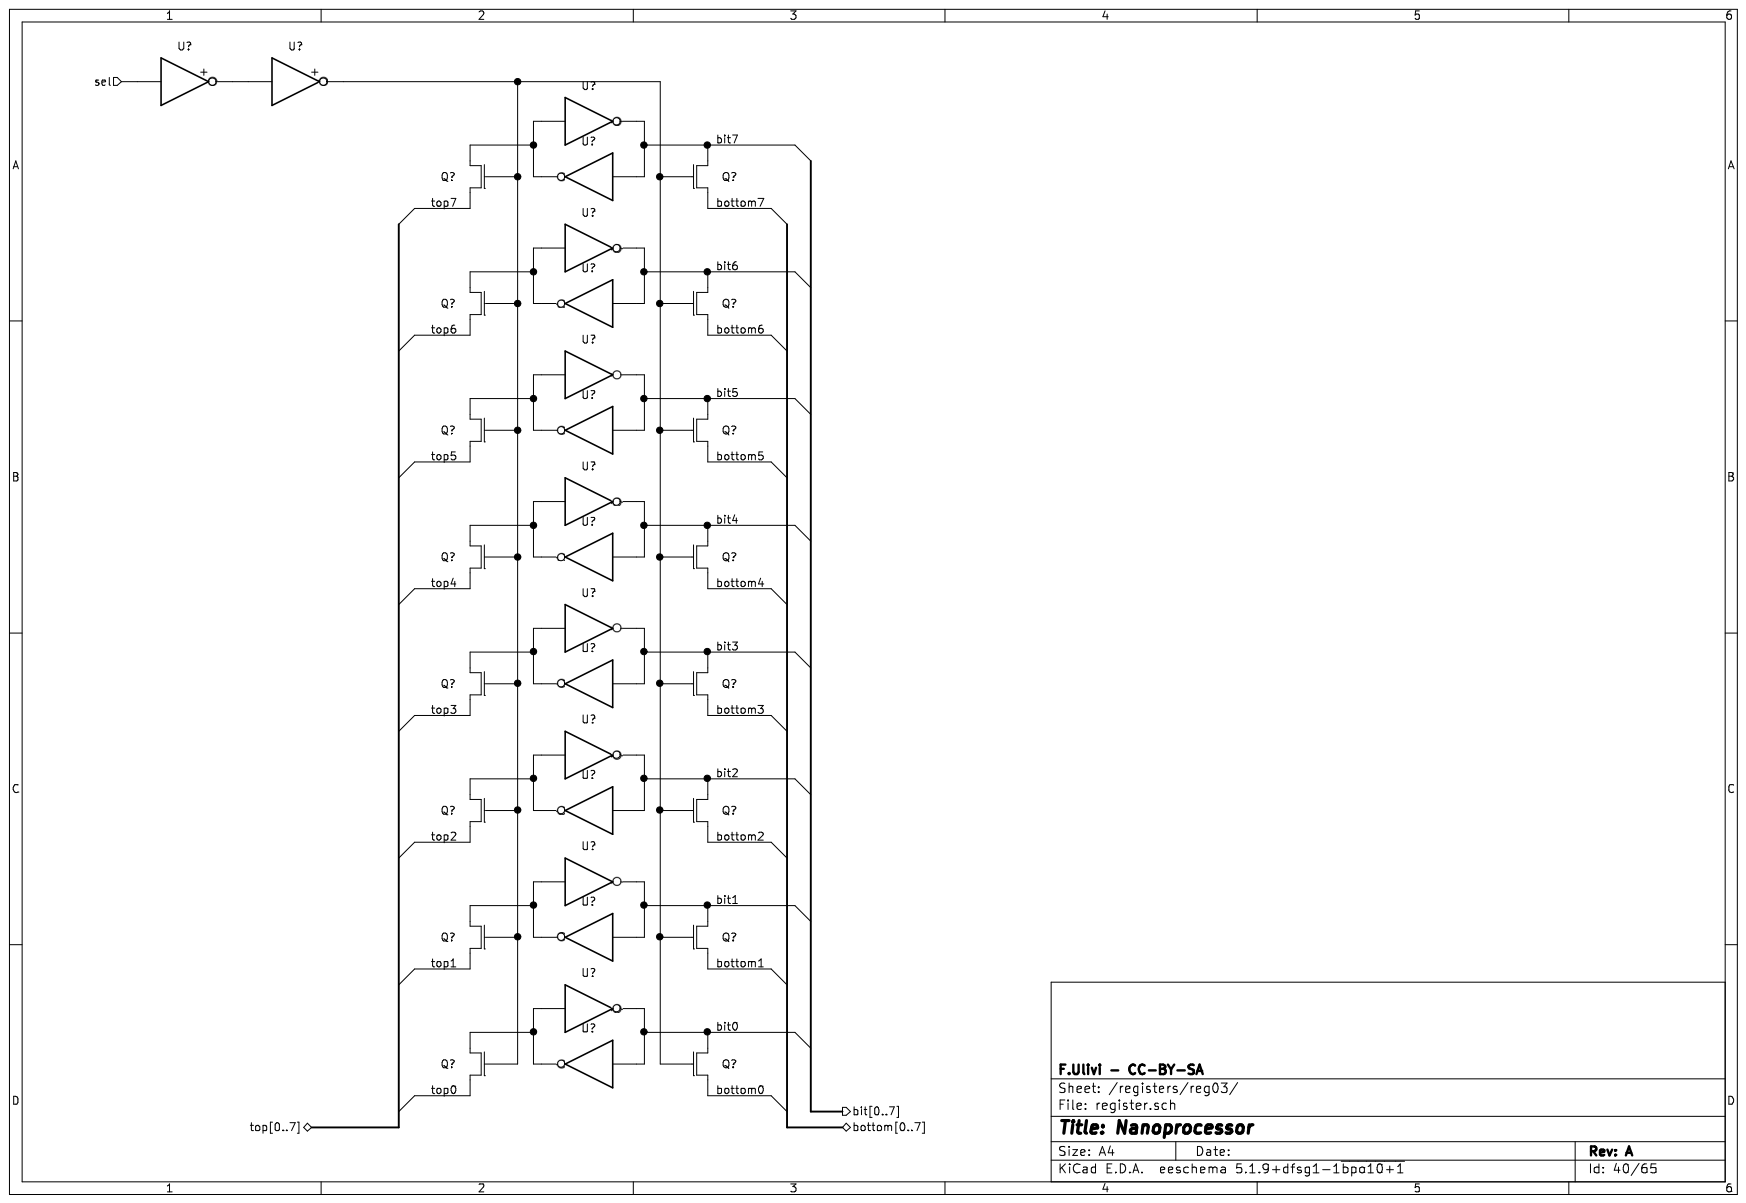
[picture p33: page 40]

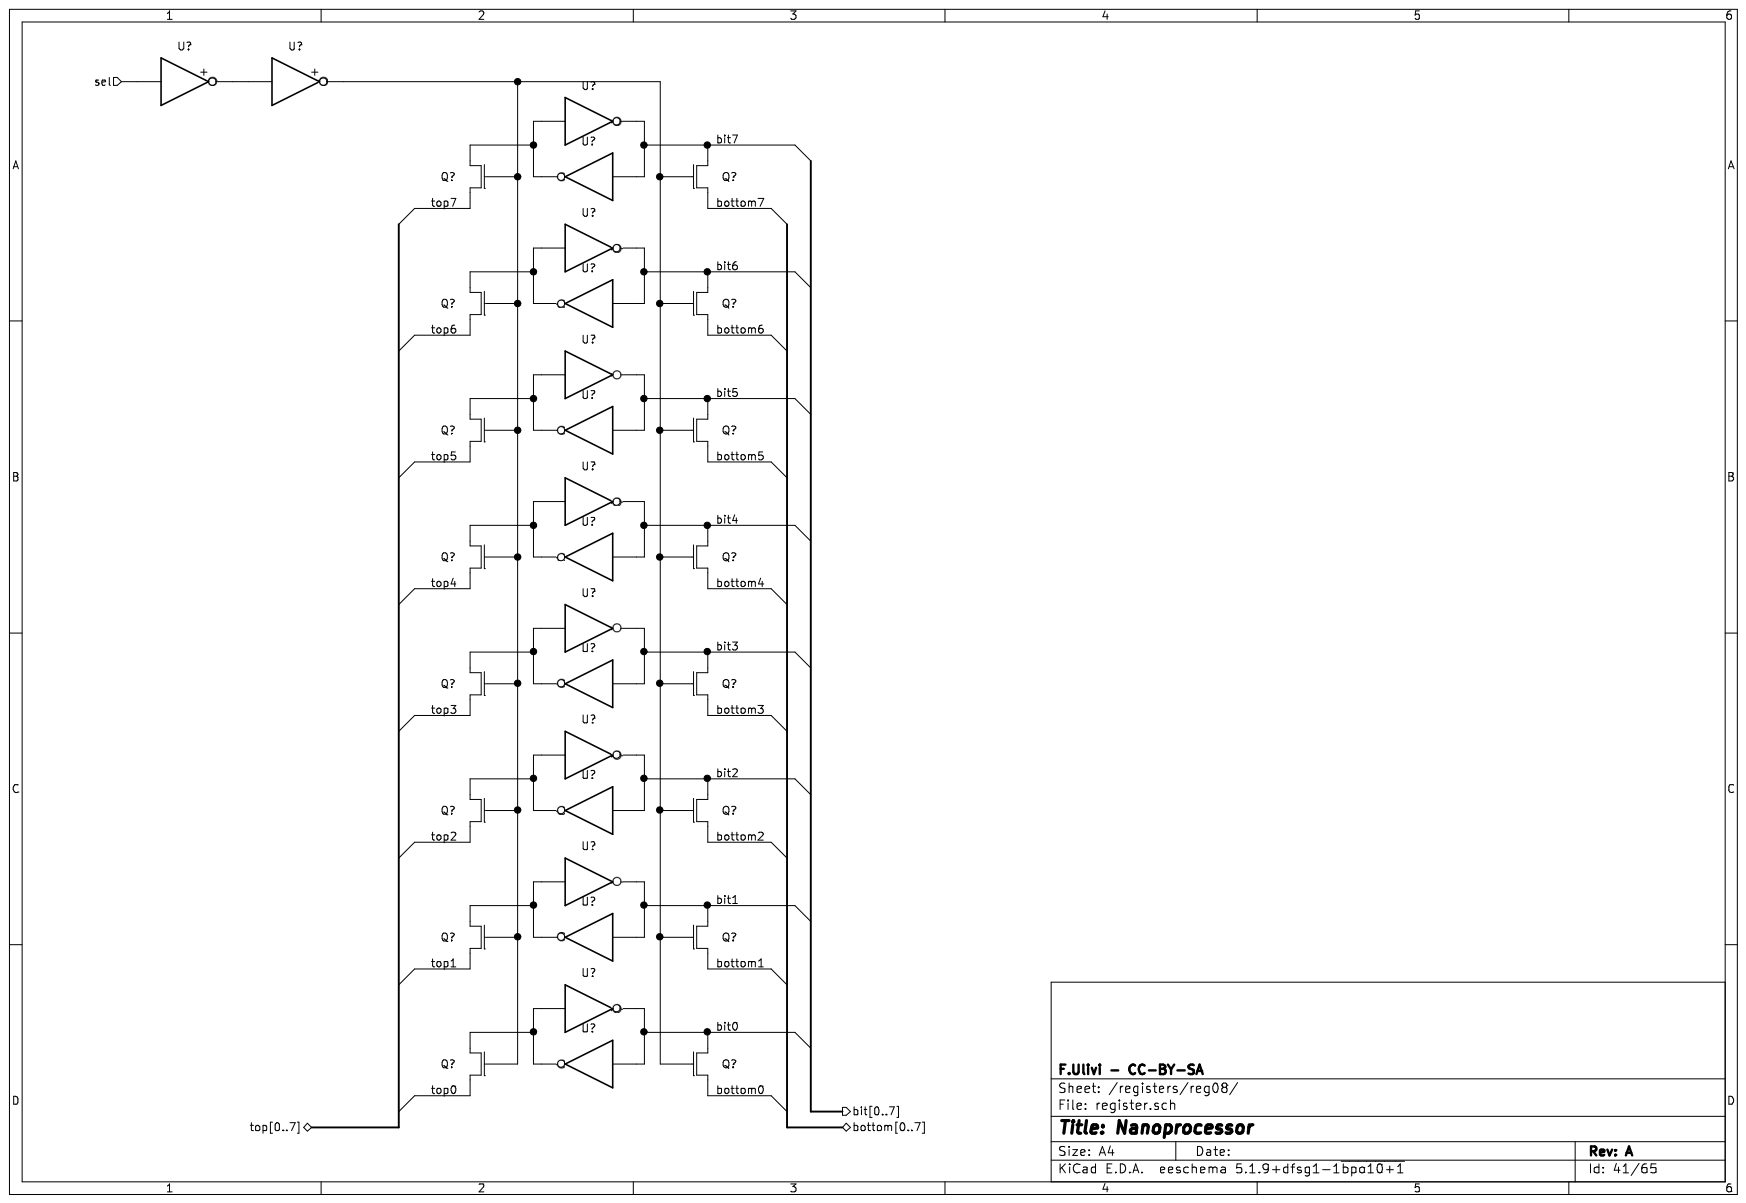
[picture p34: page 41]

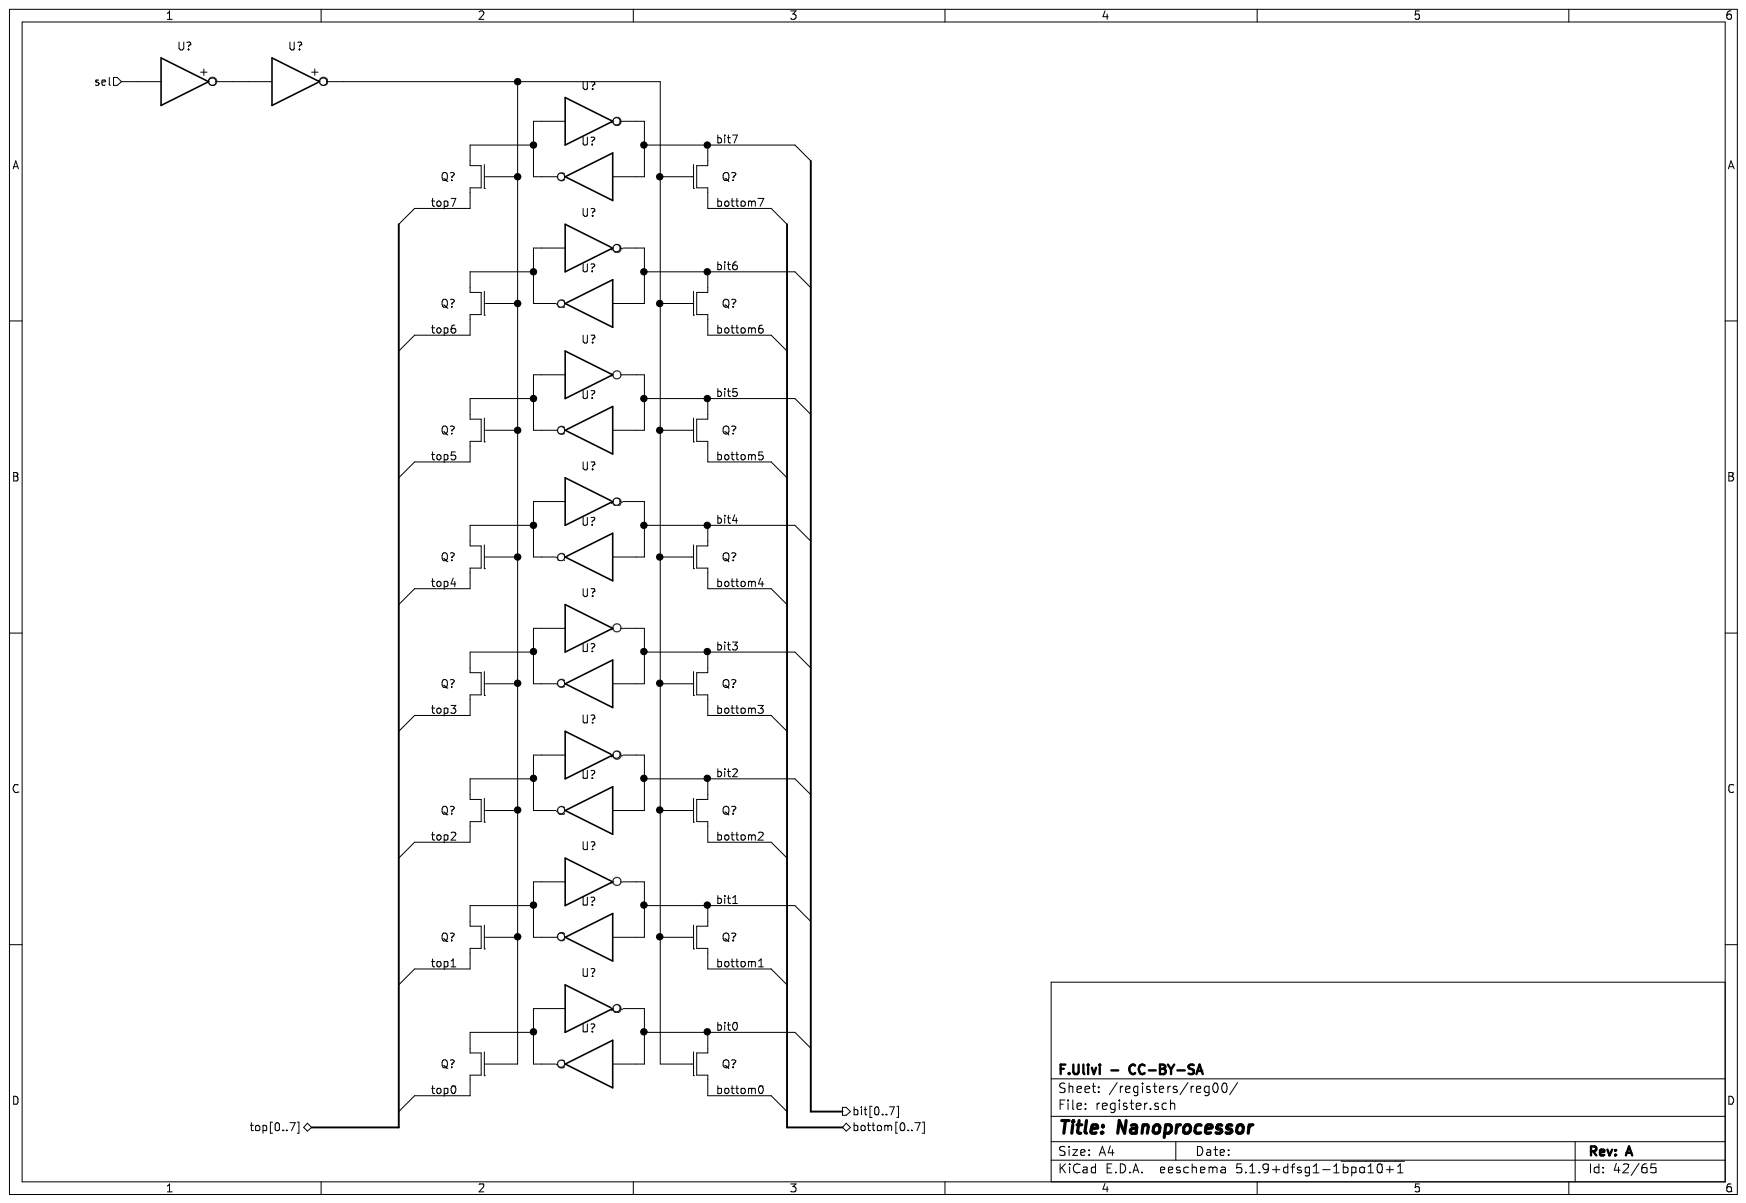
[picture p35: page 42]

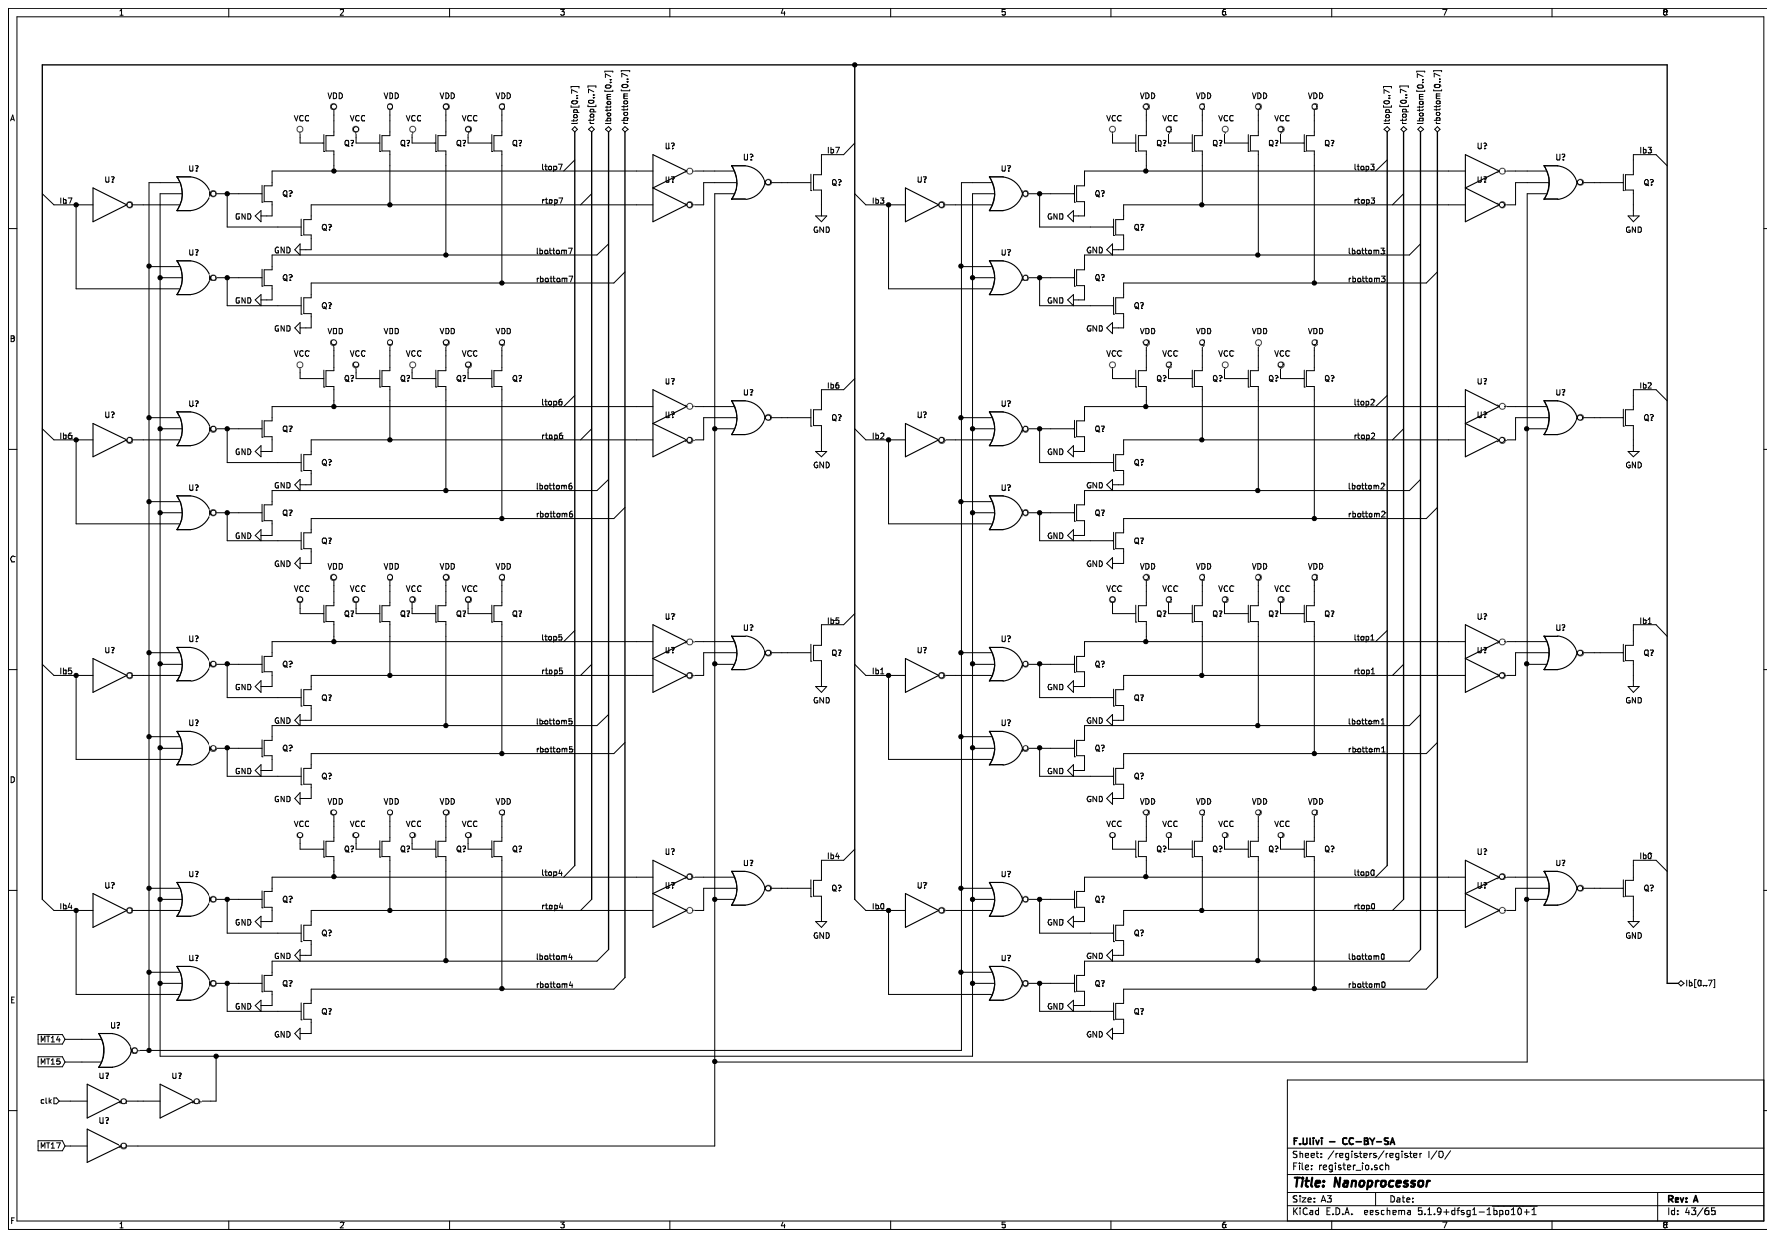
[picture p36: page 43]

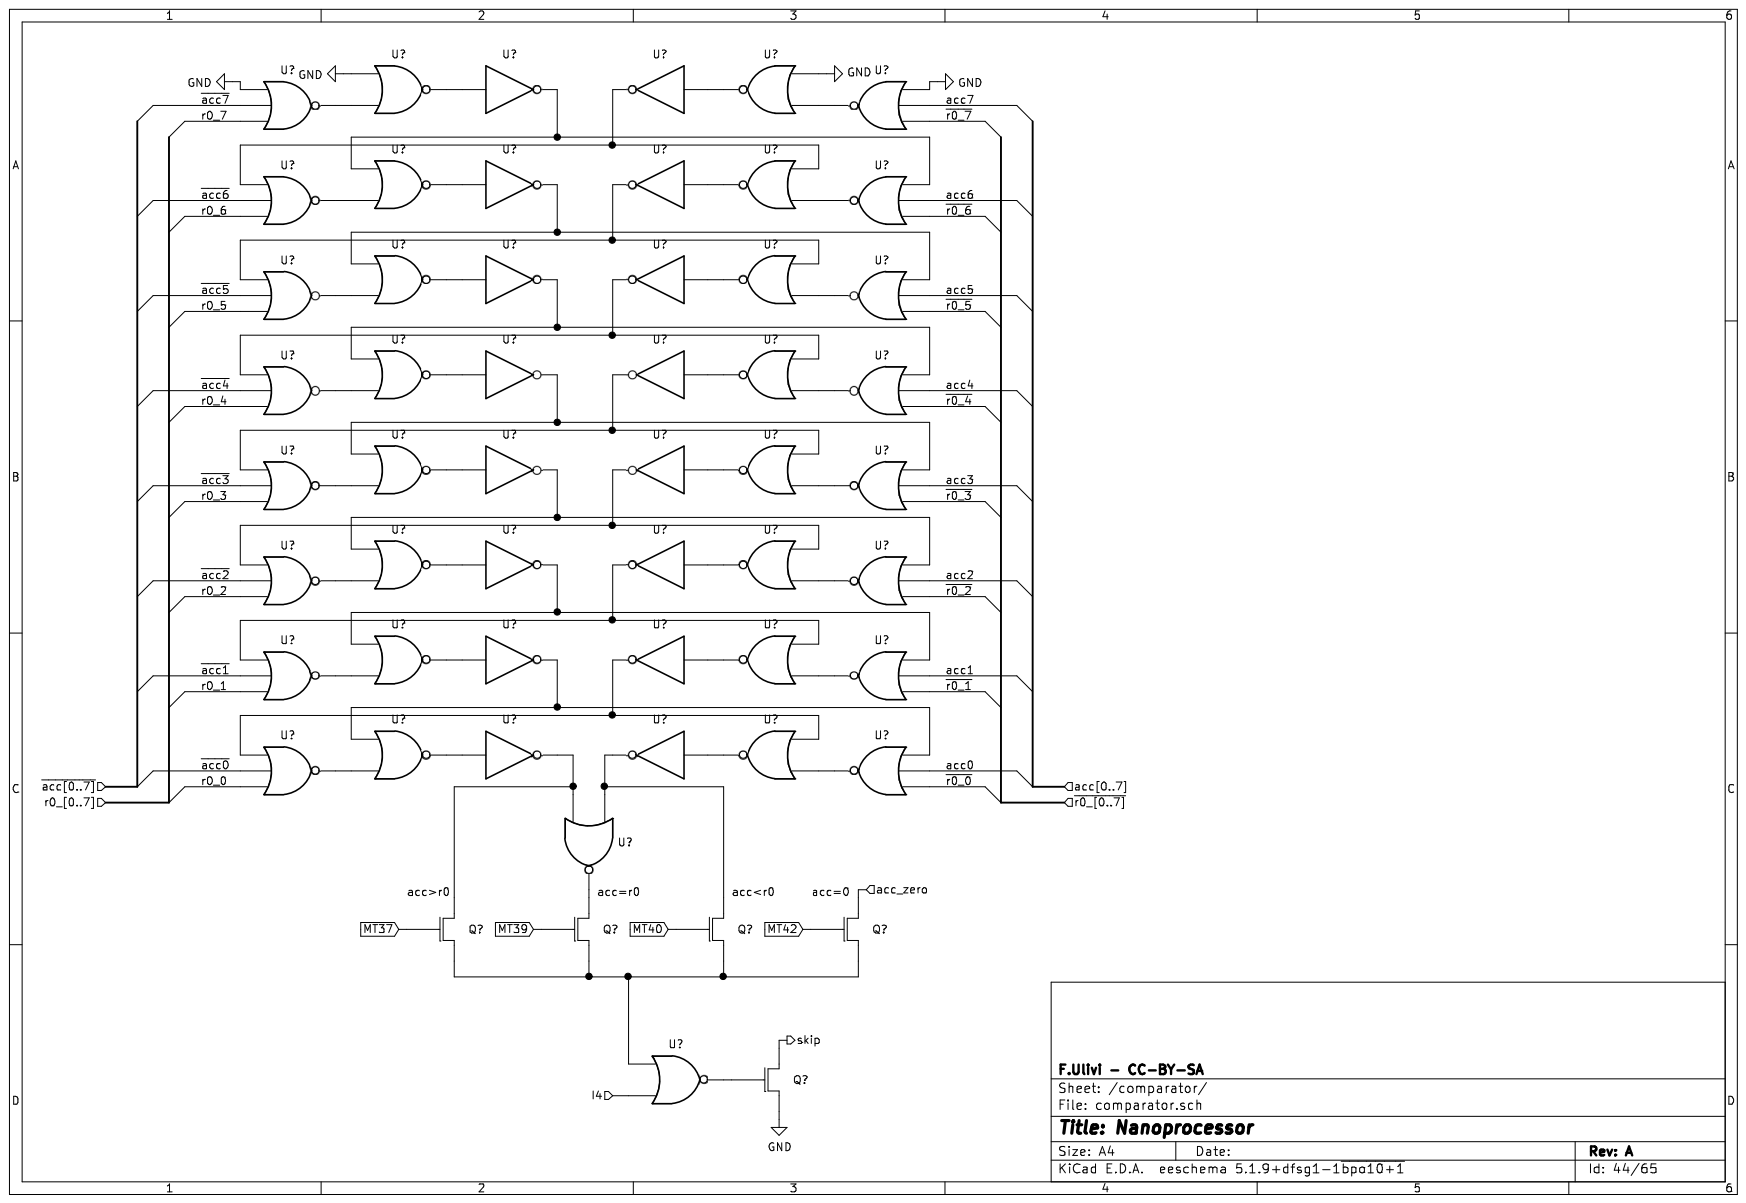
[picture p37: page 44]

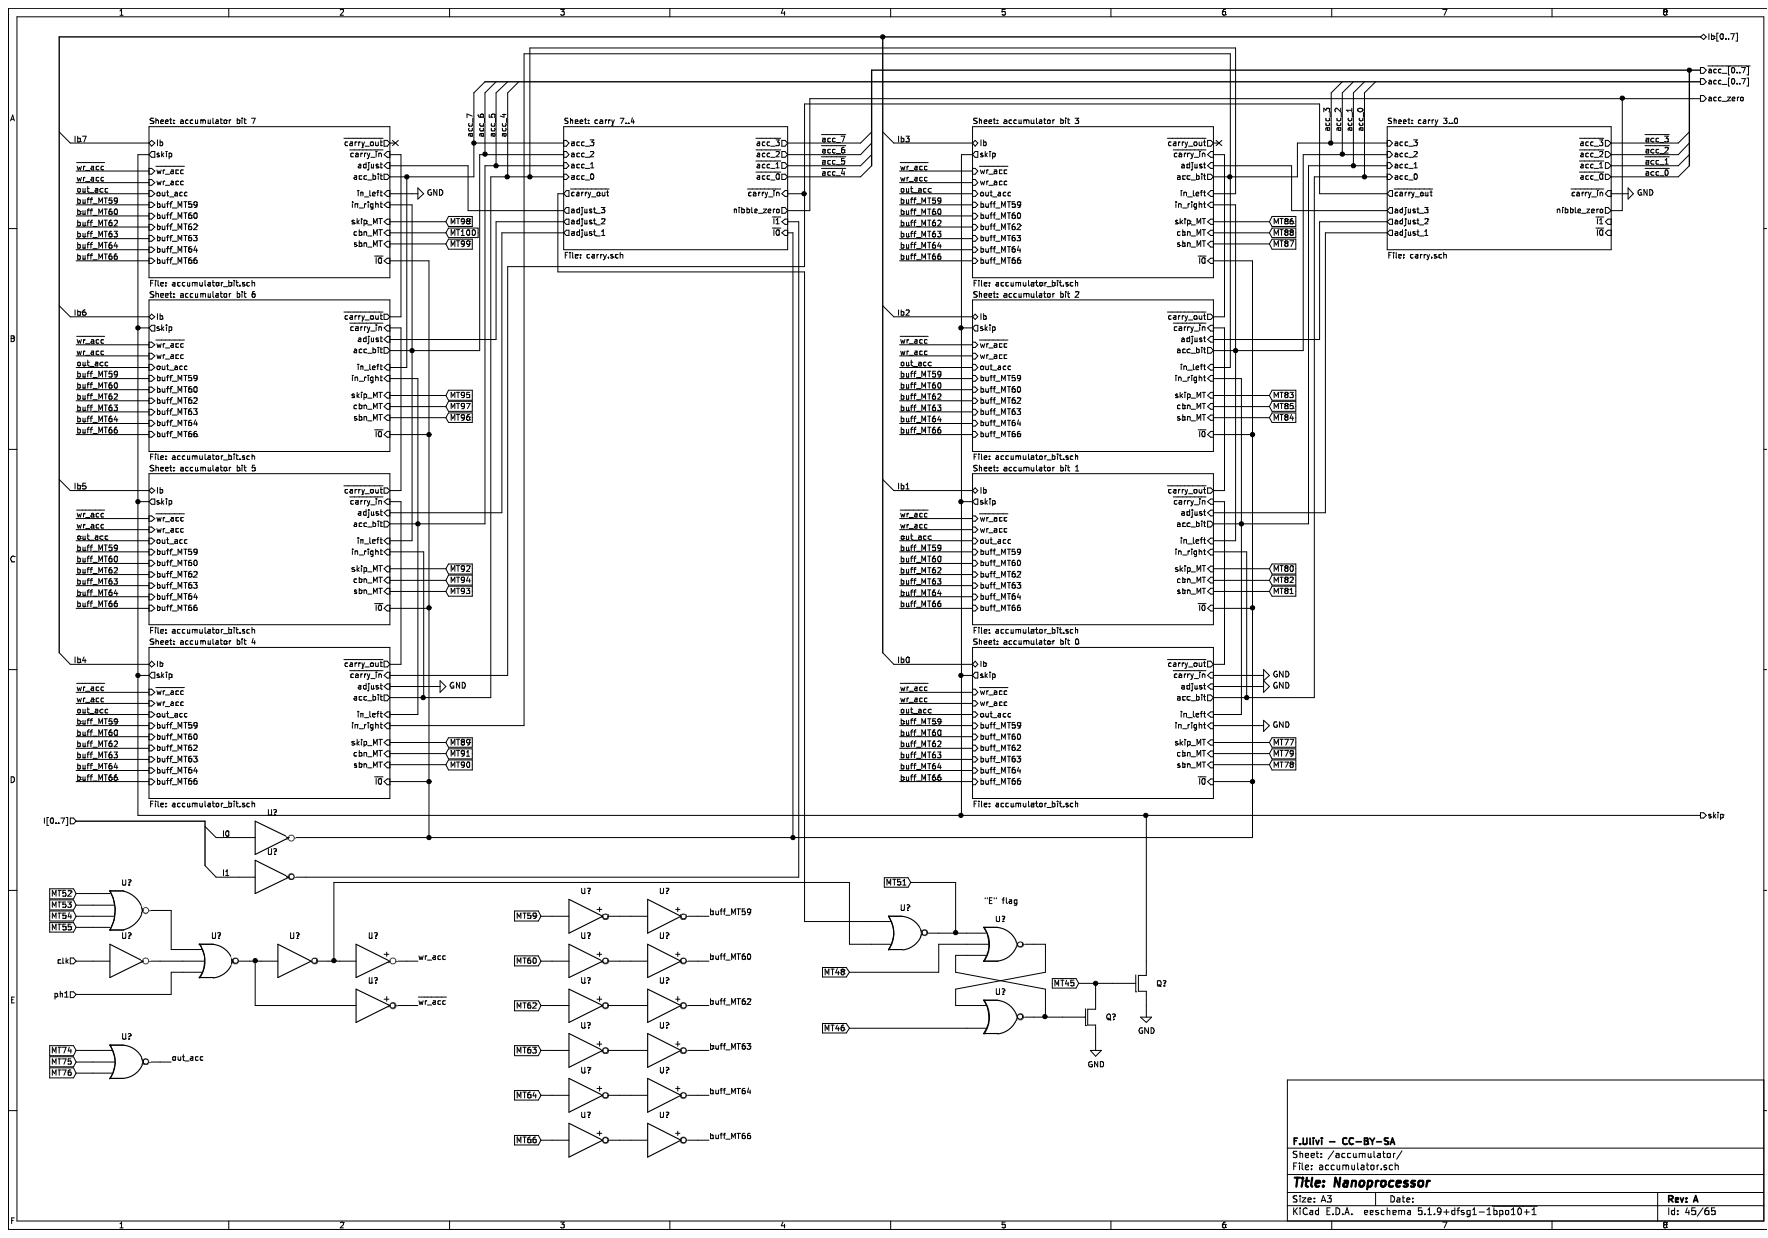
[picture p38: page 45]

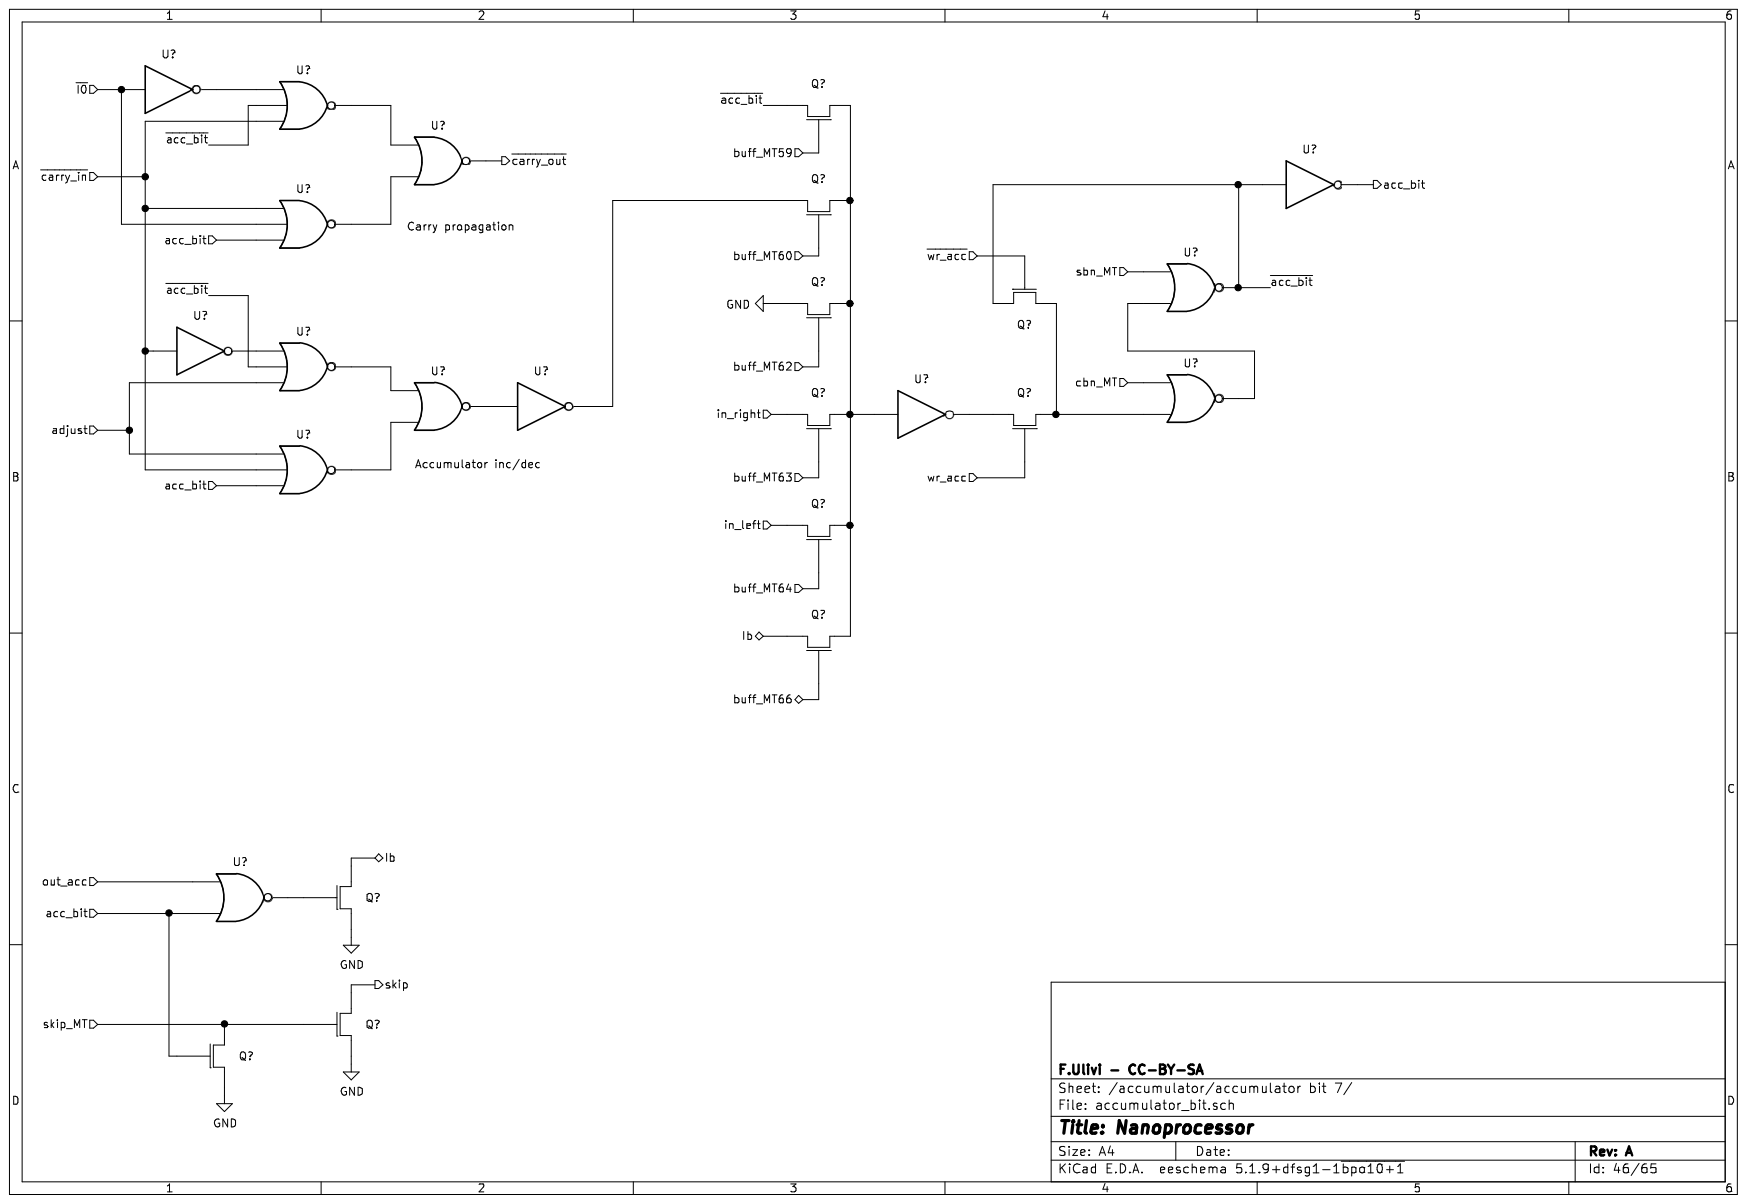
[picture p39: page 46]

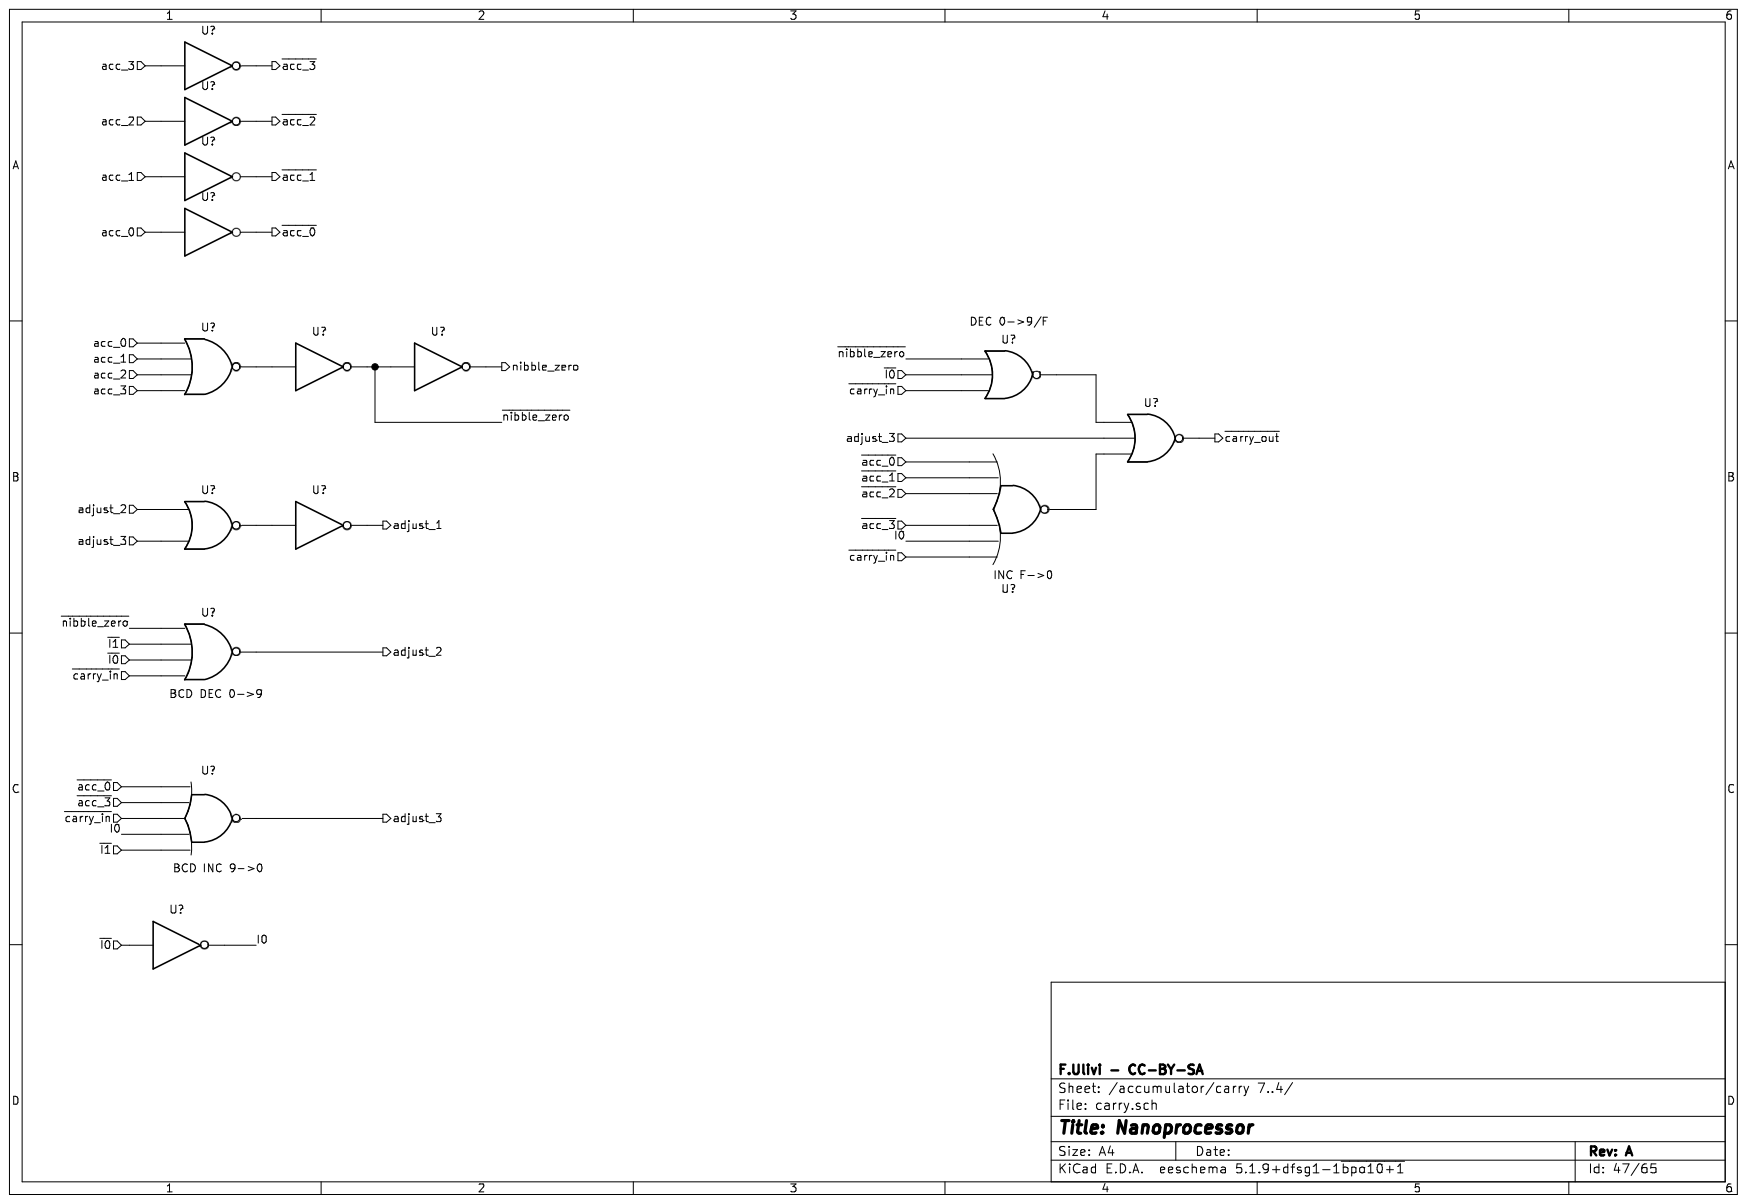
[picture p40: page 47]

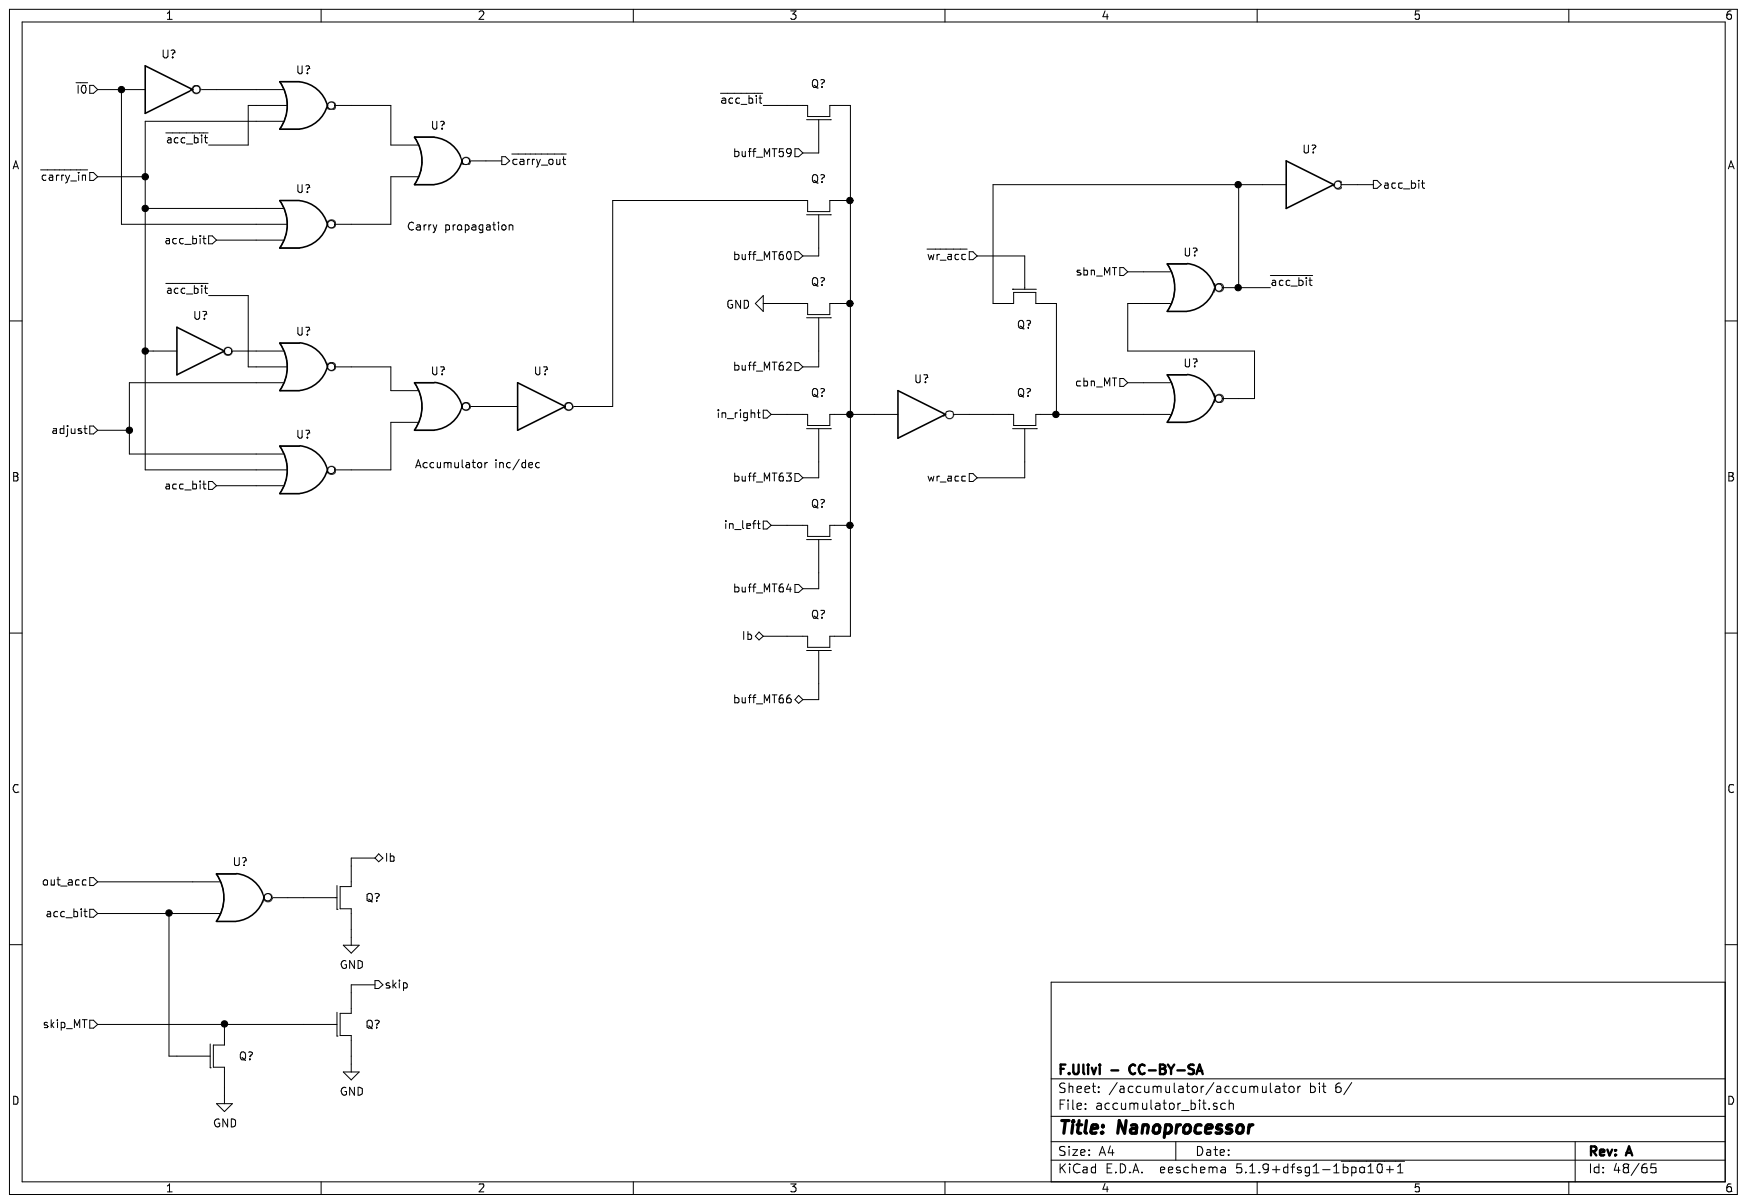
[picture p41: page 48]

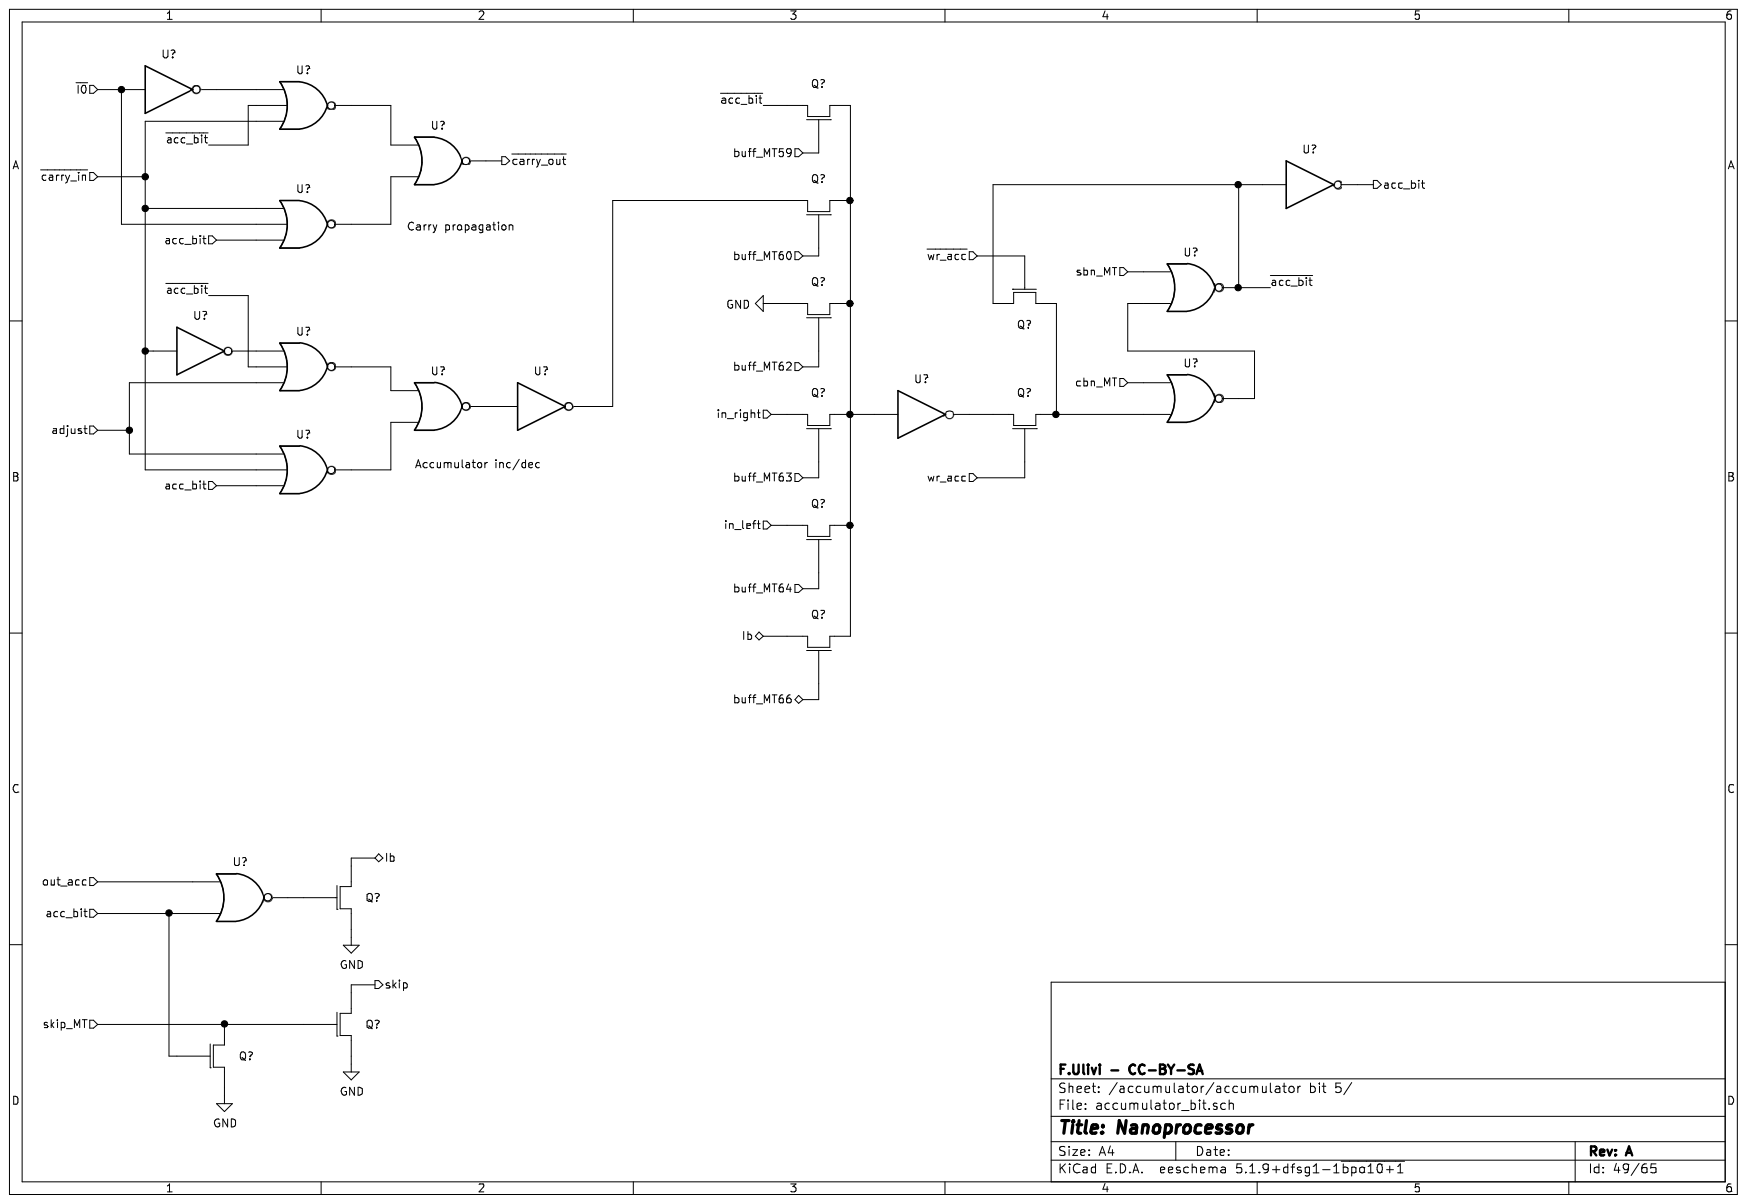
[picture p42: page 49]

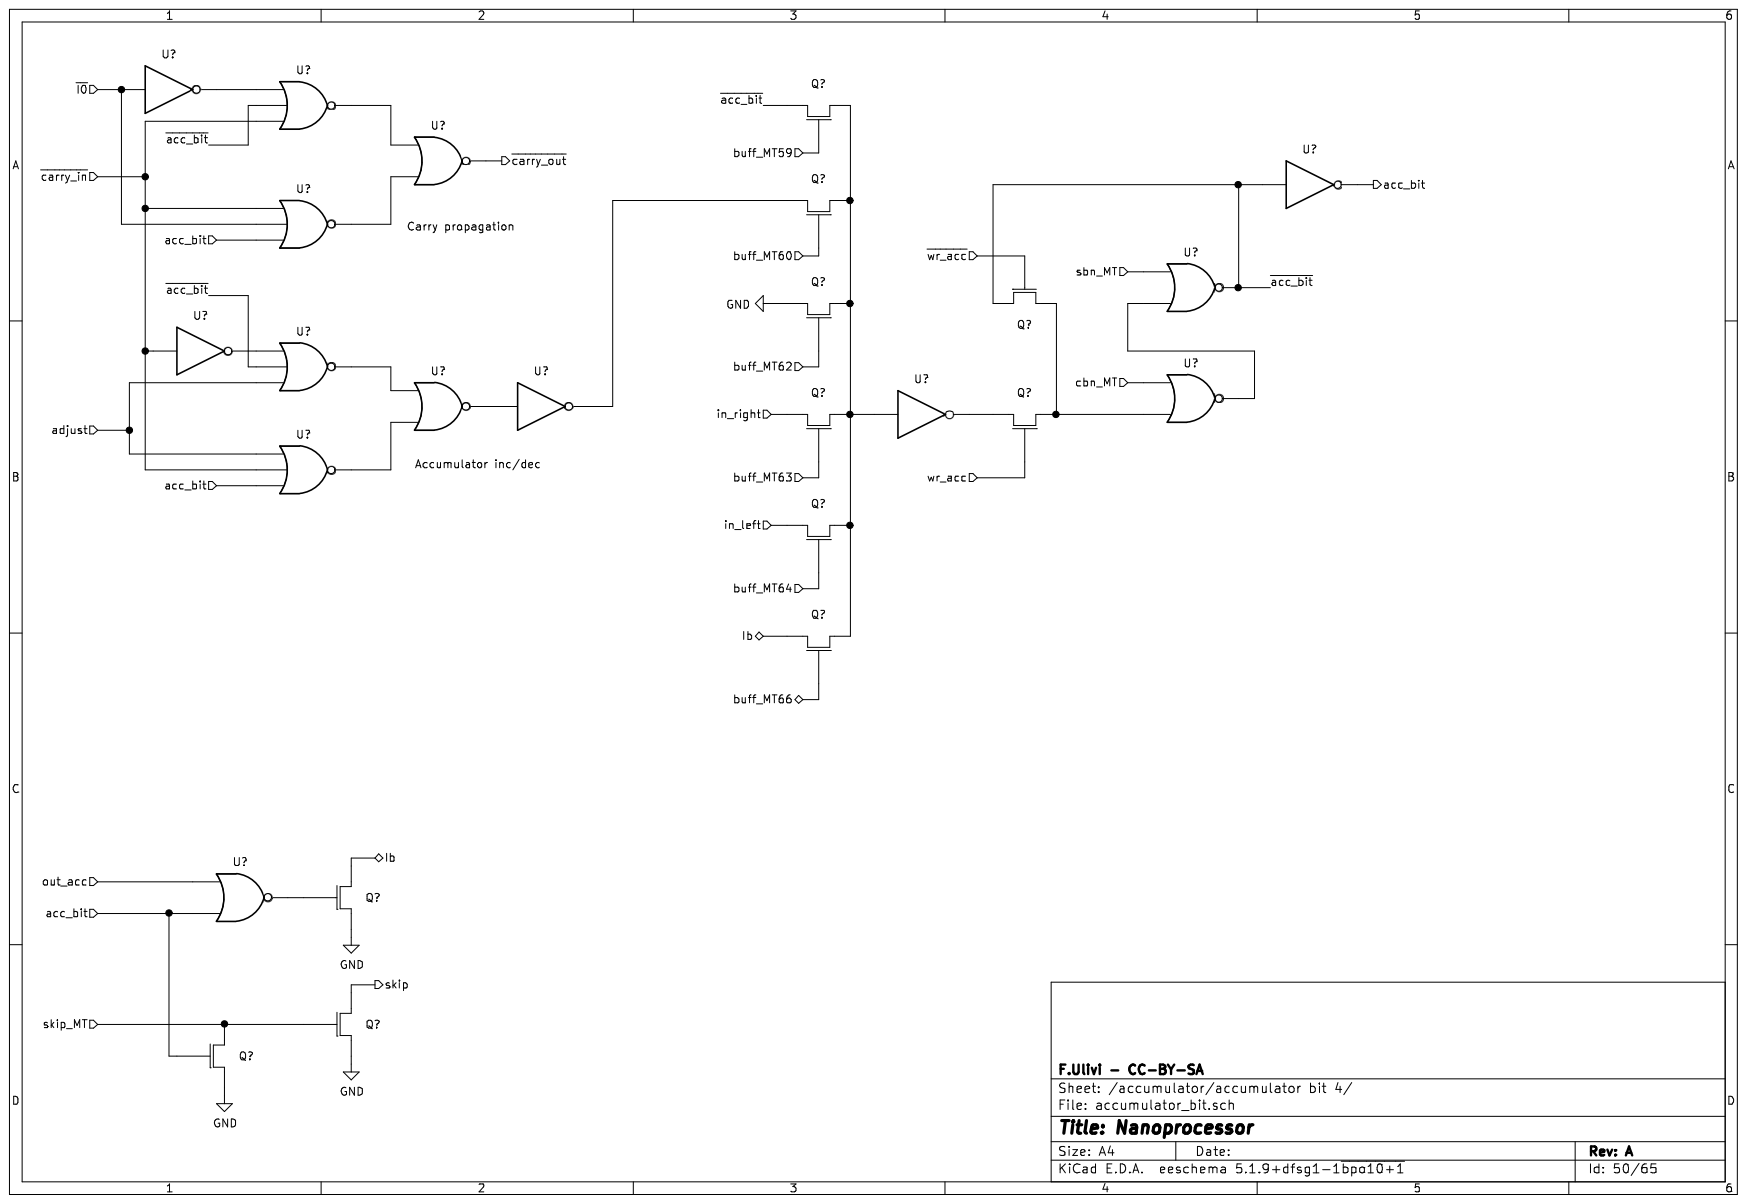
[picture p43: page 50]

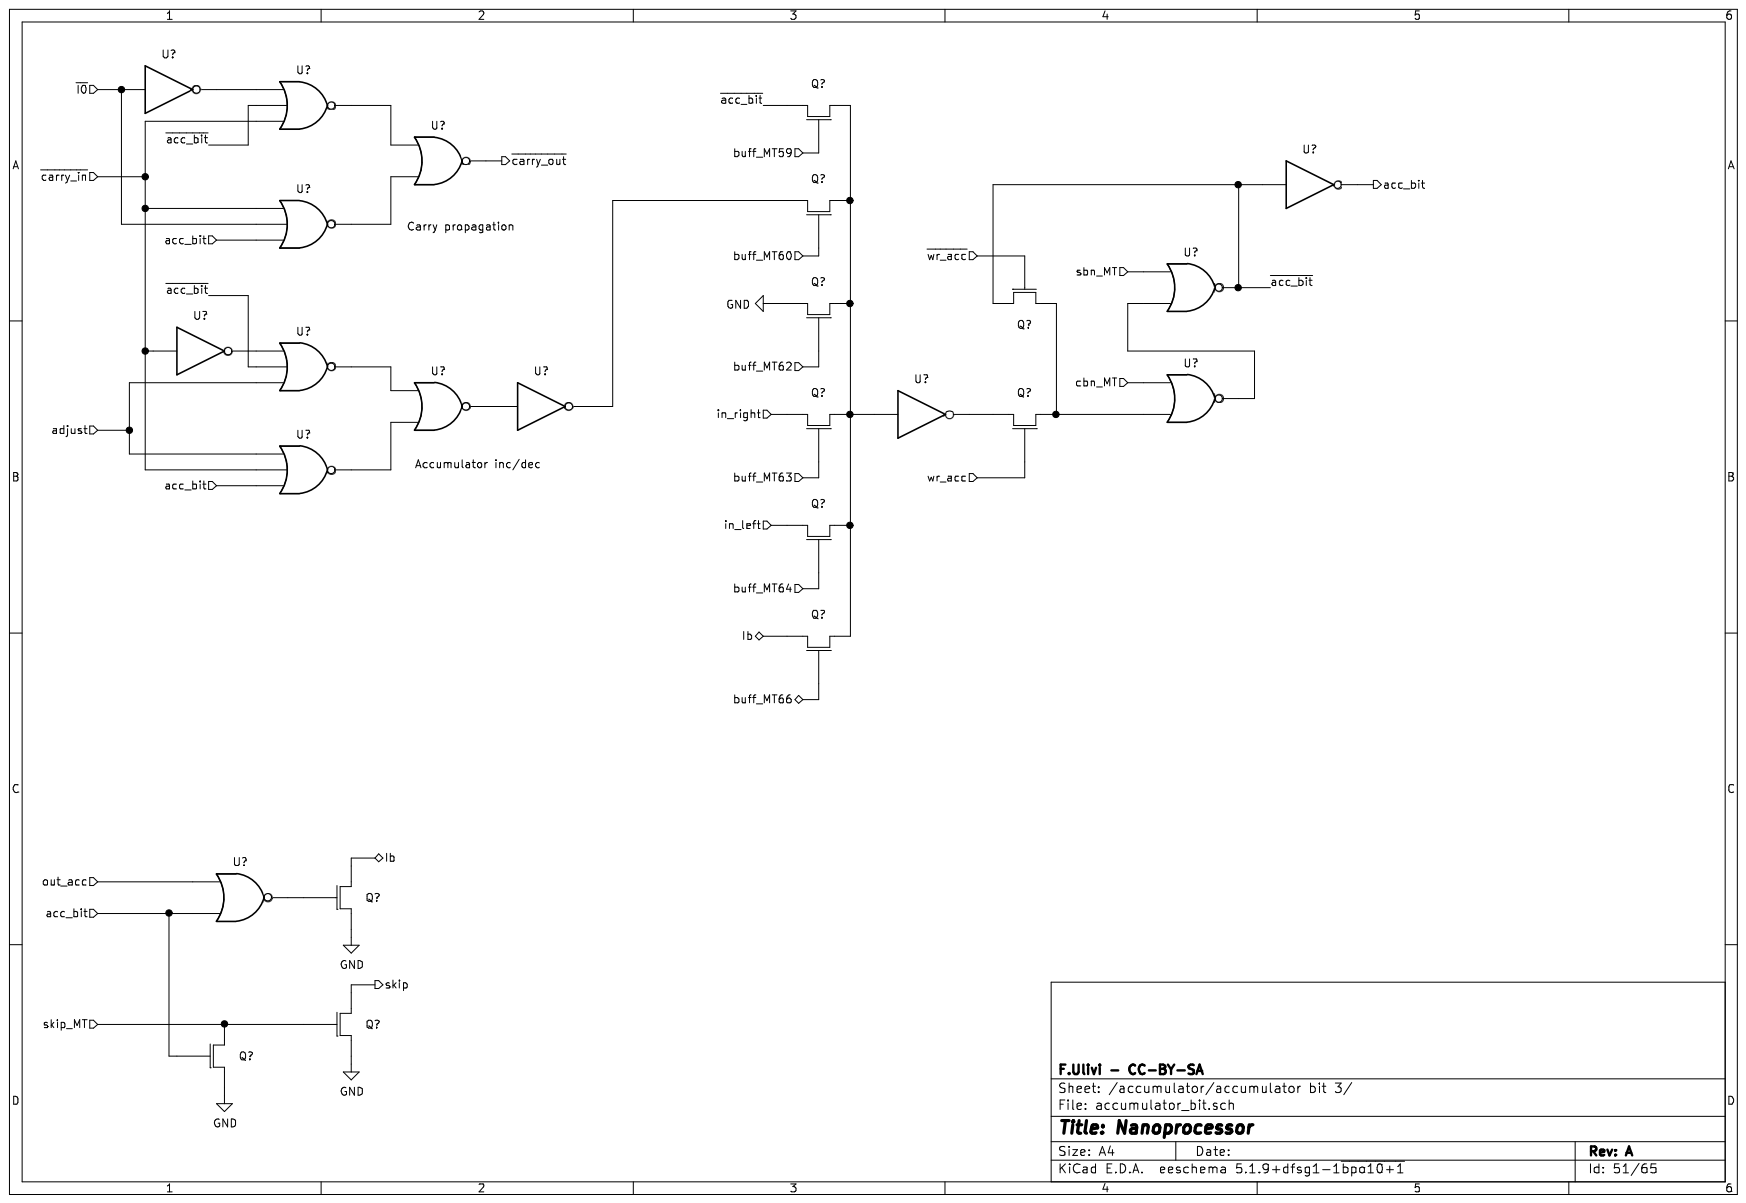
[picture p44: page 51]

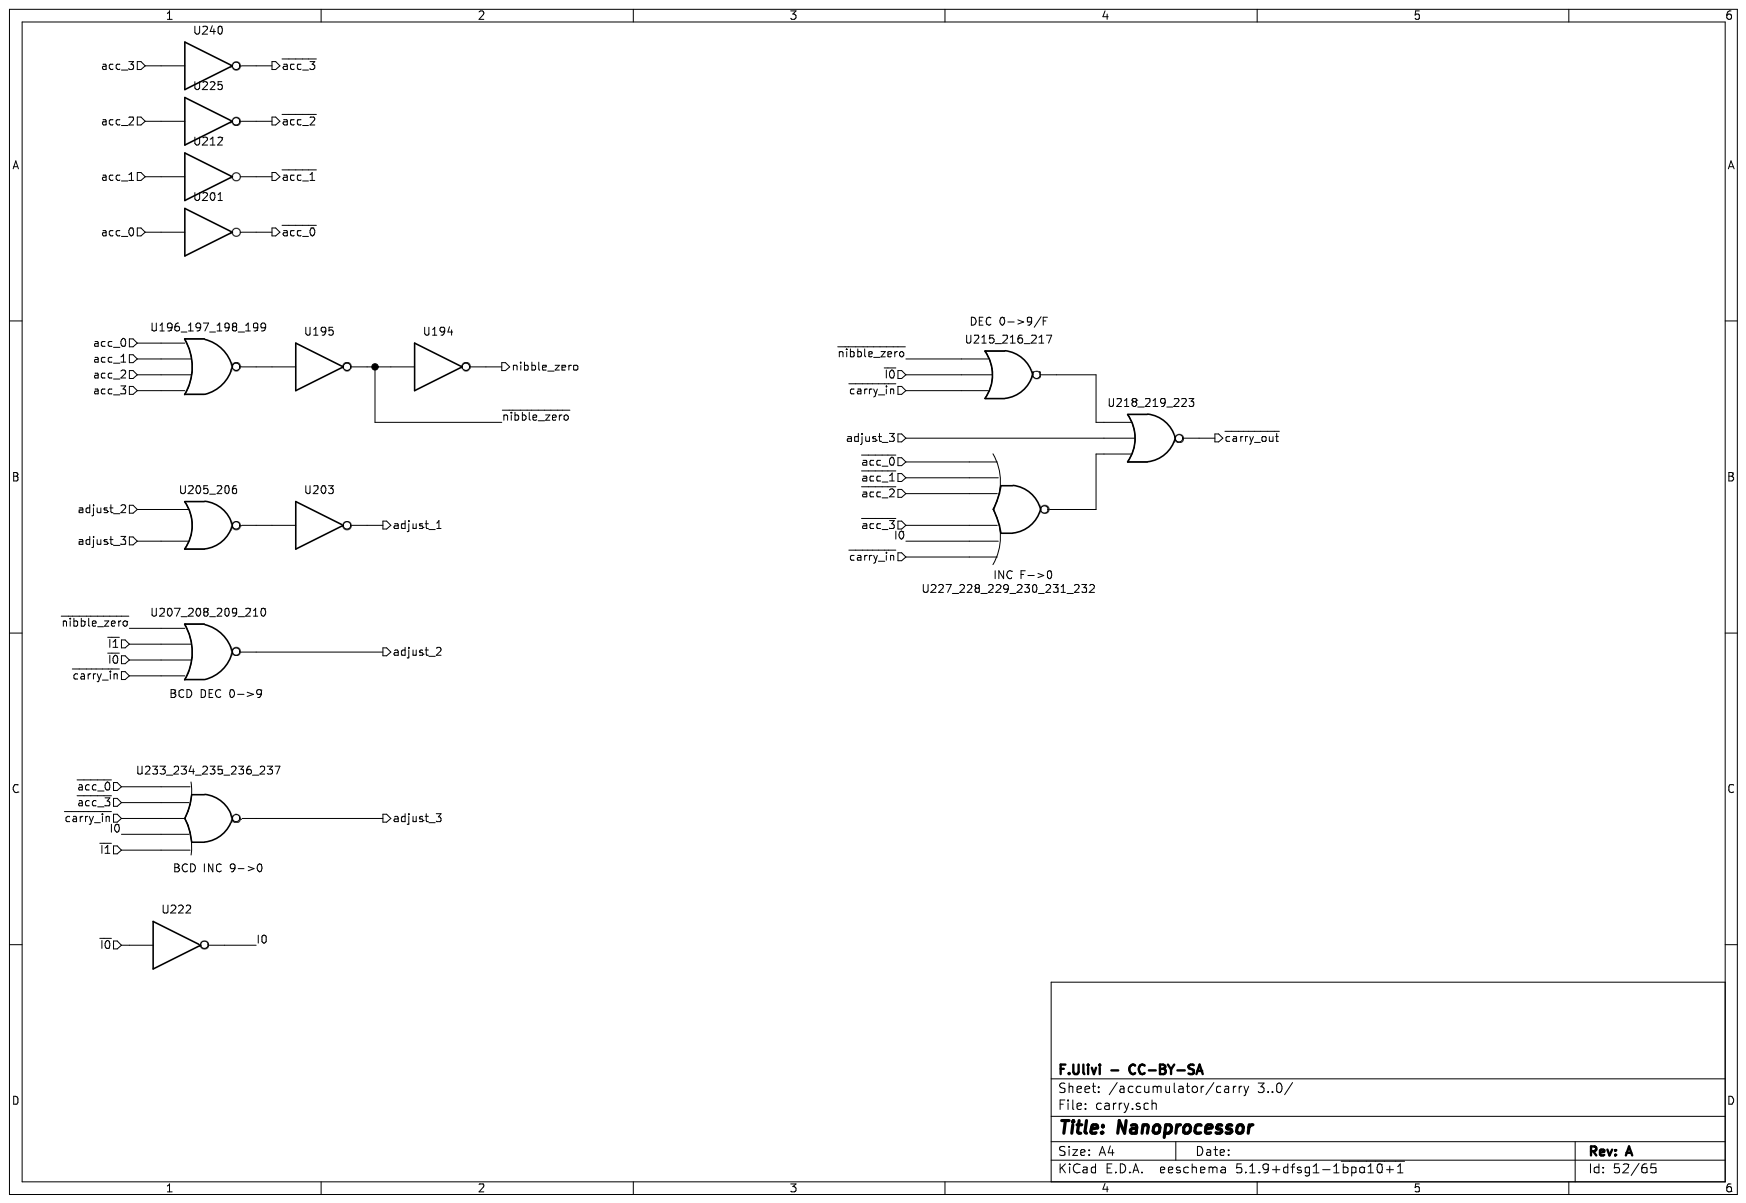
[picture p45: page 52]

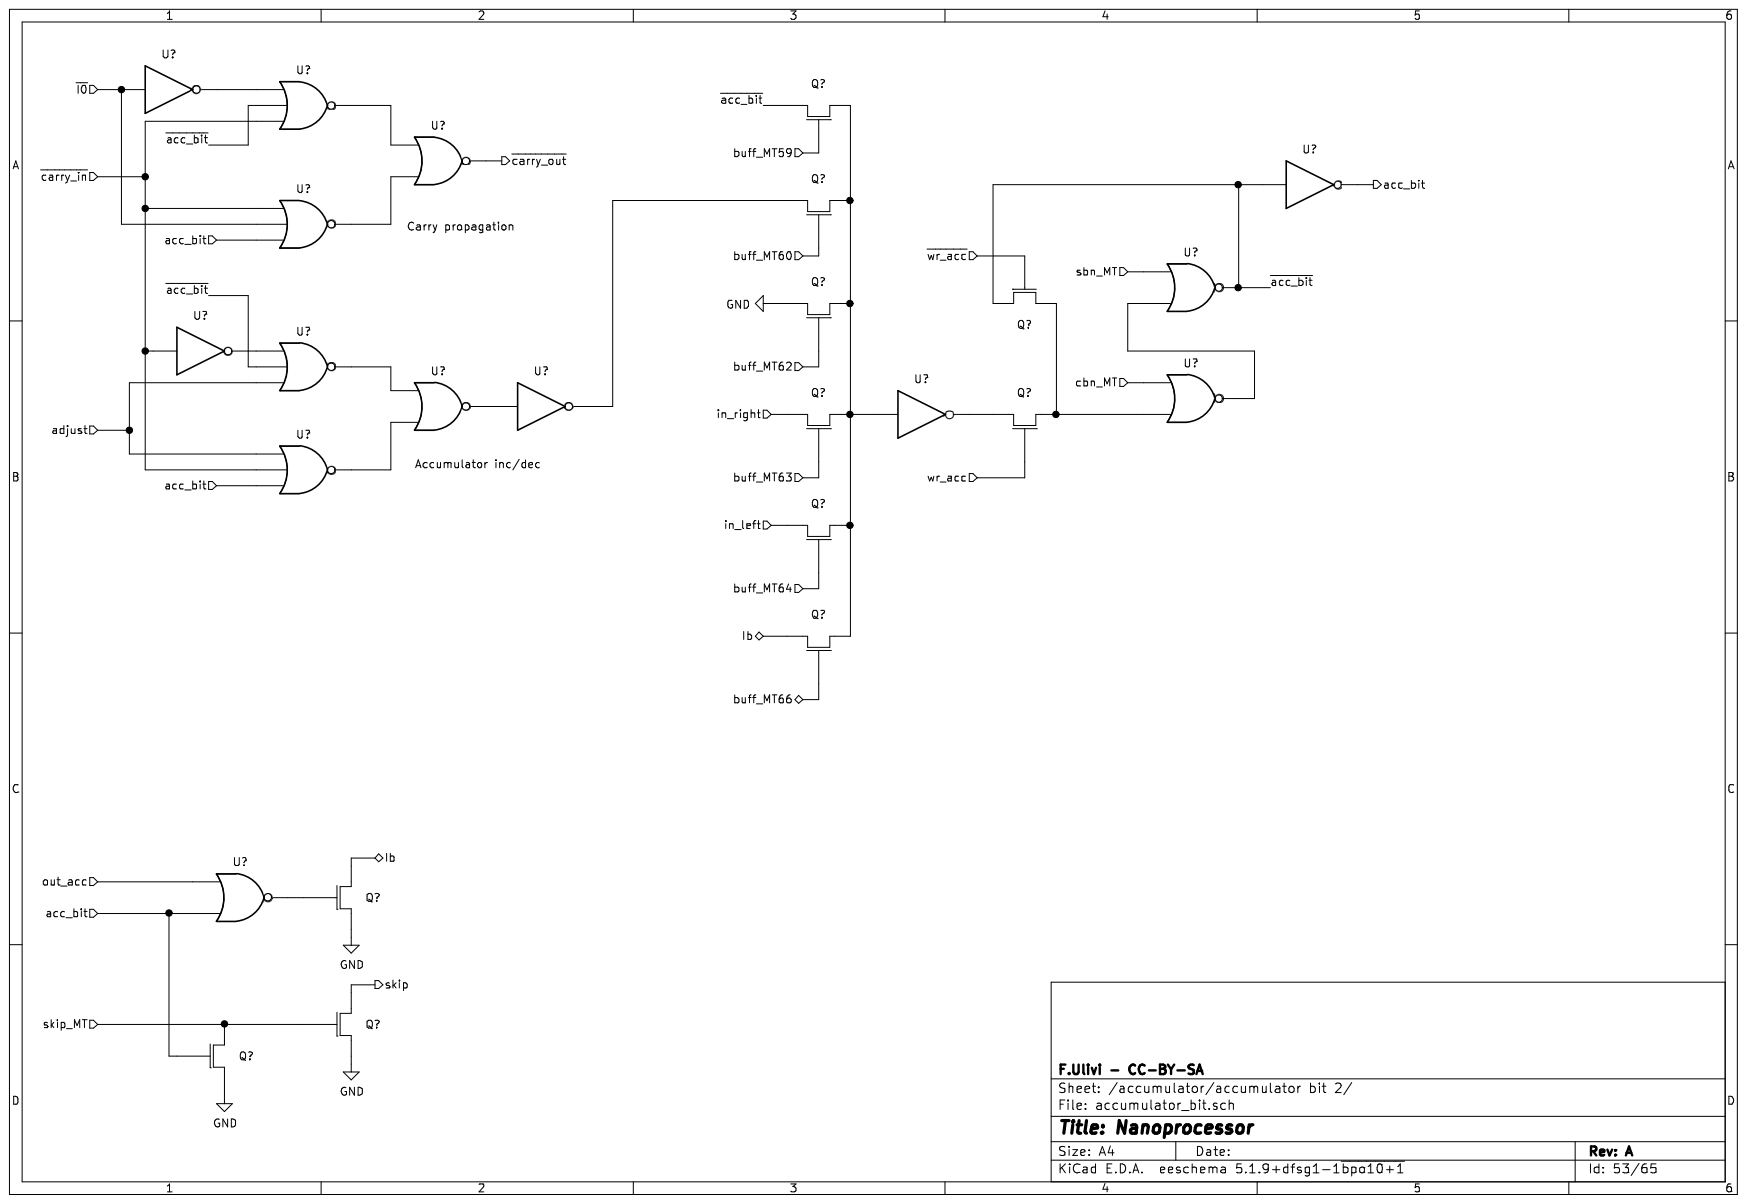
[picture p46: page 53]

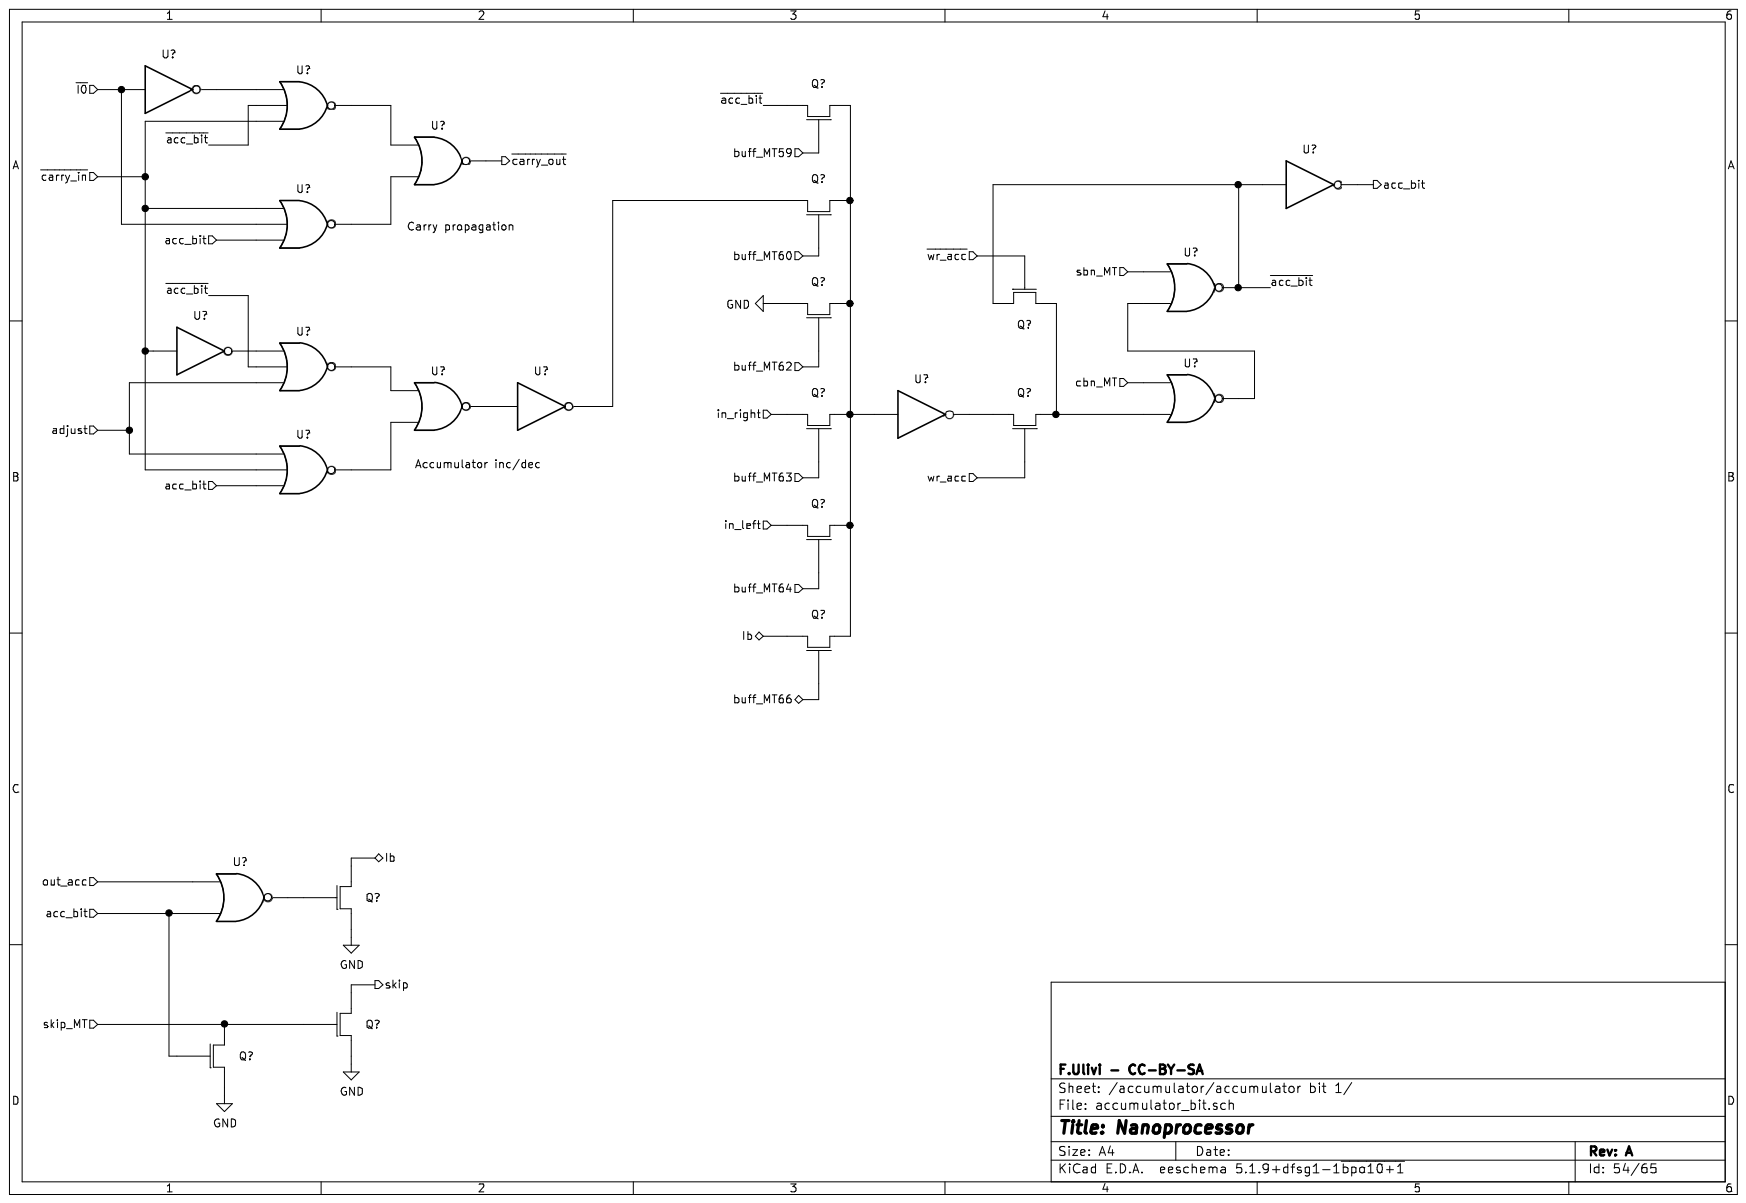
[picture p47: page 54]

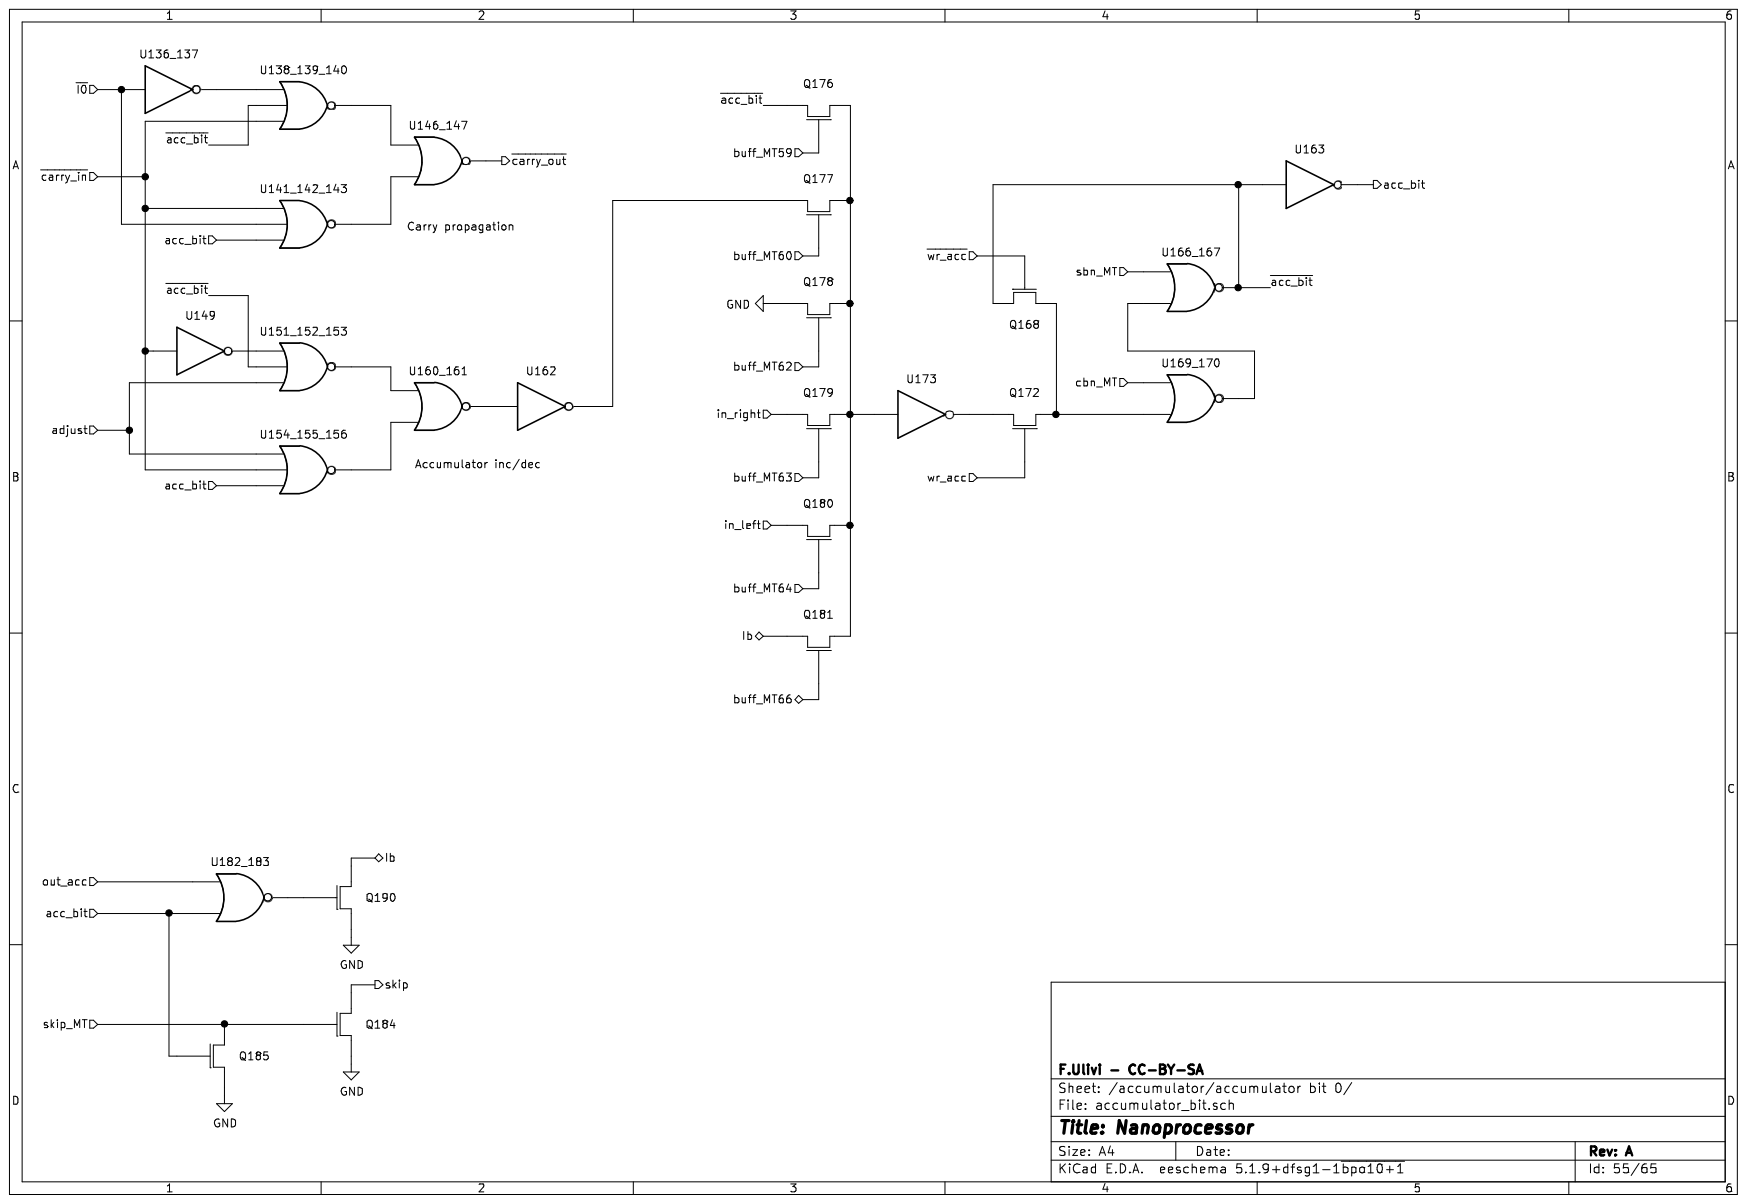
[picture p48: page 55]

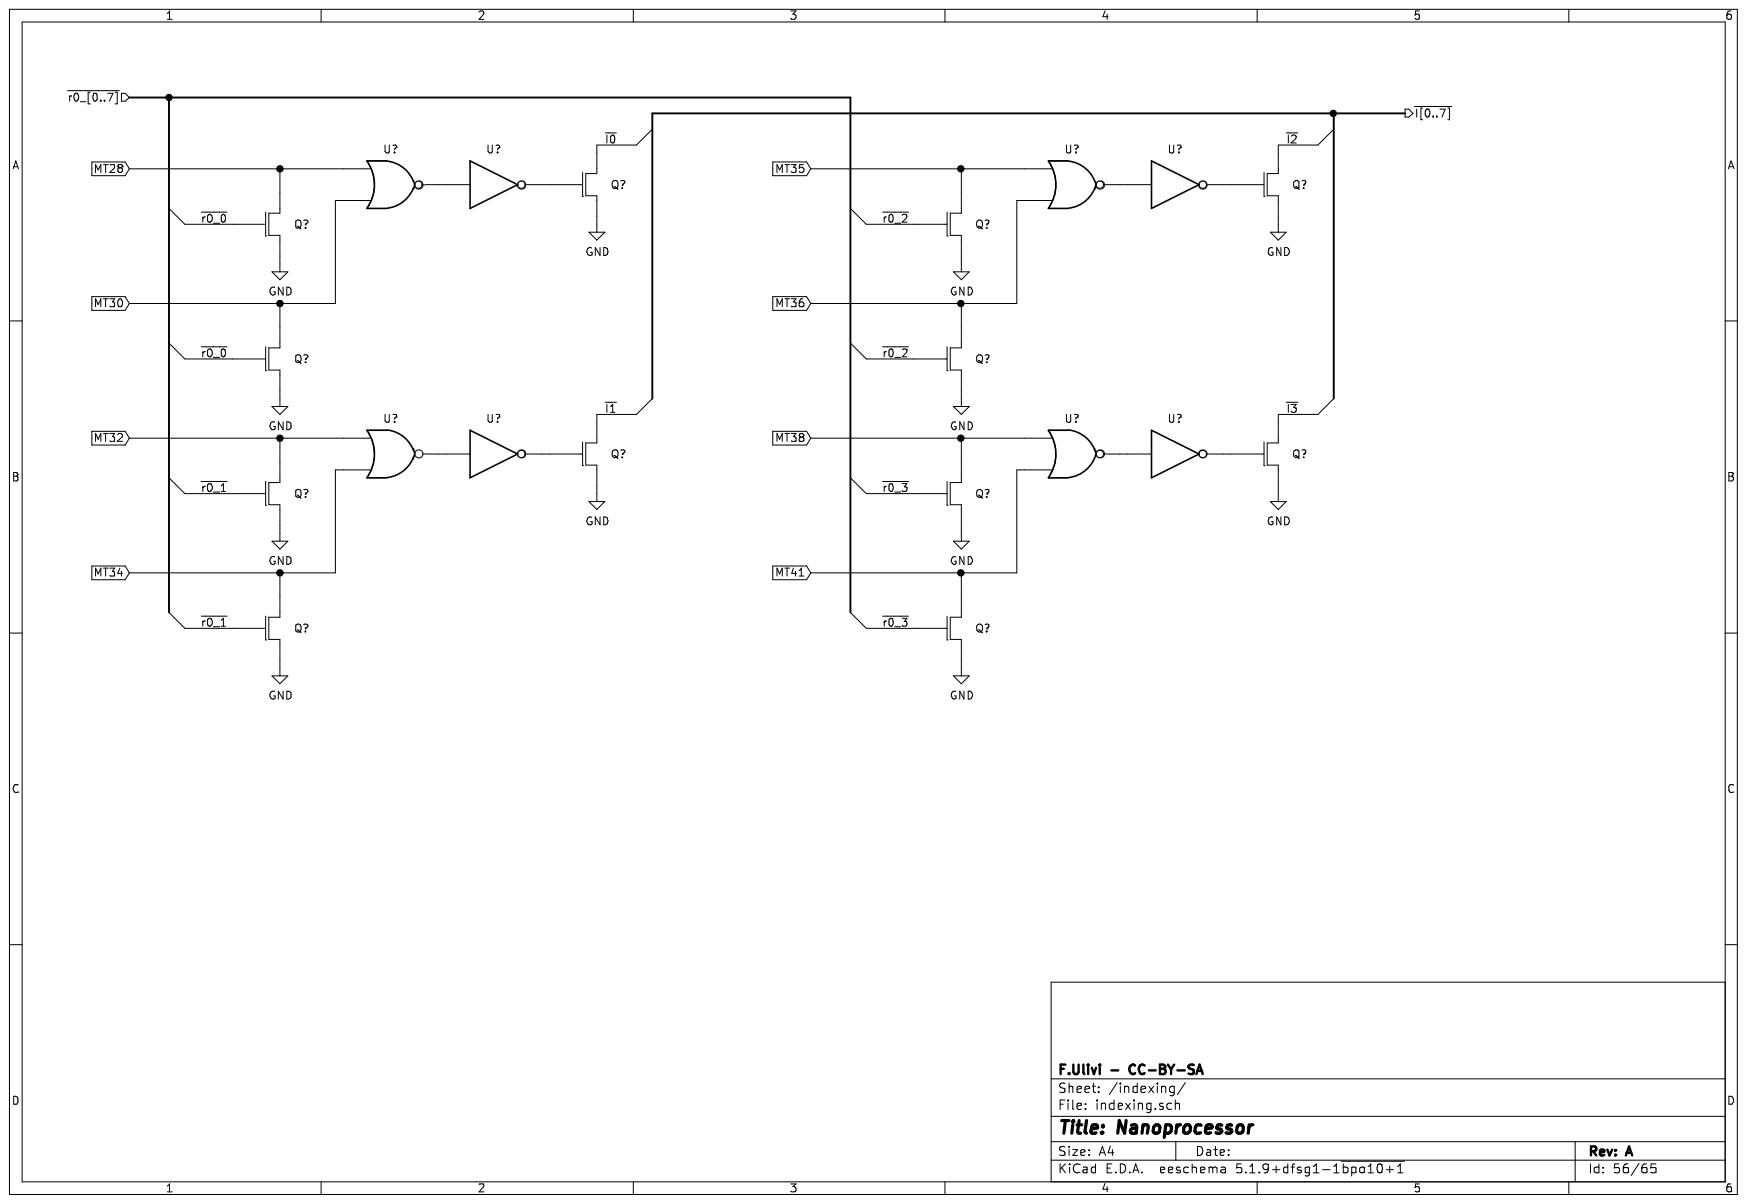
[picture p49: page 56]

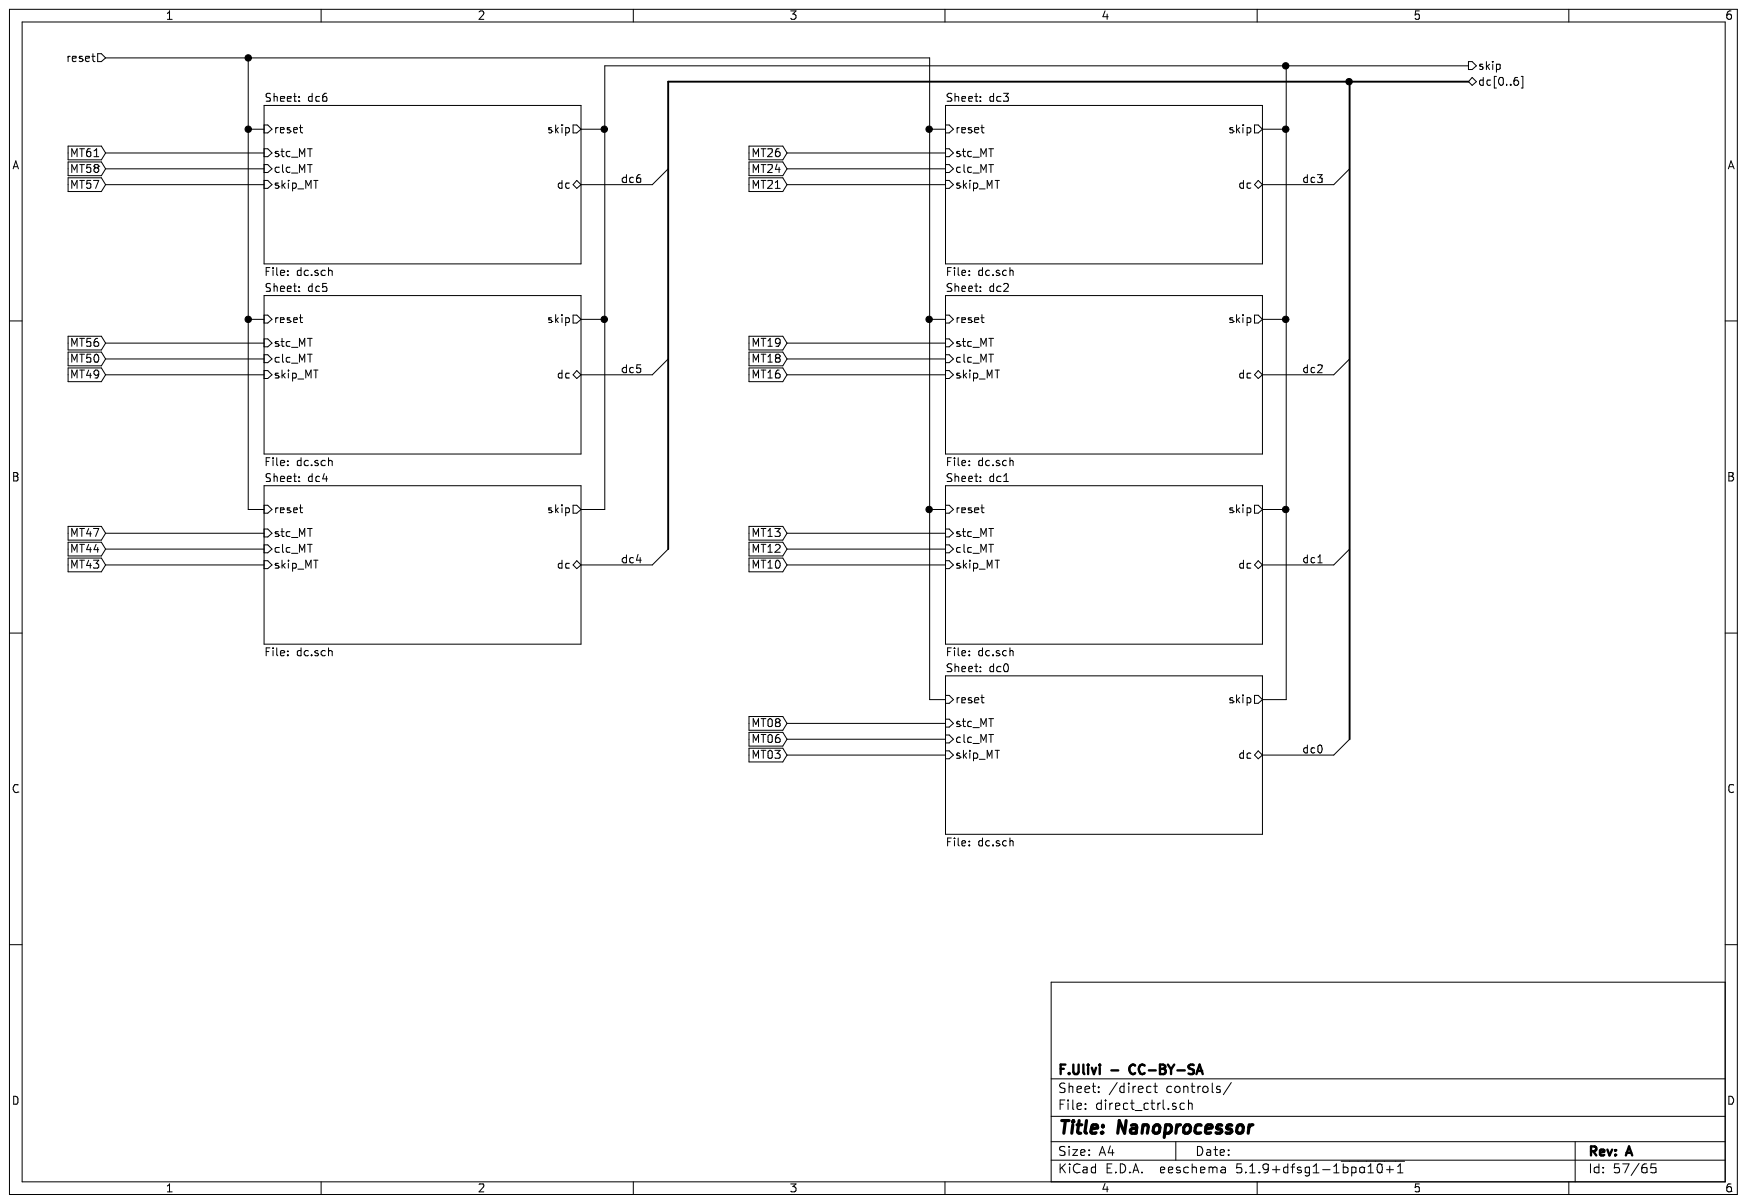
[picture p50: page 57]

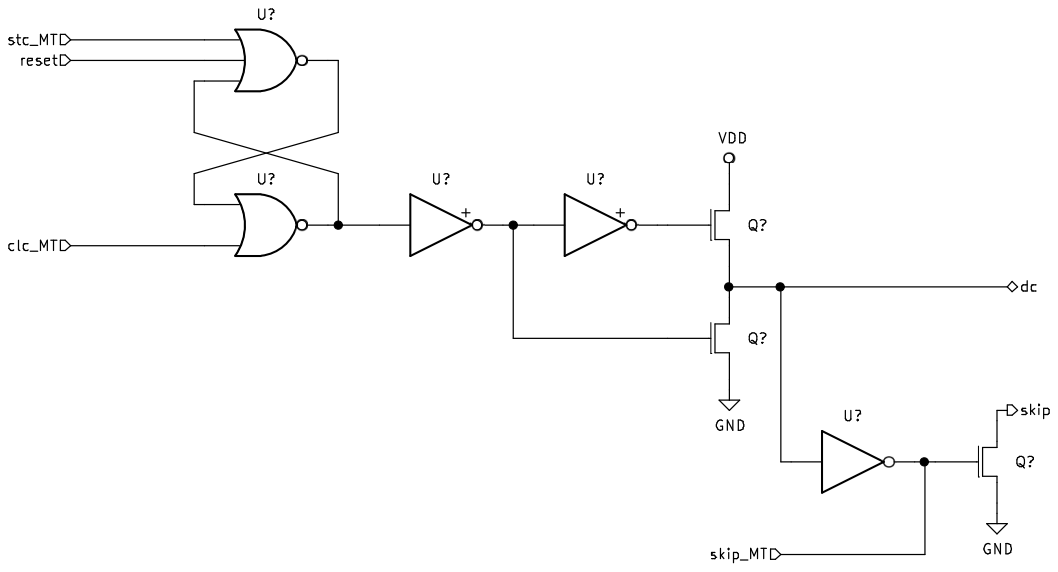
[picture p51: page 58]

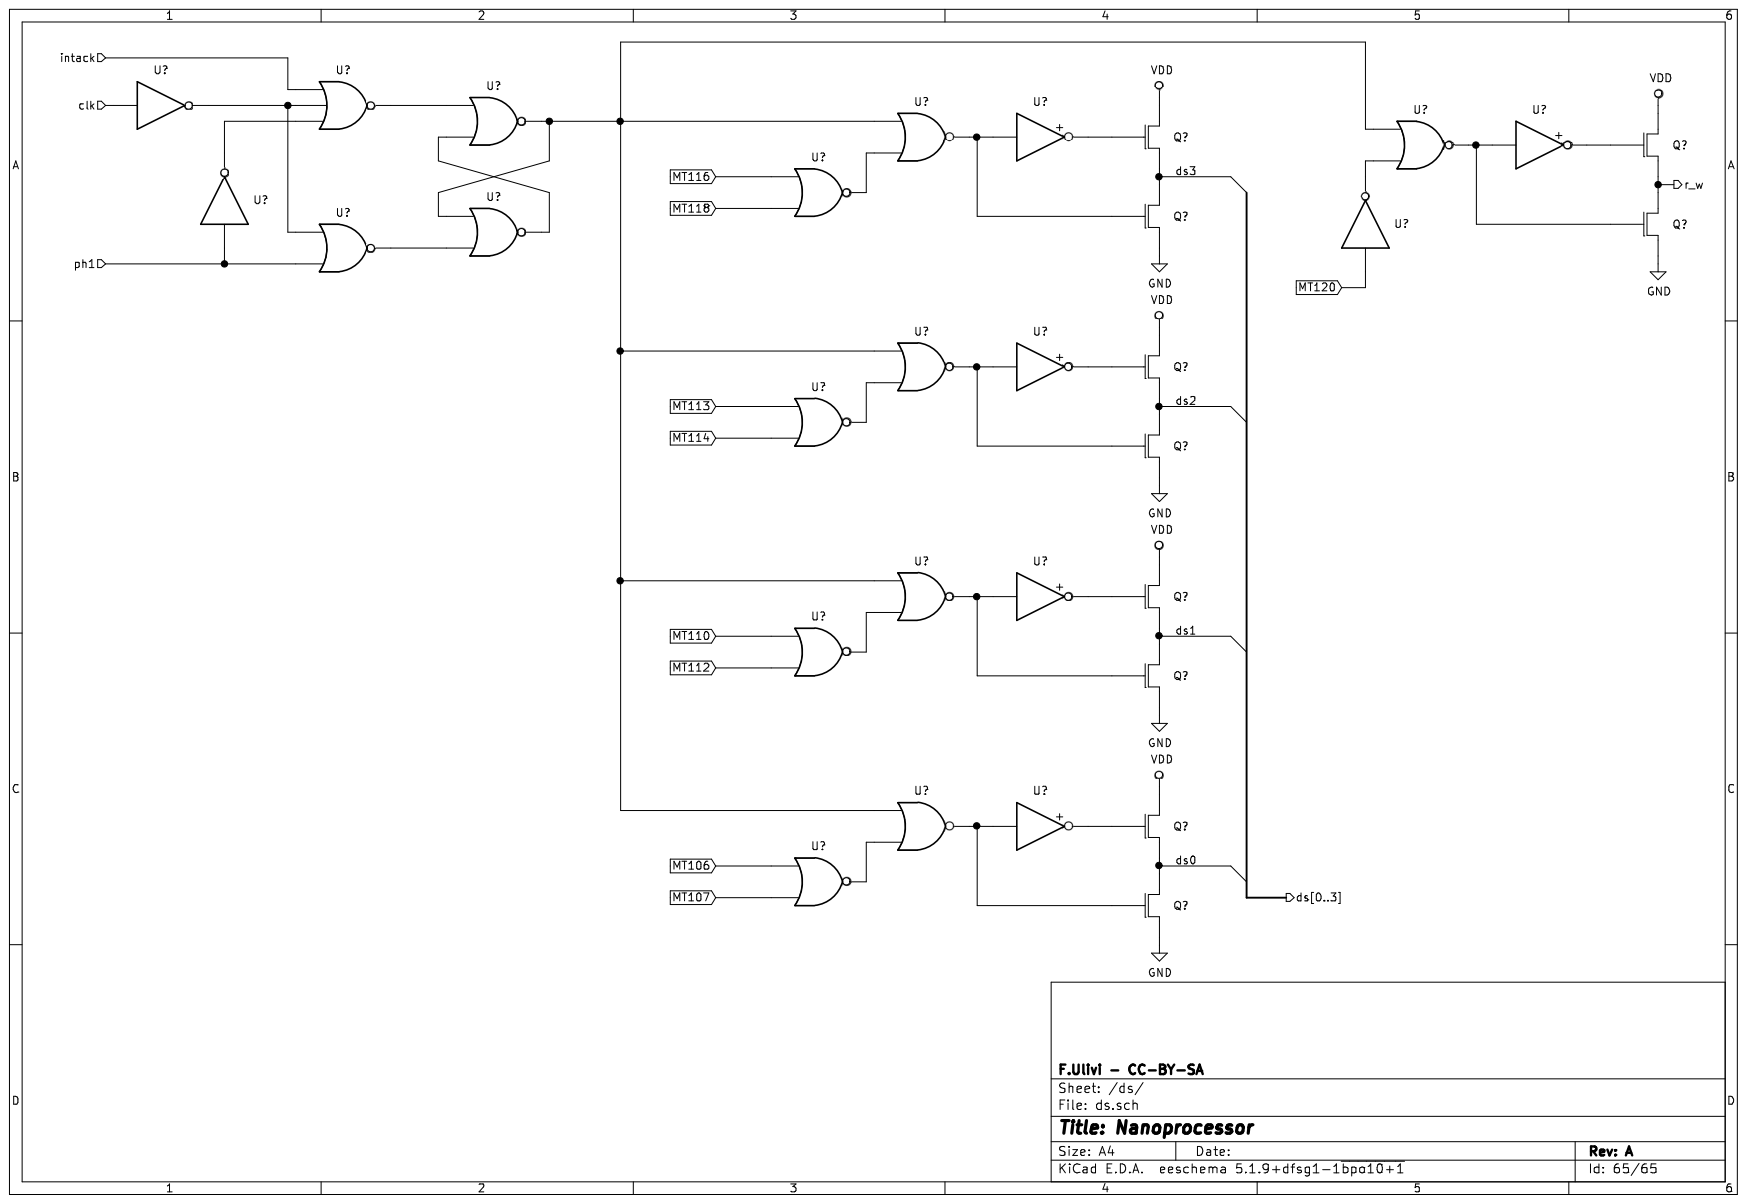
[picture p52: page 65]
