fulivi/nanoprocessor_re/schematics/accumulator_bit.sch

## KiCad design schematics/accumulator_bit.sch (2021-06-06)

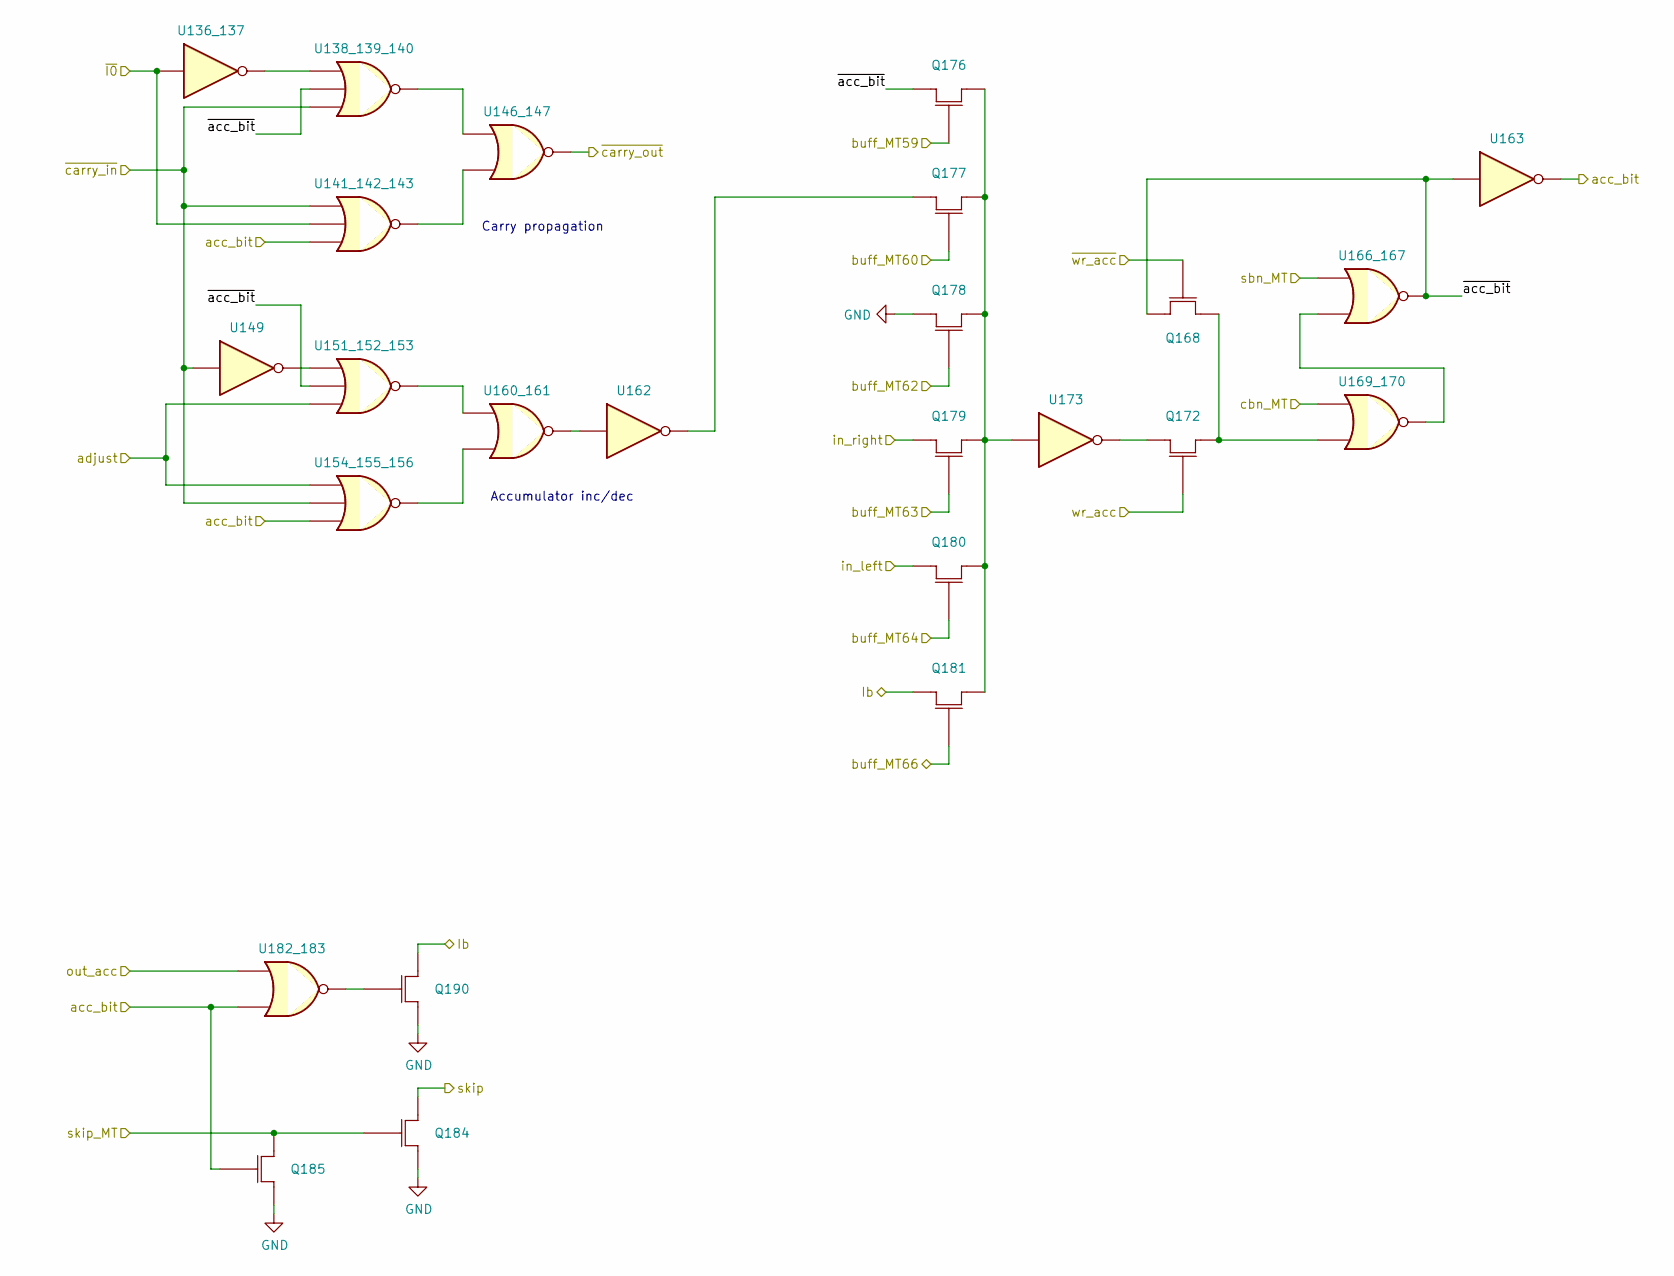
[picture p53: schematic accumulator_bit.sch]

Parts:
Q168, Q172, Q176, Q177, Q178, Q179, Q180, Q181, Q184, Q185, Q190: NMOS_ENH
U136_137, U149, U162, U163, U173: Inverter
U138_139_140, U141_142_143, U151_152_153, U154_155_156: NOR3
U146_147, U160_161, U166_167, U169_170, U182_183: NOR2

Connections:
GND: Q178.~, Q184.~, Q185.~, Q190.~
Ib: Q181.~, Q190.~
unnamed: Q168.~, Q172.~, U169_170.3
unnamed: Q172.~, U173.2
unnamed: Q176.~, Q177.~, Q178.~, Q179.~, Q180.~, Q181.~, U173.1
unnamed: Q177.~, U162.2
unnamed: Q190.~, U182_183.1
unnamed: U136_137.2, U138_139_140.1
unnamed: U138_139_140.12, U146_147.2
unnamed: U141_142_143.12, U146_147.3
unnamed: U149.2, U151_152_153.1
unnamed: U151_152_153.12, U160_161.2
unnamed: U154_155_156.12, U160_161.3
unnamed: U160_161.1, U162.1
unnamed: U166_167.3, U169_170.1
acc_bit: Q185.~, U141_142_143.13, U154_155_156.13, U163.2, U182_183.3
adjust: U151_152_153.13, U154_155_156.1
buff_MT59: Q176.~
buff_MT60: Q177.~
buff_MT62: Q178.~
buff_MT63: Q179.~
buff_MT64: Q180.~
buff_MT66: Q181.~
cbn_MT: U169_170.2
in_left: Q180.~
in_right: Q179.~
out_acc: U182_183.2
sbn_MT: U166_167.2
skip: Q184.~
skip_MT: Q184.~, Q185.~
wr_acc: Q172.~
~I0: U136_137.1, U141_142_143.2
~acc_bit: Q168.~, Q176.~, U138_139_140.2, U151_152_153.2, U163.1, U166_167.1
~carry_in: U138_139_140.13, U141_142_143.1, U149.1, U154_155_156.2
~carry_out: U146_147.1
~wr_acc: Q168.~

Notes on the sheet:
Carry propagation
Accumulator inc/dec
