fulivi/nanoprocessor_re/schematics/carry.sch

## KiCad design schematics/carry.sch (2021-06-06)

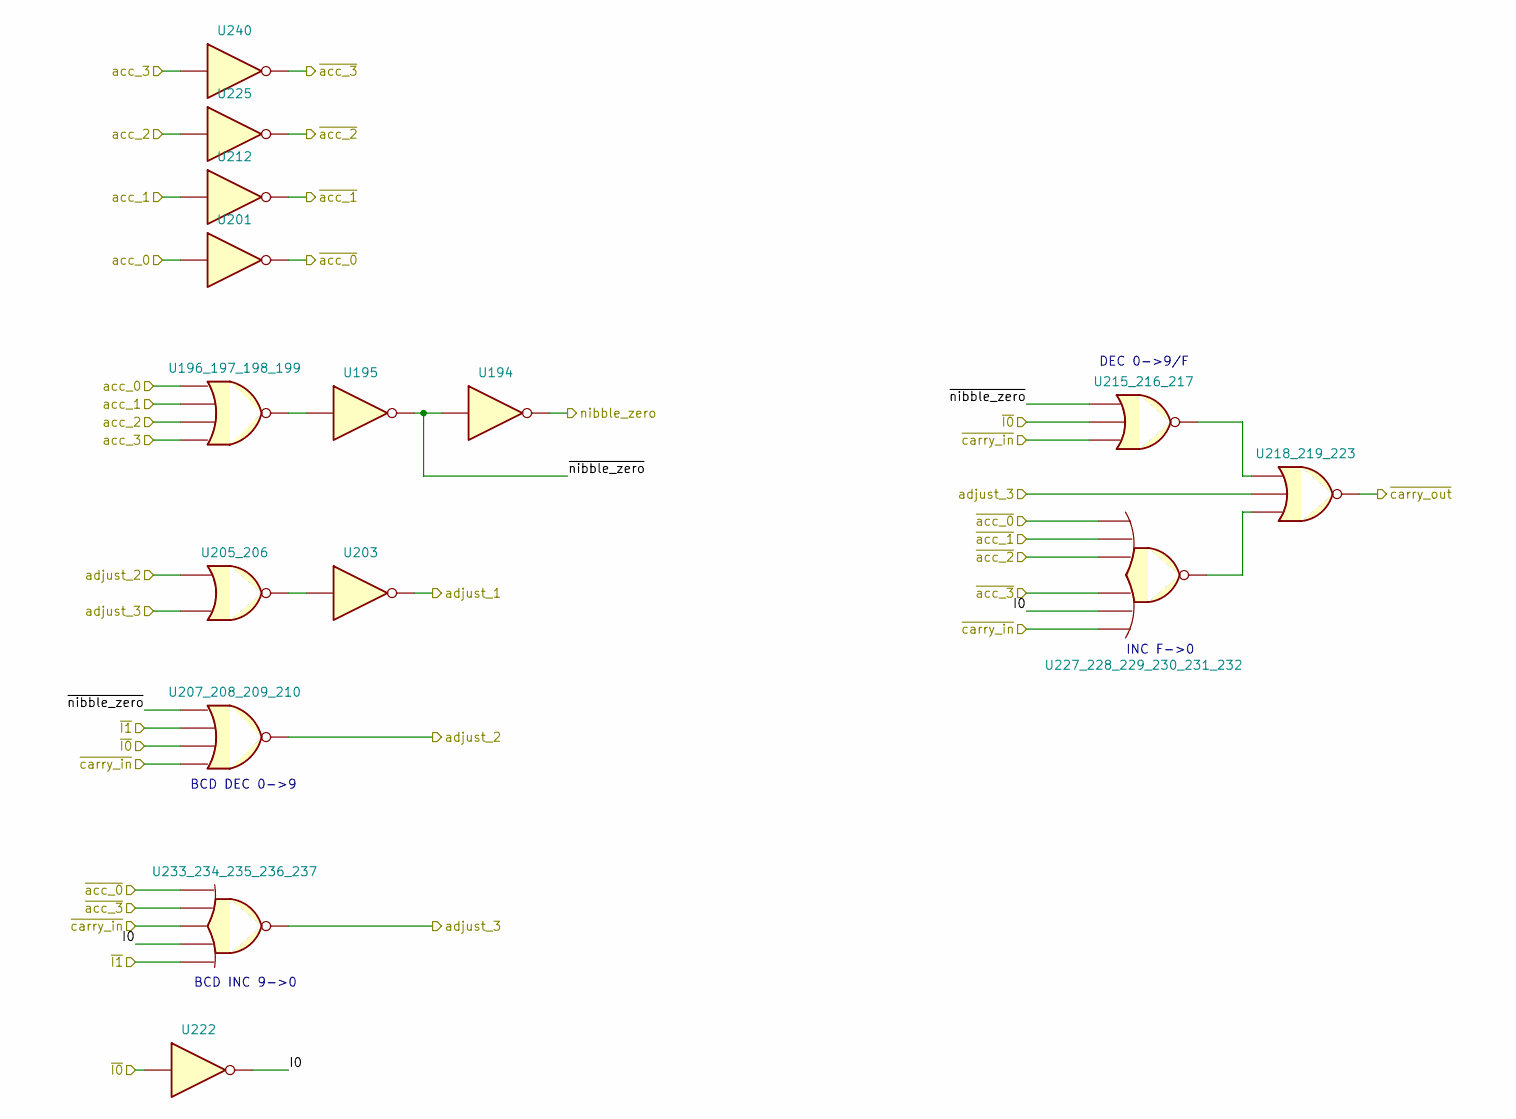
[picture p54: schematic carry.sch]

Parts:
U194, U195, U201, U203, U212, U222, U225, U240: Inverter
U196_197_198_199, U207_208_209_210: NOR4
U205_206: NOR2
U215_216_217, U218_219_223: NOR3
U227_228_229_230_231_232: NOR6
U233_234_235_236_237: NOR5

Connections:
I0: U222.2, U227_228_229_230_231_232.~, U233_234_235_236_237.3
unnamed: U195.1, U196_197_198_199.1
unnamed: U203.1, U205_206.1
unnamed: U215_216_217.12, U218_219_223.1
unnamed: U218_219_223.13, U227_228_229_230_231_232.1
acc_0: U196_197_198_199.2, U201.1
acc_1: U196_197_198_199.3, U212.1
acc_2: U196_197_198_199.4, U225.1
acc_3: U196_197_198_199.5, U240.1
adjust_1: U203.2
adjust_2: U205_206.2, U207_208_209_210.1
adjust_3: U205_206.3, U218_219_223.2, U233_234_235_236_237.1
nibble_zero: U194.2
~I0: U207_208_209_210.4, U215_216_217.2, U222.1
~I1: U207_208_209_210.3, U233_234_235_236_237.~
~acc_0: U201.2, U227_228_229_230_231_232.~, U233_234_235_236_237.~
~acc_1: U212.2, U227_228_229_230_231_232.~
~acc_2: U225.2, U227_228_229_230_231_232.2
~acc_3: U227_228_229_230_231_232.3, U233_234_235_236_237.2, U240.2
~carry_in: U207_208_209_210.5, U215_216_217.13, U227_228_229_230_231_232.~, U233_234_235_236_237.~
~carry_out: U218_219_223.12
~nibble_zero: U194.1, U195.2, U207_208_209_210.2, U215_216_217.1

Notes on the sheet:
BCD DEC 0->9
DEC 0->9/F
INC F->0
BCD INC 9->0
