fulivi/nanoprocessor_re/schematics/clock.sch

## KiCad design schematics/clock.sch (2021-06-06)

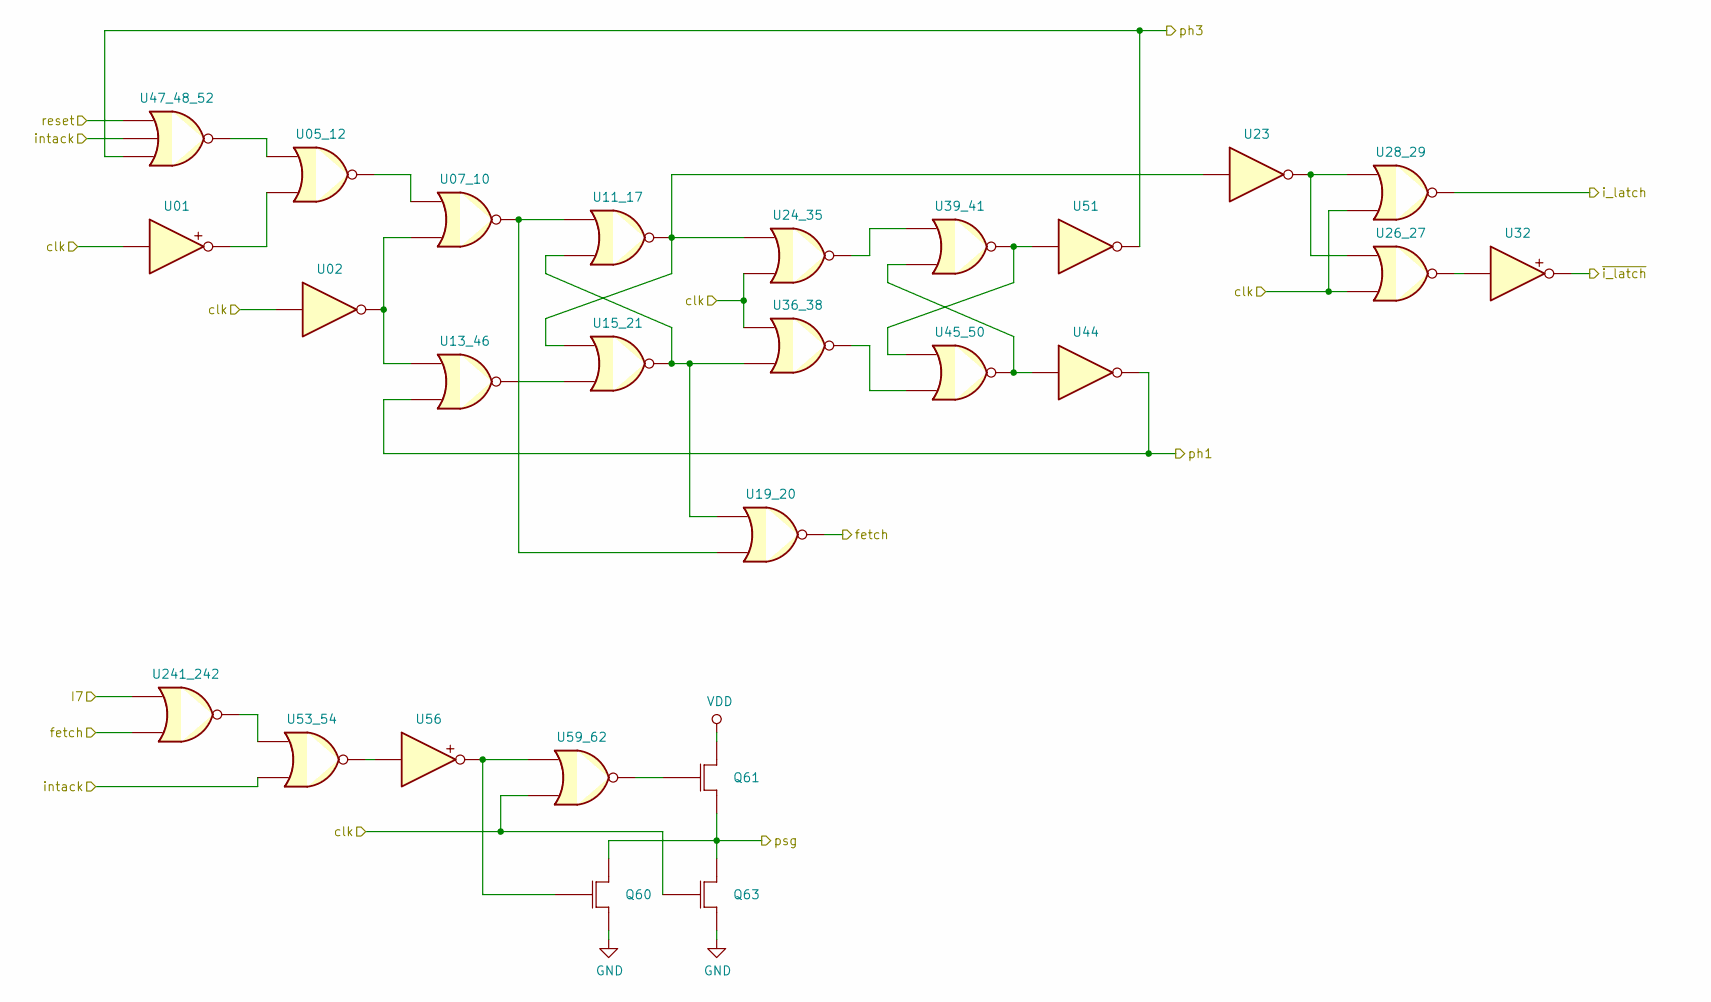
[picture p55: schematic clock.sch]

Parts:
Q60, Q61, Q63: NMOS_ENH
U01, U32, U56: Inverter_p
U02, U23, U44, U51: Inverter
U05_12, U07_10, U11_17, U13_46, U15_21, U19_20, U24_35, U26_27, U28_29, U36_38, U39_41, U45_50, U53_54, U59_62, U241_242: NOR2
U47_48_52: NOR3

Connections:
GND: Q60.~, Q63.~
I7: U241_242.2
unnamed: Q60.~, U56.2, U59_62.2
unnamed: Q61.~, U59_62.1
unnamed: U01.2, U05_12.3
unnamed: U02.2, U07_10.3, U13_46.2
unnamed: U05_12.1, U07_10.2
unnamed: U05_12.2, U47_48_52.12
unnamed: U07_10.1, U11_17.2, U19_20.3
unnamed: U11_17.1, U15_21.2, U23.1, U24_35.2
unnamed: U11_17.3, U15_21.1, U19_20.2, U36_38.3
unnamed: U13_46.1, U15_21.3
unnamed: U23.2, U26_27.2, U28_29.2
unnamed: U24_35.1, U39_41.2
unnamed: U26_27.1, U32.1
unnamed: U36_38.1, U45_50.3
unnamed: U39_41.1, U45_50.2, U51.1
unnamed: U39_41.3, U44.1, U45_50.1
unnamed: U53_54.1, U56.1
unnamed: U53_54.2, U241_242.1
VDD: Q61.~
clk: Q63.~, U01.1, U02.1, U24_35.3, U26_27.3, U28_29.3, U36_38.2, U59_62.3
fetch: U19_20.1, U241_242.3
i_latch: U28_29.1
intack: U47_48_52.2, U53_54.3
ph1: U13_46.3, U44.2
ph3: U47_48_52.13, U51.2
psg: Q60.~, Q61.~, Q63.~
reset: U47_48_52.1
~i_latch: U32.2
