fulivi/nanoprocessor_re/schematics/data_bus.sch

## KiCad design schematics/data_bus.sch (2021-06-06)

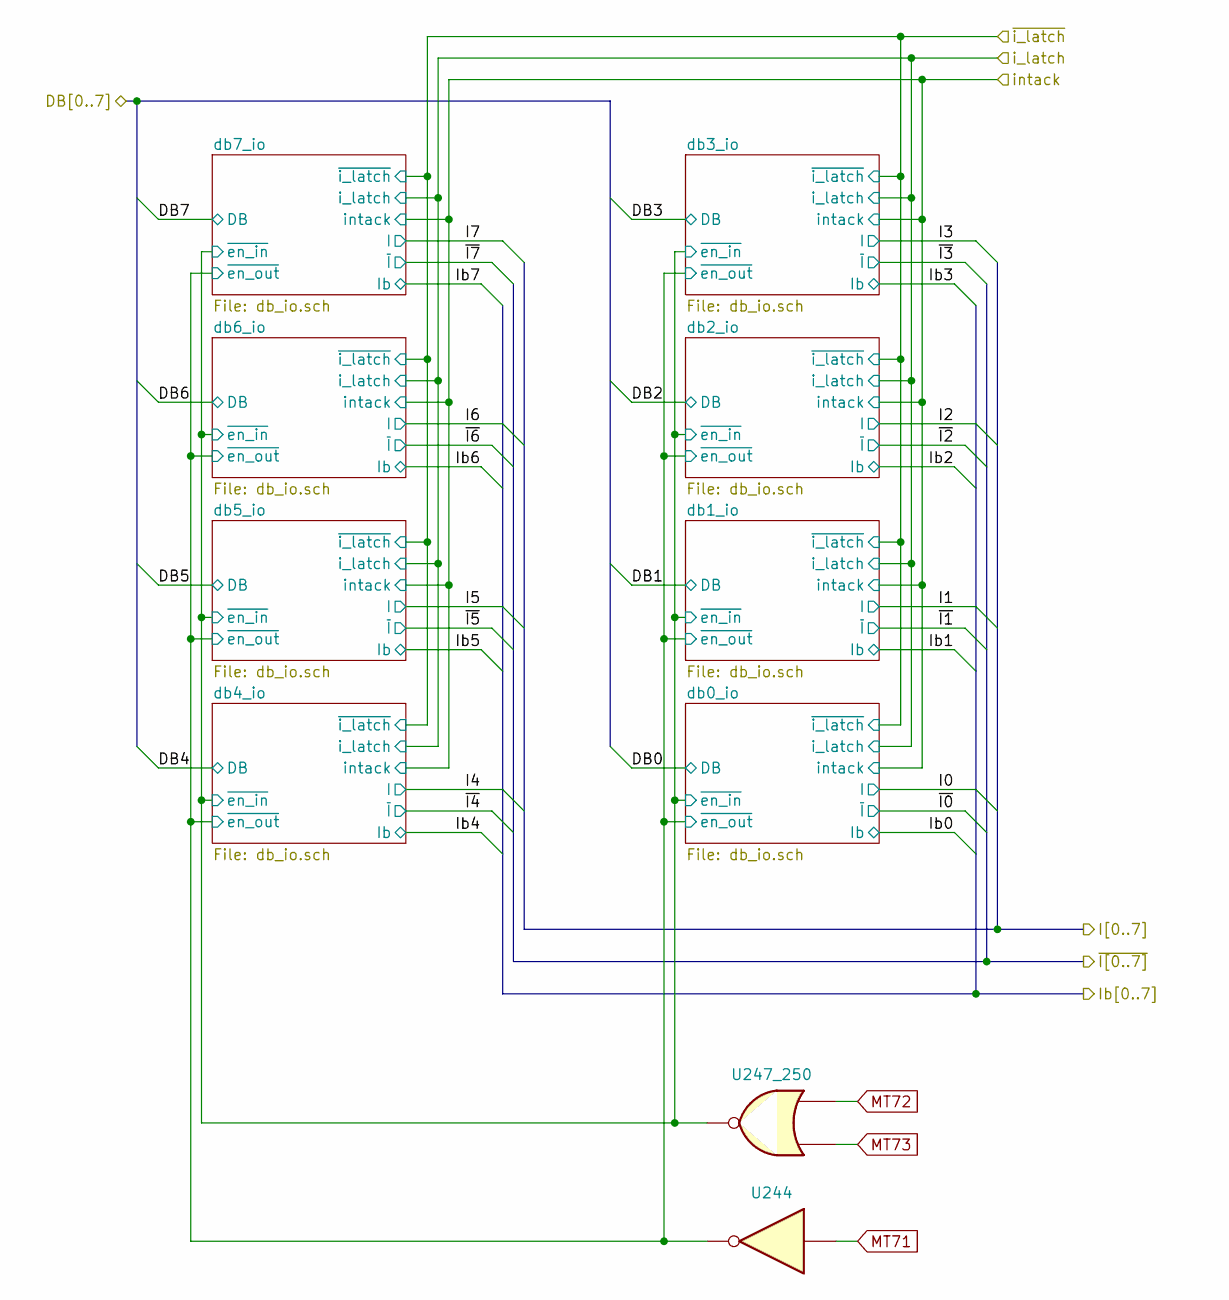
[picture p56: schematic data_bus.sch]

Parts:
U244: Inverter
U247_250: NOR2

Connections:
DB0: U244.2
MT71: U244.1
MT72: U247_250.2
MT73: U247_250.3
~en_in: U247_250.1
