fulivi/nanoprocessor_re/schematics/db_io.sch

## KiCad design schematics/db_io.sch (2021-06-06)

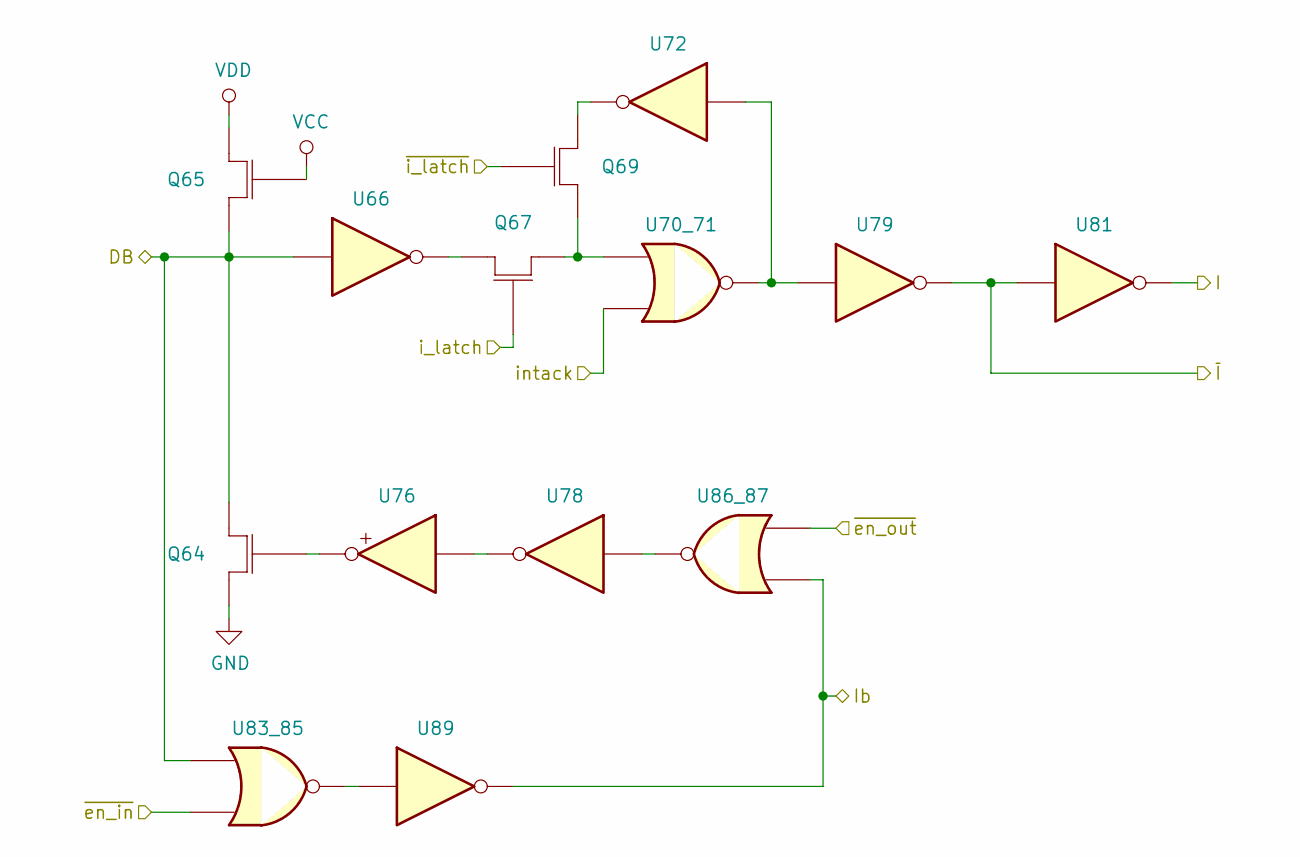
[picture p57: schematic db_io.sch]

Parts:
Q64, Q65, Q67, Q69: NMOS_ENH
U66, U72, U78, U79, U81, U89: Inverter
U70_71, U83_85, U86_87: NOR2
U76: Inverter_p

Connections:
DB: Q64.~, Q65.~, U66.1, U83_85.2
GND: Q64.~
I: U81.2
Ib: U86_87.3, U89.2
unnamed: Q64.~, U76.2
unnamed: Q67.~, Q69.~, U66.2, U70_71.2
unnamed: Q69.~, U72.2
unnamed: U70_71.1, U72.1, U79.1
unnamed: U76.1, U78.2
unnamed: U78.1, U86_87.1
unnamed: U83_85.1, U89.1
VCC: Q65.~
VDD: Q65.~
i_latch: Q67.~
intack: U70_71.3
~I: U79.2, U81.1
~en_in: U83_85.3
~en_out: U86_87.2
~i_latch: Q69.~
