fulivi/nanoprocessor_re/schematics/int.sch

## KiCad design schematics/int.sch (2021-06-06)

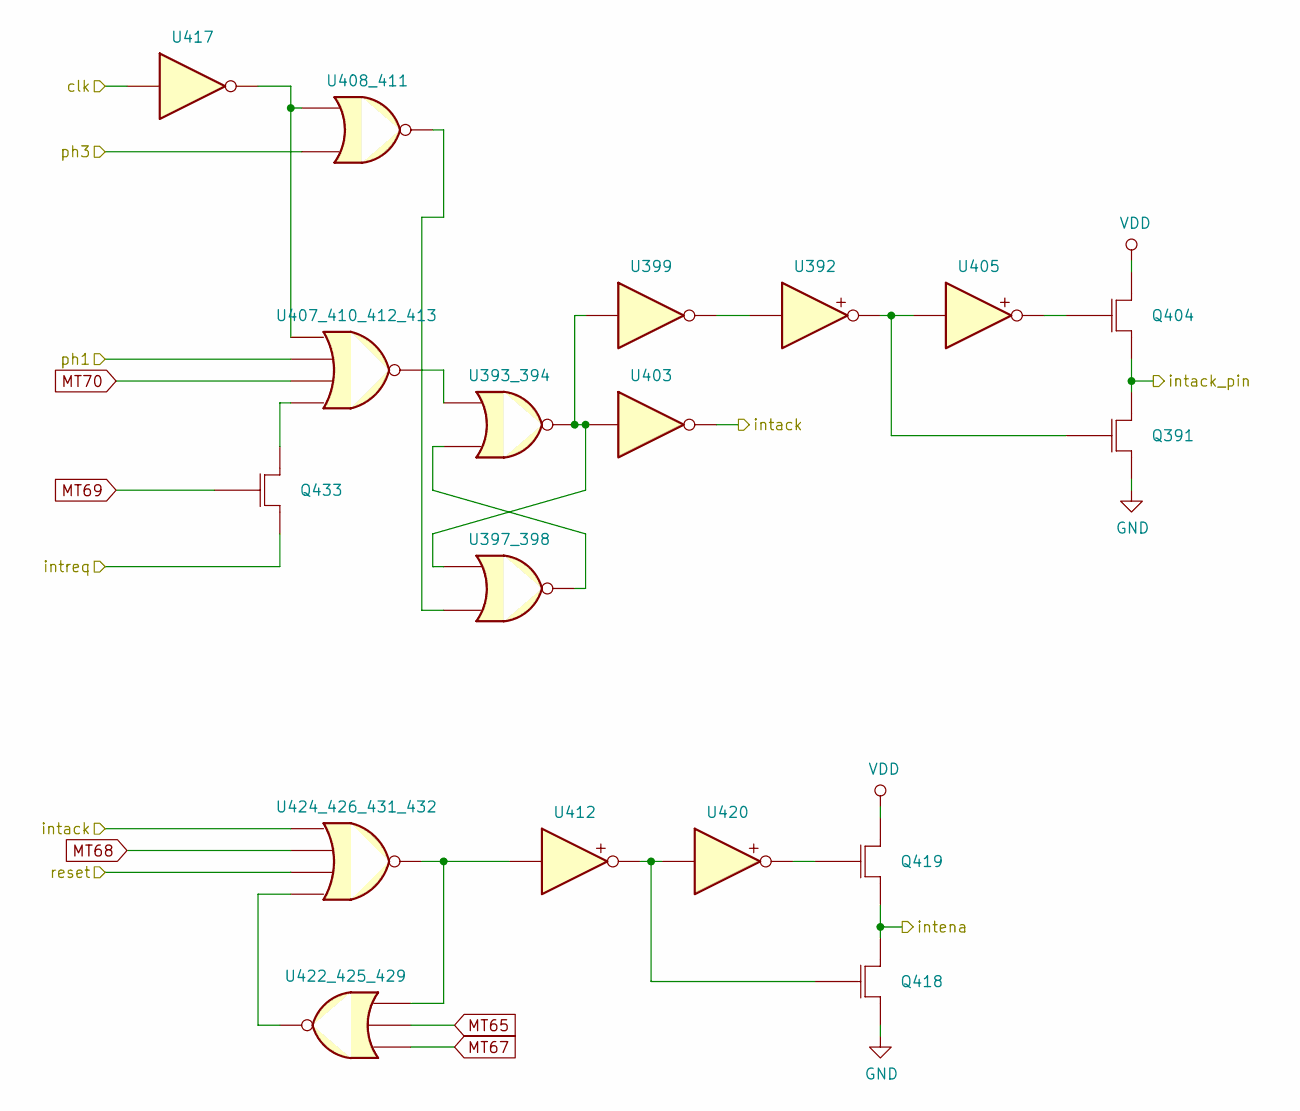
[picture p58: schematic int.sch]

Parts:
Q391, Q404, Q418, Q419, Q433: NMOS_ENH
U392, U405, U412, U420: Inverter_p
U393_394, U397_398, U408_411: NOR2
U399, U403, U417: Inverter
U407_410_412_413, U424_426_431_432: NOR4
U422_425_429: NOR3

Connections:
GND: Q391.~, Q418.~
MT65: U422_425_429.2
MT67: U422_425_429.13
MT68: U424_426_431_432.3
MT69: Q433.~
MT70: U407_410_412_413.4
unnamed: Q391.~, U392.2, U405.1
unnamed: Q404.~, U405.2
unnamed: Q418.~, U412.2, U420.1
unnamed: Q419.~, U420.2
unnamed: Q433.~, U407_410_412_413.5
unnamed: U392.1, U399.2
unnamed: U393_394.1, U397_398.2, U399.1, U403.1
unnamed: U393_394.2, U407_410_412_413.1
unnamed: U393_394.3, U397_398.1
unnamed: U397_398.3, U408_411.1
unnamed: U407_410_412_413.2, U408_411.2, U417.2
unnamed: U412.1, U422_425_429.1, U424_426_431_432.1
unnamed: U422_425_429.12, U424_426_431_432.5
VDD: Q404.~, Q419.~
clk: U417.1
intack: U403.2, U424_426_431_432.2
intack_pin: Q391.~, Q404.~
intena: Q418.~, Q419.~
intreq: Q433.~
ph1: U407_410_412_413.3
ph3: U408_411.3
reset: U424_426_431_432.4
