fulivi/nanoprocessor_re/schematics/pa.sch

## KiCad design schematics/pa.sch (2021-06-06)

Schematic: pa.sch

Parts:
Q383, Q386: NMOS_ENH
U271_280, U310_311, U313_314, U330_331, U337_338, U343_349, U369_370: NOR2
U304, U324, U330, U390: Inverter
U317, U320, U323, U327, U334, U335, U336, U342, U351, U352, U356, U364, U367, U381, U382: Inverter_p
U353_354_355: NOR3
