fulivi/nanoprocessor_re/schematics/pa_bit.sch

## KiCad design schematics/pa_bit.sch (2021-06-06)

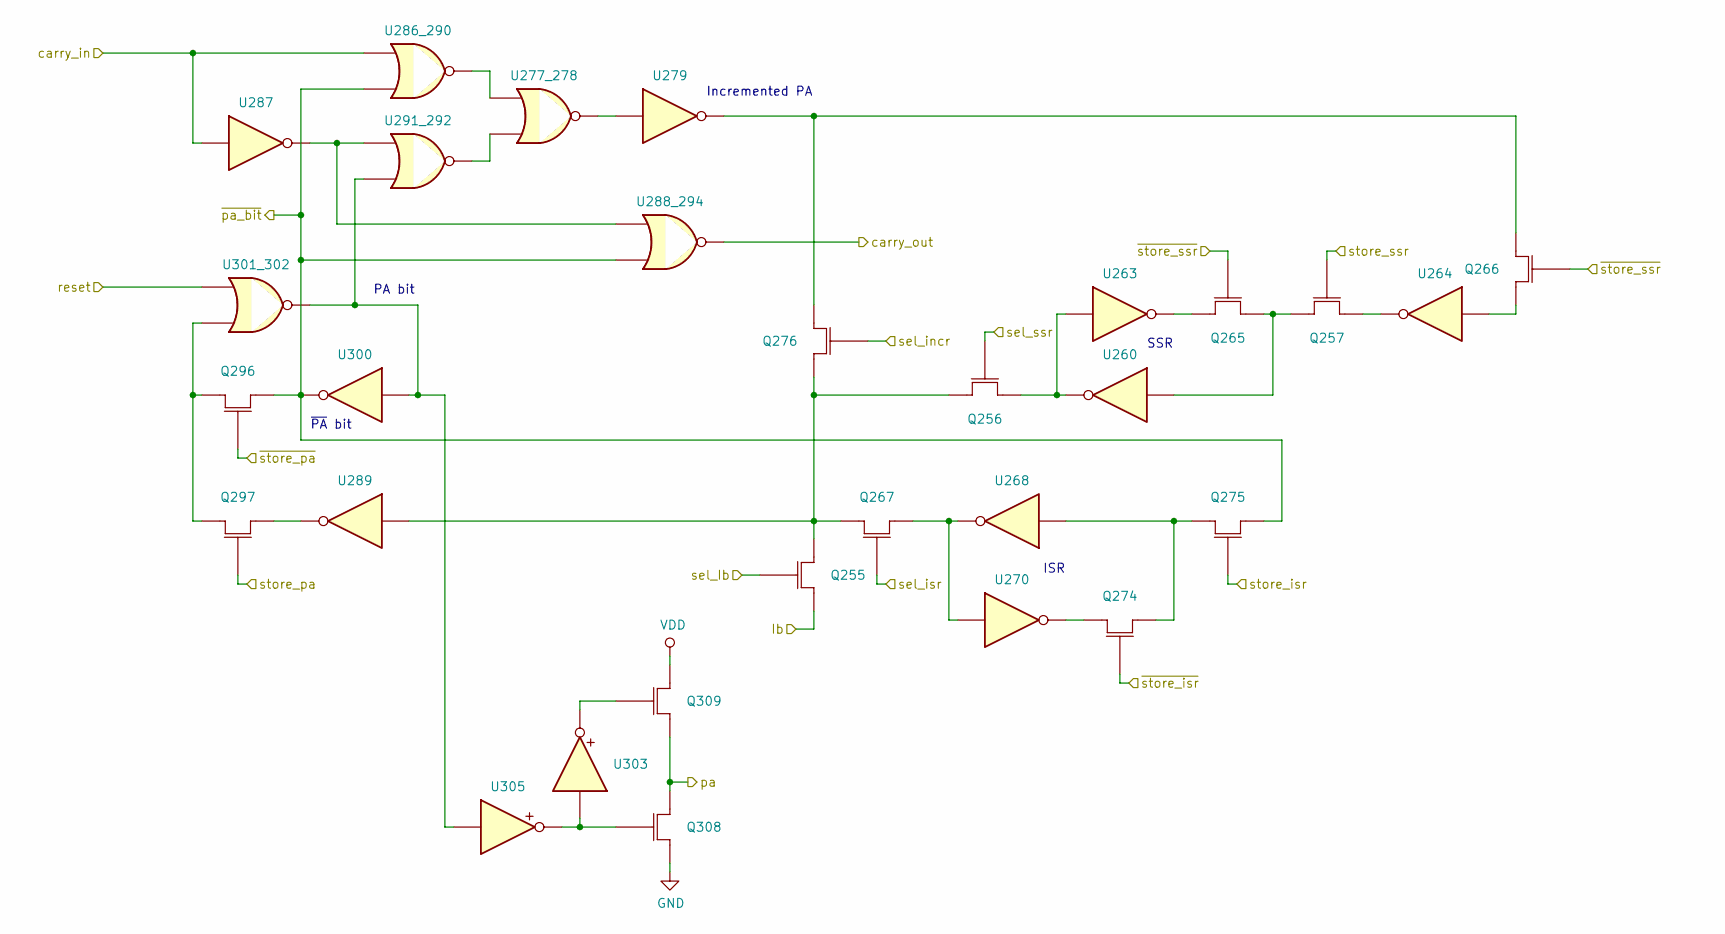
[picture p59: schematic pa_bit.sch]

Parts:
Q255, Q256, Q257, Q265, Q266, Q267, Q274, Q275, Q276, Q296, Q297, Q308, Q309: NMOS_ENH
U260, U263, U264, U268, U270, U279, U287, U289, U300: Inverter
U277_278, U286_290, U288_294, U291_292, U301_302: NOR2
U303, U305: Inverter_p

Connections:
GND: Q308.~
Ib: Q255.~
unnamed: Q255.~, Q256.~, Q267.~, Q276.~, U289.1
unnamed: Q256.~, U260.2, U263.1
unnamed: Q257.~, Q265.~, U260.1, U264.2
unnamed: Q265.~, U263.2
unnamed: Q266.~, Q276.~, U264.1, U279.2
unnamed: Q267.~, U268.2, U270.1
unnamed: Q274.~, Q275.~, U268.1, U270.2
unnamed: Q296.~, Q297.~, U301_302.3
unnamed: Q297.~, U289.2
unnamed: Q308.~, U303.1, U305.2
unnamed: Q309.~, U303.2
unnamed: U277_278.1, U279.1
unnamed: U277_278.2, U286_290.1
unnamed: U277_278.3, U291_292.1
unnamed: U287.2, U288_294.2, U291_292.2
unnamed: U291_292.3, U300.1, U301_302.1, U305.1
VDD: Q309.~
carry_in: U286_290.2, U287.1
carry_out: U288_294.1
pa: Q308.~, Q309.~
reset: U301_302.2
sel_Ib: Q255.~
sel_incr: Q276.~
sel_isr: Q267.~
sel_ssr: Q256.~
store_isr: Q275.~
store_pa: Q297.~
store_ssr: Q257.~
~pa_bit: Q275.~, Q296.~, U286_290.3, U288_294.3, U300.2
~store_isr: Q274.~
~store_pa: Q296.~
~store_ssr: Q265.~, Q266.~

Notes on the sheet:
PA bit
~PA bit
Incremented PA
ISR
SSR
