fulivi/nanoprocessor_re/schematics/reset.sch

## KiCad design schematics/reset.sch (2021-06-06)

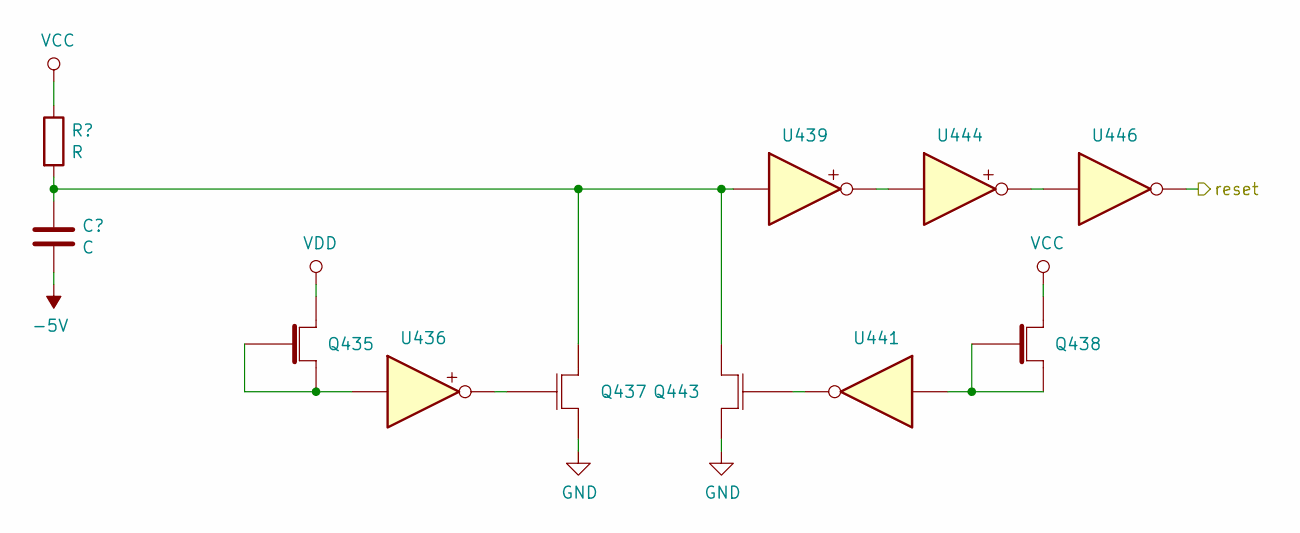
[picture p60: schematic reset.sch]

Parts:
Q435, Q438: NMOS_DEP
Q437, Q443: NMOS_ENH
U436, U439, U444: Inverter_p
U441, U446: Inverter

Connections:
GND: Q437.~, Q443.~
unnamed: Q435.~, U436.1
unnamed: Q437.~, Q443.~, U436.2, U439.1
unnamed: Q438.~, U441.1
unnamed: Q443.~, U441.2
unnamed: U439.2, U444.1
unnamed: U444.2, U446.1
VCC: Q438.~
VDD: Q435.~
reset: U446.2
