fulivi/nanoprocessor_re/(notices)

Notices in the files:
schematics/reset.sch:
F.Ulivi - CC-BY-SA
